barthess/volat3/soft/face/examples/test-drive-11.jpg

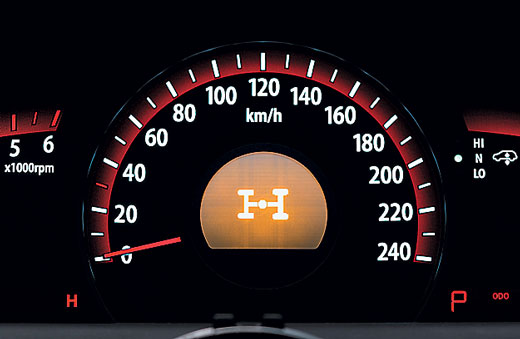
soft/face/examples/test-drive-11.jpg
