barthess/volat3/soft/face/examples/hyundai_grandeur_svision400.jpg

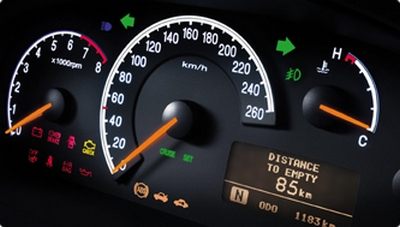
soft/face/examples/hyundai_grandeur_svision400.jpg
