barthess/volat3/doc/templates/passport/specs.tex

\section{Основные сведения об изделии и технические данные}
  \subsection{Основные сведения об изделии}
  
  %Предназначение
  \input{destination}
  
    \point {\nameDeviceAbbr} соответствует  группе  1.7  исполнения  О  по
      \gost{В 20.39.304-76} с уточнениями, приведенными 
      в~\ref{pt:impact_factors}.
    \point Наименование "--- \nameDevice.
    \point Обозначение "--- \ksauDevice.
    \point Изготовитель "--- \nameManufacturer.\par\bigskip
    \begin{tabular}{@{}ll}
      \multicolumn{2}{@{}l}{\addressManufacturer}\\
      тел./факс:  &(0-17) 200-57-98\\
      тел.:   &(0-17) 222-17-89\\
      e-mail :  &kamerton@kamerton.by\\
    \end{tabular}
    \par\bigskip
    \makebox[0.5\textwidth]{Заводской номер \hrulefill}\par 
    \makebox[0.5\textwidth]{Дата изготовления \hrulefill}

\newpage
  \subsection{Технические характеристики}
    \point Основные технические данные {\genitivecasename} приведены в 
    таблице~\ref{tab:replicator_specs}.

    \begin{table}[h]
      \caption{Основные технические характеристики {\genitivecasename}}
      \label{tab:replicator_specs}
      \input{./specs_table.tex}
    \end{table}

\newpage
    \point Значения внешних воздействующих факторов приведены 
      в таблице~\ref{tab:env_impact}.
      \label{pt:impact_factors}

    {
    \par
    \setcounter{tablerowcounter}{0} %сброс счетчика колонок (для самопального макроса \inTableEnum)
    \begin{table}[h!]
      \caption{Предельно допустимые значения внешних воздействующих факторов}
      \label{tab:env_impact}
      \input{\rootdir/documents/logbook/impact_table}
    \end{table}
    \par
    }

  \subsection{Показатель надёжности}
    Средняя наработка на отказ \genitivecasename "--- \MTBF~ч. 
    Критерий отказа "--- несоответствие значений параметров 
    техническим характеристикам, приведенным в 
    настоящем \MakeLowercase{\ESKDtheDocName}е.

  \subsection{Сведения о содержании драгоценных материалов и цветных
    металлов}
    \point В {\prepositionalcasename} содержатся следующие драгоценные 
      материалы\footnote{Сведения о содержании драгоценных материалов
      приведены комиссионно.}:

    \begin{itemize}
      \item \makebox[0.3\textwidth]{золото "--- \hfill г};
      \item \makebox[0.3\textwidth]{серебро "--- \hfill г}.
    \end{itemize}

    \point В {\prepositionalcasename} содержится алюминия и алюминиевых
      \mbox{сплавов "---\qquad\qquad кг}.
