barthess/volat3/doc/documents/component_parts/uvvu/ps/specs_data_additional.tex

% Tут собраны для основные технические спецификации
% устройства. 
% В отдельный файл они были вынесены исключительно
% для удобства включения в другие документы (например,
% руководство по эксплуатации)
 
\renewcommand{\nominalsupplypower}{20} % потребляемая мощность, ватты
