barthess/volat3/doc/documents/component_parts/uvvu/ps/specs_table.tex

% таблица просто форматирует включенные в нее данные

% данные для заполнения нижеследующей таблицы
\input{specs_data_additional.tex}

\begin{tabularx}{\textwidth}{|X|p{3.1cm}|p{3.1cm}|}
  \hline
  %--- шапка---------------------------------
  \multicolumn{1}{|c|}{Наименование параметра}&
  \multicolumn{1}{c|}{Значение}&
  \multicolumn{1}{c|}{Примечания}\\\hline 
  
  %-----содержимое---------------------------
  \setcounter{tablerowcounter}{0}
  \inTableEnum Допустимое напряжение бортовой сети, В   &от~{\minsupplyvoltage} до~\maxsupplyvoltage &\\\hline
  \inTableEnum Потребляемая мощность, Вт                &\nominalsupplypowerUVVU, \mbox{не более}  &\\\hline
  \inTableEnum Время непрерывной работы, часов          &\continuousworkingtime, \mbox{не менее} &\\\hline
  \inTableEnum Габаритные размеры, мм                   &\dimensionsUVVU, \mbox{не более}&\\\hline
  \inTableEnum Масса, кг, не более                      &\massUVVU & \\\hline

\end{tabularx}
