barthess/volat3/doc/tex/hyphenation.tex

\hyphenation{
БИУС
ГОСТ
ГЛОНАСС
АНРЕЛ
АВДАТ
РЕПЛИКАТОР
ис-пол-ни-тель-ных
При-ме-ча-ние
при-ме-ча-ние
Мне-мо-ни-чес-кое
}
