barthess/volat3/doc/templates/passport/packing_certificate.tex

\newpage

\section{Свидетельство об упаковывании}

\noindent
\nameksaunumber
\bigskip\noindent%
%
\blankfieldtxt[c]{\textwidth}
  {\centering\nameManufacturer}
  {наименование или код изготовителя}
  {упакован}
  {}
  \par
%
\bigskip\noindent согласно требованиям, предусмотренным в действующей технической документации.

\bigskip
\noindent%
  \blankfieldtxt{0.3\textwidth}{}{должность}{}{} \hfill
  \blankfieldtxt{0.3\textwidth}{}{личная подпись}{}{} \hfill
  \blankfieldtxt{0.3\textwidth}{}{расшифровка}{}{}

\bigskip
\noindent
  \blankfieldtxt{0.5\textwidth}{}{год, месяц, число}{}{}
