barthess/volat3/doc/templates/passport/utilization.tex

\newpage

\section{Сведения об утилизации}
	Утилизацию {\genitivecasename} проводит потребитель 
	по действующим у него нормативным документам 
	и положениям.

	Элементы, содержащие драгоценные материалы, 
	при демонтаже {\genitivecasename} подлежат учету, 
	хранению и сдаче в установленном порядке.
