barthess/volat3/doc/templates/passport/warranty.tex

\newpage

% при использовании 14 шрифта этот пункт совсем чуть-чуть
% не помещается на странице. Уменьшим межстрочный интервал
% для данной страницы с 1.25 до 1.20
{
\makeatletter
\ifthenelse{\equal{\ESKD@docfont}{14pt}} 
      {\renewcommand{\baselinestretch}{1.20}\selectfont}
      {} 
\makeatother

\section{Ресурсы, сроки службы и хранения, гарантии изготовителя
  (поставщика)}
  \subsection{Ресурсы, сроки службы и хранения}
    Ресурс  до первого капитального ремонта "--- пять 
    лет (при средней наработке на отказ \MTBF~ч) в
    течение среднего срока службы 20 лет, в том числе 
    срок хранения пять лет в упаковке изготовителя в 
    закрытых неотапливаемых помещениях.

    Средний срок сохраняемости в упаковке изготовителя "---
    10 лет с переконсервацией через пять лет.

    Указанные ресурсы, срок службы и срок хранения 
    действительны при соблюдении потребителем требований, 
    установленных эксплуатационной документацией.

  \subsection{Гарантии изготовителя (поставщика)}
    Изготовитель гарантирует соответствие качества {\genitivecasename}
    требованиям действующей технической документации при 
    соблюдении потребителем правил эксплуатации, хранения и 
    транспортирования, установленных эксплуатационной документацией.

    Гарантийный срок хранения совместно с гарантийным сроком эксплуатации 
    10 лет со дня ввода в эксплуатацию, но не более 11 лет со дня изготовления.

    Восстановление {\genitivecasename},
    \ifthenelse{\equal{\gender}{female}}
    {вышедшей}
    {вышедшего}
    из строя в течение 
    гарантийного срока, осуществляется за счет изготовителя. 
    При восстановлении (более суток) в гарантийный период, срок 
    гарантии на 
    \ifthenelse{\equal{\nameDevice}{\nameDeviceAbbr}}
    {\nameDeviceAbbr}
    {\MakeLowercase{\nameDevice}}
    продлевается на время восстановления.

    Потребитель утрачивает право на гарантийное обслуживание при:
    \begin{itemize}
      \item нарушении условий эксплуатации и хранения;
      \item утере {%
        \ifthenelse{\(\equal{\ESKDtheDocName}{Паспорт}\)\or\(\equal{\ESKDtheDocName}{Формуляр}\)}
        {\MakeLowercase{\ESKDtheDocName}а}
        {руководства по эксплуатации};}
      \item нарушении пломб;
      \item несанкционированных изменениях конструкции и схемы {\genitivecasename}.
    \end{itemize}
}
