barthess/volat3/soft/face/examples/1195866_1284969584.jpg

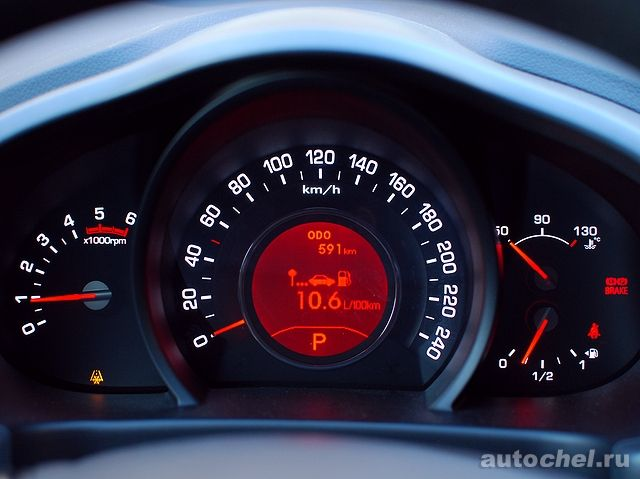
soft/face/examples/1195866_1284969584.jpg
