barthess/volat3/soft/face/examples/ceed4_554.jpg

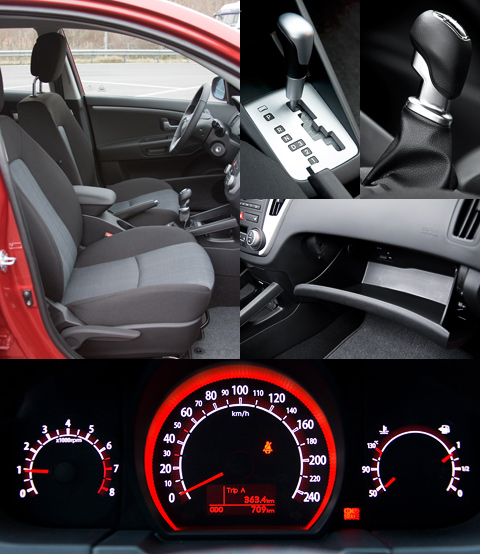
soft/face/examples/ceed4_554.jpg
