barthess/volat3/soft/face/examples/IMG_7119.jpg

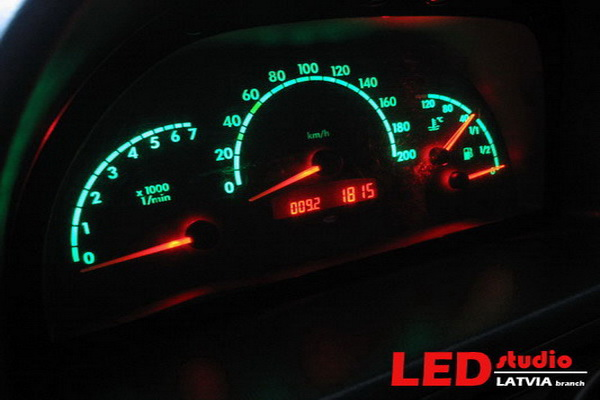
soft/face/examples/IMG_7119.jpg
