barthess/volat3/soft/face/examples/mzkt.png

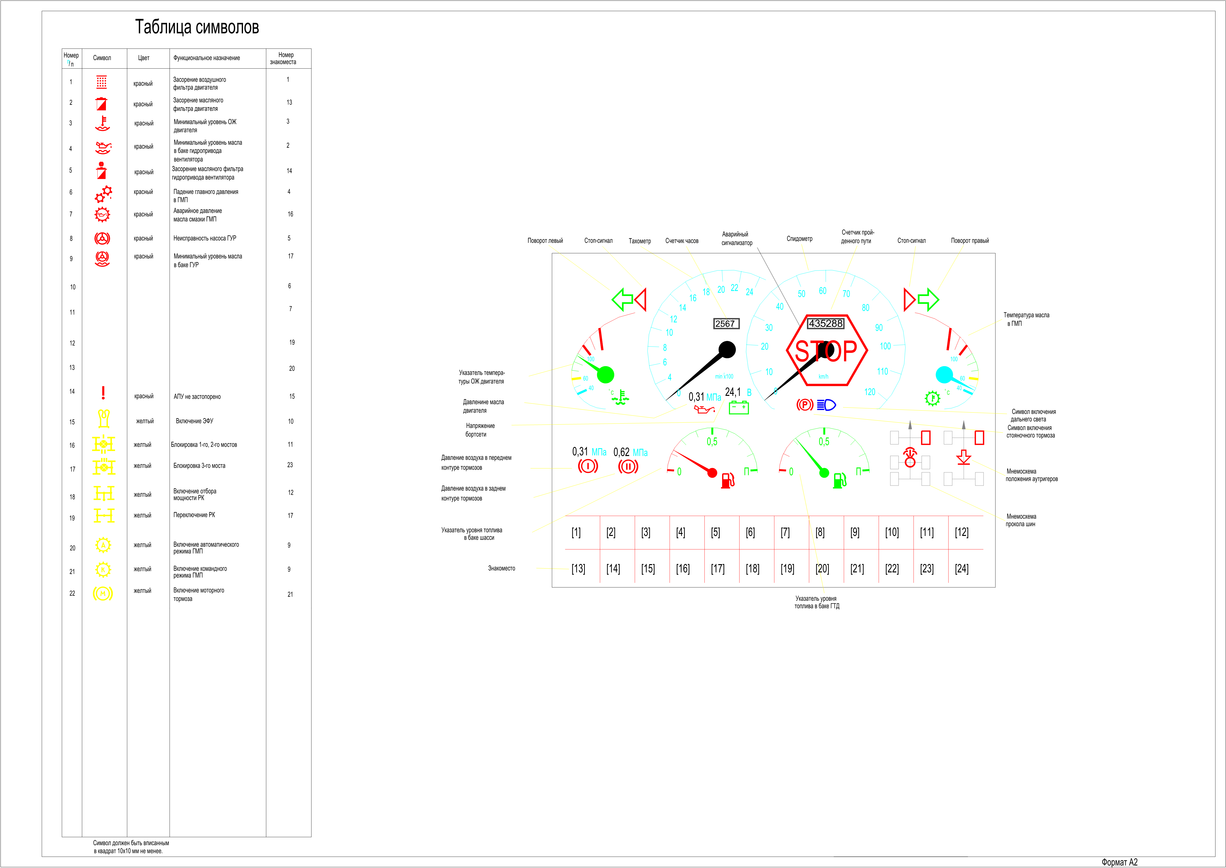
soft/face/examples/mzkt.png
