barthess/volat3/hard/mpiovd/bom/volat3-PARTSDB.tsv

Mfg Part Num | Mfg Name | VID | Vendor Part Num | Unit Price | Description (bom-ex) | Country of Origin | Customer Ref
STM32F103VDT6 | STMICROELECTRONICS | Farnell | 1624140 | $18,48 | MCU, 32BIT, CORTEXM3, 384KFLASH | France
LM2596S-5.0/NOPB | NATIONAL SEMICONDUCTOR | Farnell | 1469195 | $7,59 | IC, DC/DC CONVERTER, 3A | United States
IN74HC11AD | INTEGRAL | Integral |  |  | Triple 3AND
IN74HC123AD | INTEGRAL | Integral |  |  | Double monostable multivibrator
IN74HC165AD | INTEGRAL | Integral |  |  | 8-Bit Parallel-Input Serial-Output Shift Register
IN74HC595AD | INTEGRAL | Integral |  |  | 8-bit serial-in, parallel-out shift register
IN24AA32AD | INTEGRAL | Integral |  |  | EEPROM, I2C, 32K
SN65HVD232D | TEXAS INSTRUMENTS | Farnell | 1103107 | $5,17 | CAN TRANSCEIVER, SOIC8 | United States
USBUF01W6 | STMICROELECTRONICS | Mouser | 511-USBUF01W6 |  | ESD Suppressors EMI Filter/Line Term
IL5233G | INTEGRAL | Integral |  |  | POSITIVE VOLTAGE REGULATOR, 3V3, 800mA
ILX3232D | INTEGRAL | Integral |  |  | RS-232 transceiver, 3V3
SA555D | TEXAS INSTRUMENTS | Farnell | 9589945 | $0,88 | TIMER PRECISION, SMD, SOIC8, 555, -40°C to +85°C | Mexico
IL311AD | INTEGRAL | Integral |  |  | Voltage comparator
IL33091AD | INTEGRAL | Integral |  |  | MOSFET driver
LM2904M | NATIONAL SEMICONDUCTOR | Farnell | 9486860 | $0,72 | OP AMP, DUAL IND SPEC, 2904, SOIC8 | United Kingdom
IRFR430APBF | VISHAY FORMERLY I.R. | Farnell | 8658846 | $1,89 | MOSFET, N, 500V, 5A, D-PAK | Mexico
AUIPS7111S | INTERNATIONAL RECTIFIER | Farnell | 1925184 | $11,96 | IC, POWER LOAD SWITCH, 60 V, 5-TO-252 | Mexico
BC817 | NXP | Farnell | 1081223 | $0,07 | TRANSISTOR, NPN, SOT-23, 45V | Niger
VS-30BQ060TRPBF | VISHAY FORMERLY I.R. | Farnell | 8647887 | $1,94 | DIODE, SCHOTTKY, 3A, 60V, SMC | Taiwan
VS-10BQ060TRPBF | VISHAY FORMERLY I.R. | Farnell | 8647780 | $0,90 | DIODE, SCHOTTKY, 1A, 60V, SMB | Taiwan
IDD06SG60C | INFINEON | Farnell | 1844997 | $5,90 | DIODE, SCHOTTKY, 600V, 6A, DPACK | Malaysia
RS3M | MULTICOMP | Farnell | 1625195 | $0,57 | DIODE, FAST, 3A, 1000V, SMC | China
BAT54JFILM | STMICROELECTRONICS | Farnell | 9801502 | $0,15 | DIODE, SCHOTTKY, 40V, SOD-323 | France
1N4148WS-V-GS18 | VISHAY SEMICONDUCTOR | Farnell | 1612348 | $0,15 | DIODE, SMALL SIGNAL, 100V, SOD-323 | China
S1G-E3/61T | VISHAY GENERAL SEMICONDUCTOR | Farnell | 1837098 | $0,13 | STANDARD DIODE, 1A, 400V, SMA | China
BZV55-C3V3 | NXP | Farnell | 1097197 | $0,26 | DIODE,ZENER,3.3V,0.5W,SOD80C | Niger
KPHCM-2012EC-T | KINGBRIGHT | Farnell | 1686066 | $0,20 | LED, SMD, 0805, 20mA, RED | China
KPHCM-2012SGC-T | KINGBRIGHT | Farnell | 1686074 | $0,20 | LED, SMD, 0805, 20mA, GREEN | China
DR125-470-R | COILTRONICS | Farnell | 1612097 | $2,60 | INDUCTOR, 47UH, 20%, ~3A | China
DR127-470-R | COILTRONICS | Farnell | 1463529 | $3,70 | INDUCTOR, 47UH, 20%, ~3A | China
DR73-101-R | COILTRONICS | Farnell | 1463473 | $3,20 | INDUCTOR, 100UH, 20%, ~1A | China
RC0603FR-13100KL | YAGEO | Farnell | 1799369 | $0,01 | RESISTOR, 0603, 100k, 1%, 0.100W | Taiwan
RC0603FR-1010KL | YAGEO | Farnell | 1799358 | $0,01 | RESISTOR, 0603, 10k, 1%, 0.100W | Taiwan
RC0603JR-071K2L | YAGEO | Farnell | 9233393 | $0,08 | RESISTOR, 0603, 1K2, 5% | Taiwan
RC0603JR-072K2L | YAGEO | Farnell | 9233423 | $0,12 | RESISTOR, 0603, 2K2, 5% | Taiwan
RC0603JR-0722KL | YAGEO | Farnell | 9233547 | $0,12 | RESISTOR, 0603, 22K, 5% | Taiwan
RC0603JR-0751KL | YAGEO | Farnell | 1799438 | $0,01 | RESISTOR, 0603, 51K, 5% | Taiwan
RC0603FR-075K1L | YAGEO | Farnell | 1799348 | $0,00 | RESISTOR, 0603, 5.1KOHM, 100mW, 1% | Taiwan
ERJ3GEYJ391V | PANASONIC | Farnell | 2059590 | $0,01 | RESISTOR, 0603, 390R 5%, 0.1W | Japan
ERJ3GEYJ101V | PANASONIC | Farnell | 2059574 | $0,01 | RESISTOR, 0603, 100R 5%, 0.1W | Japan
ERJ6GEYJ102V | PANASONIC | Farnell | 2057701 | $0,03 | RESISTOR, 0805, 1K 5%, 0.125W | Japan
ERJ3GEYJ331V | PANASONIC | Farnell | 2059588 | $0,01 | RESISTOR, 0603, 330R 5%, 0.1W | Japan
ERJ3GEYJ473V | PANASONIC | Farnell | 2059646 | $0,01 | RESISTOR, 0603, 47K 5%, 0.1W | Japan
ERJ3GEYJ363V | PANASONIC | Farnell | 2059643 | $0,01 | RESISTOR, 0603, 36K 5%, 0.1W | Japan
ERJ6GEYJ153V | PANASONIC | Farnell | 2057721 | $0,03 | RESISTOR, 0805, 15K 5%, 0.125W | Japan
ERJ6GEY0R00V | PANASONIC | Farnell | 2057661 | $0,03 | RESISTOR, 0805, 0R 5%, 0.125W | Japan
ERJ6GEYJ474V | PANASONIC | Farnell | 2057737 | $0,03 | RESISTOR, 0805, 470K 5%, 0.125W | Japan
RC0805JR-0782KL | YAGEO | Farnell | 9234241 | $0,08 | RESISTOR, 0805, 82K, 5% | Taiwan
RC1206JR-074K7L | YAGEO | Farnell | 9240608 | $0,14 | RESISTOR, 1206, 4K7, 5% | Taiwan
RC1206JR-07120RL | YAGEO | Farnell | 9240411 | $0,09 | RESISTOR, 1206, 120R, 5% | Taiwan
RC2512FK-071KL | YAGEO | Farnell | 1283116 | $0,44 | RESISTOR, 2512, 1%, 1K, 1W | Taiwan
RC2512JK-071KL | YAGEO | Farnell | 9235957 | $0,38 | RESISTOR, 2512, 5%, 1K, 1W | Taiwan
35203K3JT | TE CONNECTIVITY / CGS | Farnell | 1265202 | $0,23 | RESISTOR, 2512, 5%, 3K3, 1W | Thailand
TSM4YJ102KR05 | VISHAY SFERNICE | Farnell | 1141345 | $3,81 | TRIMMER, SMD, 13 TURN, 1K0, 0.25W | France
C0603C105K4PACTU | KEMET | Farnell | 1288256 | $0,24 | CAPACITOR, 0603, 1UF, 16V, X5R | Mexico
C0603C104K5RACTU | KEMET | Farnell | 1288255 | $0,05 | CAPACITOR, 100NF, 50V, X7R,0603 | Mexico
C0603C103K5RACTU | KEMET | Farnell | 1414609 | $0,06 | CAPACITOR, 0603, 10NF, 50V, X7R | Mexico
C0603C220J5GACTU | KEMET | Farnell | 1414622 | $0,06 | CAPACITOR, 0603, 22PF, 50V, NP0 | Mexico
C0603C102K5RACTU | KEMET | Farnell | 1414608 | $0,04 | CAPACITOR, 0603, 1000pF, 50V, X7R | Mexico
C0603C562K5RACTU | KEMET | Farnell | 1865532 | $0,02 | CAPACITOR, 0603, X7R, 50V, 5600pF | Mexico
22205C106KAT2A | AVX | Farnell | 1657949 | $2,00 | CAPACITOR, 10 UF, 50V, 2220, X7R | Czech Republic
516D108M050QS6AE3 | VISHAY SPRAGUE | Farnell | 1351554 | $4,40 | CAPACITOR ALUM ELEC 1000UF, 50V, AXIAL | Japan
T491D227K010AT | KEMET | Farnell | 1457505 | $2,22 | CAPACITOR TANTALUM, CASE D, 220UF, 10V | Mexico
T491A106K010AT | KEMET | Farnell | 1457413 | $0,28 | CAPACITOR, CASE A, 10UF, 10V | Mexico
F931A336MBA | NICHICON | Farnell | 1818578 | $0,52 | CAPACITOR TANT, 33UF 10V, 1.4OHM, 3528-21 | Japan
SMBJ30CA | FAIRCHILD SEMICONDUCTOR | Farnell | 1017838 | $1,02 | DIODE, TVS, 30V, 600W, SMB, bidirectional | United States
SMBJ24CA | FAIRCHILD SEMICONDUCTOR | Farnell | 1017837 | $0,86 | DIODE, TVS, 24V, 600W, SMB, bidirectional | United States
SM6T220A | STMICROELECTRONICS | Farnell | 9885935 | $0,42 | DIODE, TVS, 220V, 600W, SMB, unidirectional | Italy
SM6T200A | STMICROELECTRONICS | Farnell | 9885919 | $0,46 | DIODE, TVS, 200V, 600W, SMB, unidirectional | Italy
SM6T6V8A | STMICROELECTRONICS | Farnell | 9802720 | $0,44 | DIODE, TVS, 6.8V, 600W, SMB, unidirectional | France
TCMT4100 | VISHAY | Farnell | 1779650 | $2,12 | OPTOCOUPLER. SMD 16PIN 4CH | China
CA-4.000-18-3050-X | AKER | Farnell | 1538733 | $2,85 | CRYSTAL, HC49/US, THT, 4.000MHZ | Hong Kong
1812L200DR | LITTELFUSE | Farnell | 1597009 | $0,90 | RESETTABLE FUSE, SMD 1812, 8V, 2A | Taiwan
1210L050YR | LITTELFUSE | Farnell | 1822208 | $0,88 | RESETTABLE FUSE, SMD 1210, 13.2V, 0.5A | Taiwan
4701-001LF | TUSONIX | Farnell | 1186432 | $5,71 | FILTER, PI, SMD | United States
NFE31PT152Z1E9 | MURATA | Farnell | 9528156 | $3,00 | FILTER, 1.5NF, 3 TERMINAL | Japan
EXC3BP121H | PANASONIC | Farnell | 1292698 | $0,19 | CHIP BEAD, 0603, 120OHM, 100MHZ | Japan
4-1437565-2 | TE CONNECTIVITY / ALCOSWITCH | Farnell | 2060823 | $0,40 | SWITCH, PUSHBUTTON, SMD | United Kingdom
90130-1216 | MOLEX | Mouser | 538-90130-1216 |  | HEADER, VERTICAL, 2ROW, 2.54mm, 16WAY
90130-1208 | MOLEX | Mouser | 538-90130-1208 |  | HEADER, VERTICAL, 2ROW, 2.54mm, 8WAY
90130-1234 | MOLEX | Mouser | 538-90130-1234 |  | HEADER, VERTICAL, 2ROW, 2.54mm, 34WAY
90119-2110 | MOLEX | Farnell | 9733272 | $0,26 | CRIMP SOCKET, 0.2mm^2..04,mm^2 | Ireland
90142-0034 | MOLEX | Mouser | 538-90142-0034 |  | RECEPTACLE, VERTICAL, 2ROW, 2.54mm, 34WAY
90142-0016 | MOLEX | Mouser | 538-90142-0016 |  | RECEPTACLE, VERTICAL, 2ROW, 2.54mm, 16WAY
90142-0008 | MOLEX | Mouser | 538-90142-0008 |  | RECEPTACLE, VERTICAL, 2ROW, 2.54mm, 8WAY
MC9A12-2034 | MULTICOMP | Farnell | 1099258 | $1,10 | HEADER, STRAIGHT, 20WAY, 2.54MM | China
825433-3 | TE CONNECTIVITY / AMP | Farnell | 3417657 | $0,57 | HEADER, 1ROW, 3WAY (PLS-3) | Hungary
825433-2 | TE CONNECTIVITY / AMP | Farnell | 3417645 | $1,10 | HEADER, 1ROW, 2WAY (PLS-2) | Hungary
MUBS1-05SN2 |  | BrownBear | USB/M-1J |  | MINI USB B, RECEPTACLE, R/A, SMT
