barthess/volat3/doc/documents/component_parts/uvvu/dev_pe4/KCAY.467239.018pe4.tex

\newcommand{\rootdir}{../../../..} % корень всех документов
\newcommand{\localtex}{\rootdir/tex} % локальные макросы
\newcommand{\templatedir}{\rootdir/templates} % шаблоны разных документов

\documentclass[russian,
  utf8,
  columnsxxiv,    % первичное применение
  % nocolumnxxxi,   % выкл. доп. поле <<копировал>>
  % nocolumnxxxii,  % выкл. доп. поле <<формат>>
  columnsxxvii,
  emptylinetop,
  emptylinebottom,
  footwhitespace=1]{eskdtab}
\usepackage{cmap}
\usepackage{eskdcmplist}
% \usepackage{eskdchngsheet}
\usepackage[T2A]{fontenc}
\usepackage{textcomp}
\renewcommand{\ESKDfontShape}{\upshape}

\usepackage{\localtex/commondata}
\newboolean{reading} % stub for table documents, remove it

\ESKDtitle{\large\nameUVVU}
\ESKDdocName{\vspace*{4mm}\normalsize{Перечень элементов}}
\ESKDsignature{\ksauUVVU[ПЭ4]}
\ESKDauthor{Пылинский}
\ESKDchecker{Малышко}
\ESKDapprovedBy{Михайлов}
\ESKDnormContr{Бурш}
\ESKDdate{2012/11/11}
\ESKDcolumnXXV{\ksauUVVU} % первичное применение

% ксау на разъемы типа 2РМ
\newcommand{\ksauRMDT}{\mbox{ГЕ0.364.126 ТУ}}
\newcommand{\molexdes}{<<Molex>> (контакты под обжим \mbox{90119-2110})}

\begin{document}

\begin{ESKDcomponentList}
  A1&\nameUVVUpcb{} \ksauUVVUpcb&1&\tabularnewline*
  &&&\tabularnewline

  X1&Колонка T51 <<Deltron>>&1&\tabularnewline*
  &&&\tabularnewline*
  &&&\tabularnewline

  &\centering Вилки &&\tabularnewline*
  &&&\tabularnewline*
  XP1       &2РМДТ33Б32Ш5В1В \ksauRMDT  &1&\tabularnewline*
  XP2       &2РМТ22Б10Ш1В1В \ksauRMDT   &1&\tabularnewline
  XP3       &2РМДТ27Б19Ш5В1В \ksauRMDT  &1&\tabularnewline
  XP4       &2РМДТ18Б4Ш5В1В \ksauRMDT   &1&\tabularnewline
  &&&\tabularnewline
  &&&\tabularnewline

  &\centering Розетки&&\tabularnewline*
  &&&\tabularnewline*
  XS1       &2РМДТ33Б32Г5В1В \ksauRMDT  &1&\tabularnewline*
  XS2...XS5 &90142-0016 \molexdes       &4&\tabularnewline
  XS6       &90142-0008 \molexdes       &1&\tabularnewline
  XS7       &90142-0016 \molexdes       &1&\tabularnewline
  XS8       &90142-0034 \molexdes       &1&\tabularnewline
  XS9, XS10 &90142-0008 \molexdes       &2&\tabularnewline
  XS11      &2РМДТ27Б19Г5В1В \ksauRMDT  &1&\tabularnewline
  XS12      &2РМТ22Б10Г1В1В \ksauRMDT   &1&\tabularnewline

\end{ESKDcomponentList}
\end{document}
