barthess/volat3/doc/documents/component_parts/uvvu/pcb_pe3/KCAY.469555.025pe3.tex

\newcommand{\rootdir}{../../../..} % корень всех документов
\newcommand{\localtex}{\rootdir/tex} % локальные макросы
\newcommand{\templatedir}{\rootdir/templates} % шаблоны разных документов

\documentclass[russian,
  utf8,
  columnsxxiv,    % первичное применение
  % nocolumnxxxi,   % выкл. доп. поле <<копировал>>
  % nocolumnxxxii,  % выкл. доп. поле <<формат>>
  columnsxxvii,
  emptylinetop,
  emptylinebottom,
  footwhitespace=1]{eskdtab}
\input{\localtex/common_packages.tex}
\usepackage{eskdcmplist}
\usepackage{eskdchngsheet}
\usepackage[T2A]{fontenc}
\usepackage{textcomp}
\renewcommand{\ESKDfontShape}{\upshape}

\usepackage{\localtex/commondata}
\newboolean{reading} % stub for table documents, remove it

\ESKDtitle{\nameUVVUpcb}
\ESKDdocName{\vspace*{4mm}\large{Перечень элементов}}
\ESKDsignature{\ksauUVVUpcb[ПЭ3]}
\ESKDauthor{Пылинский}
\ESKDchecker{Малышко}
\ESKDapprovedBy{Михайлов}
\ESKDnormContr{Бурш}
\ESKDdate{2012/11/11}
\ESKDcolumnXXV{\ksauUVVUpcb} % первичное применение

\begin{document}
\begin{ESKDcomponentList}
  \input{pe3_table.tex}
\end{ESKDcomponentList}
\begin{ESKDchangeSheet}
  \ESKDchangeSheetFill
\end{ESKDchangeSheet}
\end{document}
