barthess/volat3/doc/documents/component_parts/uvvu/pcb_e3/KCAY.469555.025e3.tex

\newcommand{\rootdir}{../../../..} % корень всех документов
\newcommand{\localtex}{\rootdir/tex} % локальные макросы
\newcommand{\templatedir}{\rootdir/templates} % шаблоны разных документов

\documentclass[
  russian,
  utf8,
  columnsxxiv,    % первичное применение
  % nocolumnxxxi,   % выкл. доп. поле <<копировал>>
  % nocolumnxxxii,  % выкл. доп. поле <<формат>>
  columnsxxvii,
  a1paper,
  % portrait,
  ignorestamp]{eskdgraph}

\usepackage[T2A]{fontenc}
\renewcommand{\ESKDfontShape}{\upshape}
\usepackage{\localtex/commondata}
\usepackage{eskdfreesize}
\newboolean{reading} % stub for table documents, remove it

\ESKDtitle{\nameUVVUpcb}
\ESKDdocName{\vspace*{4mm}\large{Схема электрическая принципиальная}}
\ESKDsignature{\ksauUVVUpcb[Э3]}
\ESKDauthor{Пылинский}
\ESKDchecker{Малышко}
\ESKDapprovedBy{Михайлов}
\ESKDnormContr{Бурш}
\ESKDdate{2012/11/11}
\ESKDcolumnXXV{\ksauUVVUpcb} % первичное применение

\unitlength=1mm
\begin{document}

\begin{picture}(0,0)
  \put(-30,-575){} % 575 = (594-19)
\end{picture}

\ESKDlandscapeAII{
\begin{picture}(0,0)
  \put(-30,-401){} %(420 - 19)
\end{picture}
}

\ESKDlandscapeAI{
\begin{picture}(0,0)
  \put(-30,-575){} %(420 - 19)
\end{picture}
}

\ESKDportraitAIII{
\begin{picture}(0,0)
  \put(-30,-401){}
\end{picture}
}

\ESKDportraitAI{
\begin{picture}(0,0)
  \put(-30,-822){}
\end{picture}
\clearpage
\begin{picture}(0,0)
  \put(-30,-822){}
\end{picture}
\clearpage
\begin{picture}(0,0)
  \put(-30,-822){}
\end{picture}
\clearpage
\begin{picture}(0,0)
  \put(-30,-822){}
\end{picture}
}

\ESKDlandscapeAII{
\begin{picture}(0,0)
  \put(-30,-401){}
\end{picture}
}

\ESKDlandscapeAIII{
\begin{picture}(0,0)
  \put(-30,-278){}
\end{picture}
}

\end{document}
% vim:tw=70
