barthess/volat3/doc/documents/component_parts/uvvu/ps/completeness_content.tex

\nameDevice\newline \ksauDevice&1&&\\\hline
\ESKDtheDocName\newline \ksauDevice[\ESKDtheDocNameAbbr]&1 &&\\\hline
Упаковка& 1 & & Подборная \newline упаковка\newline изготовителя\\\hline
