barthess/volat3/doc/documents/component_parts/uvvu/ps/destination.tex

%подключается в файле /templates/passport/specs

\point {\nameDevice} ({\nameDeviceAbbr}) предназначен:
  \begin{itemize}
    \item для сбора информации с дискретных, аналоговых и частотных
      датчиков шасси, ее предварительной обработки и передачи в 
      вычислитель бортовой ВБ;
    \item для управления исполнительными механизмами шасси.
  \end{itemize}
