barthess/volat3/doc/documents/component_parts/uvvu/dev_pe4/KCAY.469555.025pe3.tex

\newcommand{\rootdir}{../../../..} % корень всех документов
\newcommand{\localtex}{\rootdir/tex} % локальные макросы
\newcommand{\templatedir}{\rootdir/templates} % шаблоны разных документов

\documentclass[russian,
  utf8,
  columnsxxiv,    % первичное применение
  nocolumnxxxi,   % выкл. доп. поле <<копировал>>
  nocolumnxxxii,  % выкл. доп. поле <<формат>>
  columnsxxvii,
  emptylinetop,
  emptylinebottom,
  footwhitespace=1]{eskdtab}
\usepackage{eskdcmplist}
\usepackage{eskdchngsheet}
\usepackage[T2A]{fontenc}
\usepackage{textcomp}
\renewcommand{\ESKDfontShape}{\upshape}

\usepackage{\localtex/commondata}
\newboolean{reading} % stub for table documents, remove it

\ESKDtitle{\nameUVVU}
\ESKDdocName{\vspace*{4mm}\large{Перечень элементов}}
\ESKDsignature{\ksauUVVU[ПЭ4]}
\ESKDauthor{Пылинский}
\ESKDchecker{Мылышко}
\ESKDapprovedBy{Михайлов}
\ESKDnormContr{Бурш}
\ESKDdate{2012/11/11}
\ESKDcolumnXXV{\ksauMain} % первичное применение

% ксау на разъемы типа 2РМ
\newcommand{\ksauRMDT}{\mbox{ГЕО.364126 ТУ}}

\begin{document}

\begin{ESKDcomponentList}
  A1&\nameUVVUpcb{} \ksauUVVUpcb&1&\tabularnewline*
  &&&\tabularnewline

  X1&Колонка T51 (<<Deltron>>)&1&\tabularnewline*
  &&&\tabularnewline*
  &&&\tabularnewline

  1&\centering\underline{Жгут М1 КСАУ.123456.789}&1&\tabularnewline*
  &&&\tabularnewline*
  XP1&Вилка 2РМДТ33Б32Ш5В1В \ksauRMDT&1&\tabularnewline*
  XS2,XS3&Розетка 90142-0016 (<<Molex>>)&2&\tabularnewline*
  &&&\tabularnewline
  &&&\tabularnewline

  2&\centering\underline{Жгут М2 КСАУ.123456.789}&1&\tabularnewline*
  &&&\tabularnewline*
  XS1&Розетка 2РМДТ33Б32Г5В1В \ksauRMDT&1&\tabularnewline*
  XS4,XS5&Розетка 90142-0016 (<<Molex>>)&2&\tabularnewline*
  &&&\tabularnewline
  &&&\tabularnewline

  3&\centering\underline{Жгут М3 КСАУ.123456.789}&1&\tabularnewline*
  &&&\tabularnewline*
  XP2&Вилка 2РМТ22Б10Ш1В1В \ksauRMDT&1&\tabularnewline*
  XS6&Розетка 90142-0008 (<<Molex>>)&1&\tabularnewline*
  &&&\tabularnewline
  &&&\tabularnewline

  4&\centering\underline{Жгут М4 КСАУ.123456.789}&1&\tabularnewline*
  &&&\tabularnewline*
  XS11&Розетка 2РМДТ27Б19Г5В1В \ksauRMDT&1&\tabularnewline*
  XS7&Розетка 90142-0016 (<<Molex>>)&1&\tabularnewline*
  &&&\tabularnewline
  &&&\tabularnewline

  5&\centering\underline{Жгут М5 КСАУ.123456.789}&1&\tabularnewline*
  &&&\tabularnewline*
  XP3&Вилка 2РМДТ27Б19Ш5В1В \ksauRMDT&1&\tabularnewline*
  XS8&Розетка 90142-0034 (<<Molex>>)&1&\tabularnewline*
  &&&\tabularnewline
  &&&\tabularnewline

  6&\centering\underline{Жгут М6 КСАУ.123456.789}&1&\tabularnewline*
  &&&\tabularnewline*
  XP4&Вилка 2РМДТ18Б4Ш5В1В \ksauRMDT&1&\tabularnewline*
  XS9&Розетка 90142-0008 (<<Molex>>)&1&\tabularnewline*
  &&&\tabularnewline
  &&&\tabularnewline

  7&\centering\underline{Жгут М6 КСАУ.123456.789}&1&\tabularnewline*
  &&&\tabularnewline*
  XS12&Розетка 2РМТ22Б10Г1В1В \ksauRMDT&1&\tabularnewline*
  XS10&Розетка 90142-0008 (<<Molex>>)&1&\tabularnewline*
  &&&\tabularnewline
  &&&\tabularnewline

\end{ESKDcomponentList}

\begin{ESKDchangeSheet}
  \ESKDchangeSheetFill
\end{ESKDchangeSheet}
\end{document}
