barthess/volat3/doc/templates/passport/usage_storage.tex

\newpage

\section{Заметки по эксплуатации и хранению}

	\subsection{Эксплуатация}
		\point Эксплуатация {\genitivecasename} производится в соответствии 
			с требованиями документа <<\nameMain. Руководство по эксплуатации
			\ksauMain[РЭ]>>.

	\subsection{Хранение}
		\point {\nameDevice} в упаковке изготовителя должен 
			храниться в закрытом неотапливаемом помещении 
			с естественной вентиляцией воздуха при температуре 
			от~{\temperaturestoragemin} 
			до~\temperaturestoragemax~\textcelsius\ и относительной 
			влажности воздуха не более 98\% при 
			температуре~\airhumiditywithtemp~\textcelsius\ без конденсации влаги.
