barthess/volat3/doc/templates/passport/test_certificate.tex

\newpage

\section{Свидетельство о приемке}

\noindent%
\nameksaunumber
\bigskip
  \noindent изготовлен и принят в соответствии с обязательными требованиями 
  государственных (национальных) стандартов, действующей технической 
  документацией и признан годным для эксплуатации.\par
\bigskip

\begin{centering} 
  \ \par Начальник ОТК \par
\end{centering}
\bigskip
\MPscript
\vfill
%\vspace{5cm}
\noindent \parbox{0.3\textwidth}{Руководитель\\ предприятия}
\hfill \blankfieldtxt[t]{0.5\textwidth}{\centering\ksauMain[ТУ]}{
  обозначение документа,\par по которому производится поставка}{}{}

\bigskip
\MPscript
