barthess/volat3/doc/templates/passport/repair.tex

\newpage

\section{Ремонт}

\subsection{Краткие записи о произведенном ремонте}

\noindent
\nameksaunumber
\bigskip
\noindent
\blankfieldtxt{0.7\textwidth}{}{предприятие; дата}{}{}

\bigskip
\noindent
Наработка с начала\\
\blankfieldtxt[c]{\textwidth}{}
  {параметр, характеризующий ресурс или срок службы}{эксплуатации}{}

\bigskip
\noindent
Наработка после последнего\\ 
\blankfieldtxt[c]{\textwidth}{}
  {параметр, характеризующий ресурс или срок службы}{ремонта}{}

% \vspace{5ex}
\noindent
\blankfieldtxt[c]{\textwidth}{}
  {}{Причина поступления в ремонт}{}

\noindent
\blankfieldtxt[c]{\textwidth}{}
  {}{}{}

% \vspace{5ex}%
\noindent%
\blankfieldtxt[c]{\textwidth}{}
  {вид ремонта и краткие}{Сведения о произведенном ремонте}{}
\noindent
\blankfieldtxt[c]{\textwidth}{}
  {сведения о ремонте}{}{}

\noindent\blankfieldtxt[c]{\textwidth}{}
  {}{}{}

\newpage

\subsection{Свидетельство о приемке и гарантии}
\noindent
\nameksaunumber

\noindent
\blankfieldtxt[c]{0.3\textwidth}{}
  {вид ремонта}{}{}\hfill 
\blankfieldtxt[c]{0.3\textwidth}{}
  {наименование предприятия, \\ условное обозначение}{}{}\hfill
\blankfieldtxt[c]{0.35\textwidth}{}
  {вид документа}{согласно}{}

\bigskip
\noindent Принят в соответствии с обязательными требованиями 
государственных (национальных) стандартов и действующей технической 
документацией и признан годным для эксплуатации.

\noindent
\blankfieldtxt[с]{\textwidth}{}
  {параметр, определяющий}{Ресурс до очередного ремонта}{}

\noindent
\blankfieldtxt[с]{0.85\textwidth}{}
  {ресурс}
  {}
  {в течение срока службы}
\hfill
\blankfieldtxt[с]{0.15\textwidth}{}
{}{}{лет}

\noindent
\blankfieldtxt[с]{\textwidth}{}
  {условия хранения лет (года)}
  {(года), в том числе срок хранения}
  {}

\bigskip{}\bigskip
Исполнитель ремонта гарантирует соответствие 
изделия требованиям действующей технической 
документации при соблюдении потребителем требований 
действующей эксплуатационной документации.

\begin{centering} 
  \ \par\bigskip Начальник ОТК \par
\end{centering}
\bigskip
\MPscript
