barthess/volat3/hard/mpiovd/mpiovd.brd

## EAGLE design hard/mpiovd/mpiovd.brd (2012-06-20)

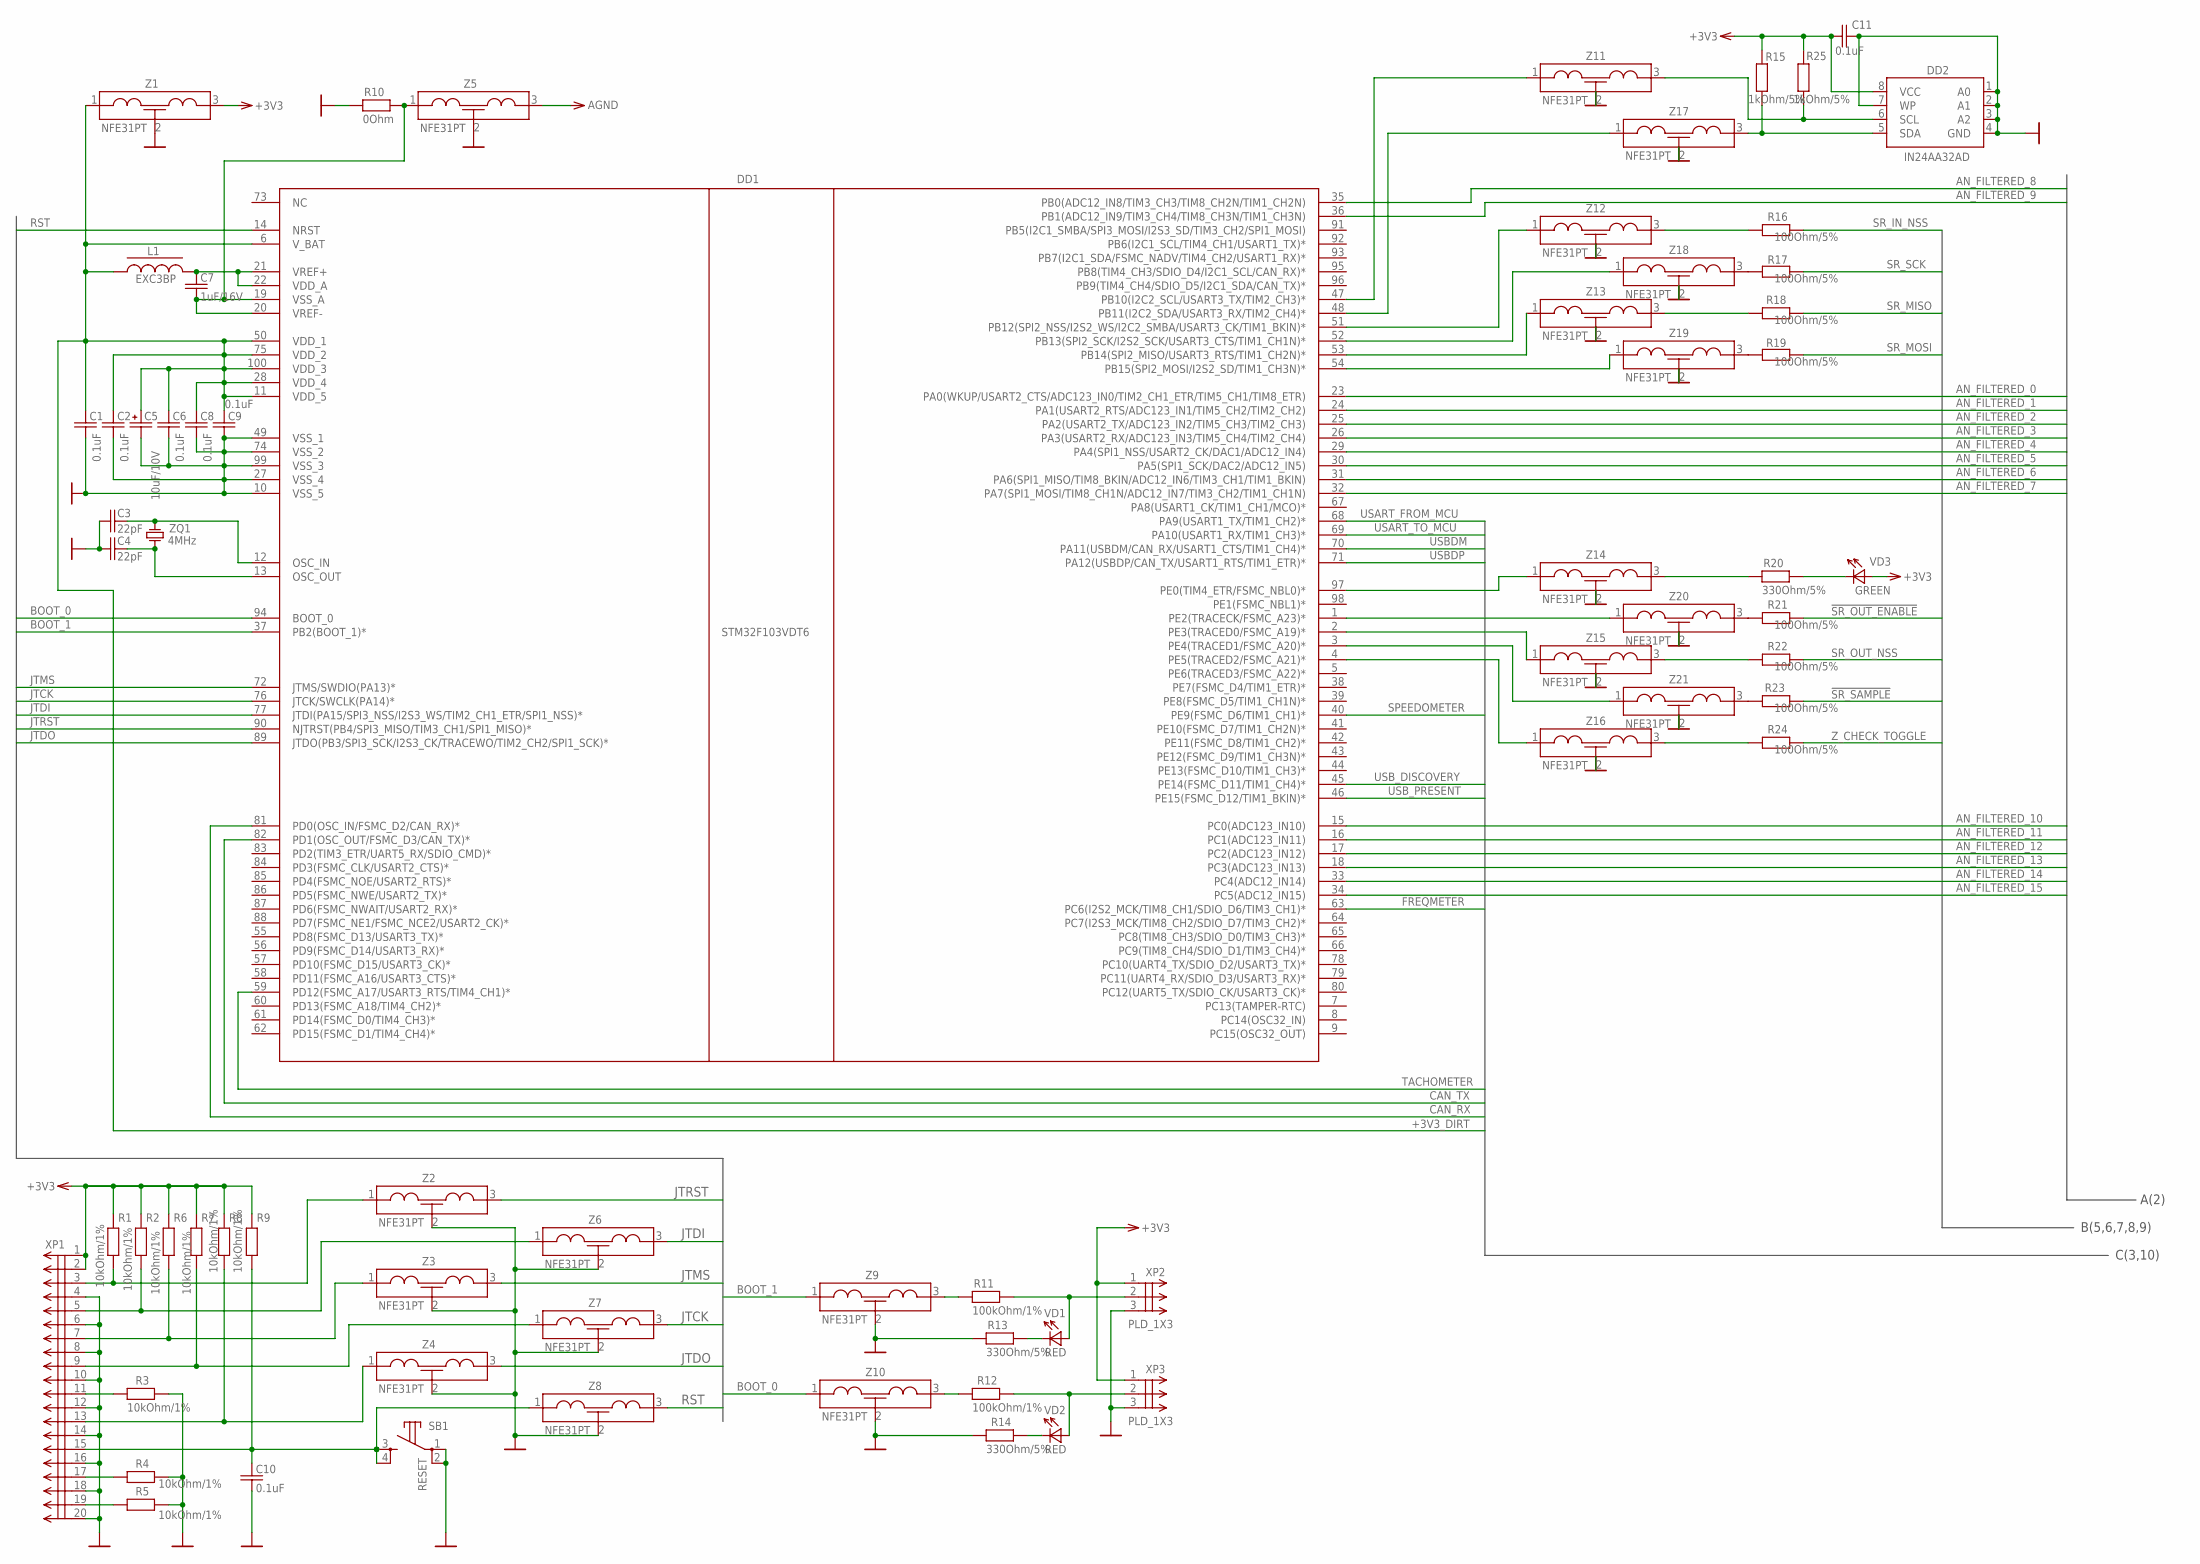
[picture p7: schematic mpiovd.sch, sheet 1, mcu]

Parts:
C1, C2, C6, C8, C9, C10, C11: 0.1uF; C0603; PARTNO C0603C104K5RACTU
C3, C4: 22pF; C0603; PARTNO C0603C220J5GACTU
C5: 10uF/10V; A/3216-18W; PARTNO T491A106K010AT
C7: 1uF/16V; C0603; PARTNO C0603C105K4PACTU
DD1: STM32F103VDT6; TQFP100; PARTNO STM32F103VDT6
DD2: IN24AA32AD; SO08; PARTNO IN24AA32AD
L1: EXC3BP; L0603; PARTNO EXC3BP121H
R1, R2, R3, R4, R5, R6, R7, R8, R9: 10kOhm/1%; R0603; PARTNO RC0603FR-1010KL
R10: 0Ohm; R0805; PARTNO ERJ6GEY0R00V
R11, R12: 100kOhm/1%; R0603; PARTNO RC0603FR-13100KL
R13, R14, R20: 330Ohm/5%; R0603; PARTNO ERJ3GEYJ331V
R15, R25: 1kOhm/5%; R0805; PARTNO ERJ6GEYJ102V
R16, R17, R18, R19, R21, R22, R23, R24: 100Ohm/5%; R0603; PARTNO ERJ3GEYJ101V
SB1: RESET; B3S-10XX; PARTNO 4-1437565-2
VD1, VD2: RED; LED-0805; PARTNO KPHCM-2012EC-T
VD3: GREEN; LED-0805; PARTNO KPHCM-2012SGC-T
XP1: PLD_2X10-SHROUDED; PLD_2X10_SHROUDED; PARTNO MC9A12-2034
XP2, XP3: PLD_1X3; PLD_1X03; PARTNO 825433-3
Z1, Z2, Z3, Z4, Z5, Z6, Z7, Z8, Z9, Z10, Z11, Z12, Z13, Z14, Z15, Z16, Z17, Z18, Z19, Z20, Z21: NFE31PT; NFE31; PARTNO NFE31PT152Z1E9
ZQ1: 4MHz; HC49U-V; PARTNO CA-4.000-18-3050-X

Connections:
!SR_OUT_ENABLE: R21.1; also elsewhere on the board
!SR_SAMPLE: R23.1; also elsewhere on the board
+3V3: C11.2, DD2.8 (VCC), R1.2, R2.2, R6.2, R7.2, R8.2, R9.2, R15.1, R25.1, VD3.A, XP1.1, XP1.2, XP2.1, XP3.1, Z1.3; also elsewhere on the board
+3V3_DIRT: C1.1, C2.1, C5.+, C6.1, C8.1, C9.1, DD1.6 (V_BAT), DD1.11 (VDD_5), DD1.28 (VDD_4), DD1.50 (VDD_1), DD1.75 (VDD_2), DD1.100 (VDD_3), L1.1, Z1.1; also elsewhere on the board
AGND: Z5.3; also elsewhere on the board
AN_FILTERED_0: DD1.23 (PA0(WKUP/USART2_CTS/ADC123_IN0/TIM2_CH1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); also elsewhere on the board
AN_FILTERED_1: DD1.24 (PA1(USART2_RTS/ADC123_IN1/TIM5_CH2/TIM2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); also elsewhere on the board
AN_FILTERED_2: DD1.25 (PA2(USART2_TX/ADC123_IN2/TIM5_CH3/TIM2_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); also elsewhere on the board
AN_FILTERED_3: DD1.26 (PA3(USART2_RX/ADC123_IN3/TIM5_CH4/TIM2_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); also elsewhere on the board
AN_FILTERED_4: DD1.29 (PA4(SPI1_NSS/USART2_CK/DAC1/ADC12_IN4)); also elsewhere on the board
AN_FILTERED_5: DD1.30 (PA5(SPI1_SCK/DAC2/ADC12_IN5)); also elsewhere on the board
AN_FILTERED_6: DD1.31 (PA6(SPI1_MISO/TIM8_BKIN/ADC12_IN6/TIM3_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); also elsewhere on the board
AN_FILTERED_7: DD1.32 (PA7(SPI1_MOSI/TIM8_CH1N/ADC12_IN7/TIM3_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); also elsewhere on the board
AN_FILTERED_8: DD1.35 (PB0(ADC12_IN8/TIM3_CH3/TIM8_CH2N/TIM1_C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); also elsewhere on the board
AN_FILTERED_9: DD1.36 (PB1(ADC12_IN9/TIM3_CH4/TIM8_CH3N/TIM1_C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); also elsewhere on the board
AN_FILTERED_10: DD1.15 (PC0(ADC123_IN10)); also elsewhere on the board
AN_FILTERED_11: DD1.16 (PC1(ADC123_IN11)); also elsewhere on the board
AN_FILTERED_12: DD1.17 (PC2(ADC123_IN12)); also elsewhere on the board
AN_FILTERED_13: DD1.18 (PC3(ADC123_IN13)); also elsewhere on the board
AN_FILTERED_14: DD1.33 (PC4(ADC12_IN14)); also elsewhere on the board
AN_FILTERED_15: DD1.34 (PC5(ADC12_IN15)); also elsewhere on the board
BOOT_0: DD1.94 (BOOT_0), Z10.1
BOOT_1: DD1.37 (PB2(BOOT_1)*), Z9.1
CAN_RX: DD1.81 (PD0(OSC_IN/FSMC_D2/CAN_RX)*); also elsewhere on the board
CAN_TX: DD1.82 (PD1(OSC_OUT/FSMC_D3/CAN_TX)*); also elsewhere on the board
FREQMETER: DD1.63 (PC6(I2S2_MCK/TIM8_CH1/SDIO_D6/TIM3_CH1)*); also elsewhere on the board
GND: C1.2, C2.2, C3.2, C4.2, C5.-, C6.2, C8.2, C9.2, C10.2, C11.1, DD1.10 (VSS_5), DD1.27 (VSS_4), DD1.49 (VSS_1), DD1.74 (VSS_2), DD1.99 (VSS_3), DD2.1 (A0), DD2.2 (A1), DD2.3 (A2), DD2.4 (GND), DD2.7 (WP), R3.2, R4.2, R5.2, R10.1, R13.1, R14.1, SB1.1, SB1.2, XP1.4, XP1.6, XP1.8, XP1.10, XP1.12, XP1.14, XP1.16, XP1.18, XP1.20, XP2.3, XP3.3, Z1.2, Z2.2, Z3.2, Z4.2, Z5.2, Z6.2, Z7.2, Z8.2, Z9.2, Z10.2, Z11.2, Z12.2, Z13.2, Z14.2, Z15.2, Z16.2, Z17.2, Z18.2, Z19.2, Z20.2, Z21.2; also elsewhere on the board
I2C_SCL: DD1.47 (PB10(I2C2_SCL/USART3_TX/TIM2_CH3)*), Z11.1
I2C_SDA: DD2.5 (SDA), R15.2, Z17.3
JTCK: DD1.76 (JTCK/SWCLK(PA14)*), Z7.3
JTDI: DD1.77 (JTDI(PA15/SPI3_NSS/I2S3_WS/TIM2_CH1_ETR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), Z6.3
JTDO: DD1.89 (JTDO(PB3/SPI3_SCK/I2S3_CK/TRACEWO/TIM2_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), Z4.3
JTMS: DD1.72 (JTMS/SWDIO(PA13)*), Z3.3
JTRST: DD1.90 (NJTRST(PB4/SPI3_MISO/TIM3_CH1/SPI1_MISO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), Z2.3
unnamed: R5.1, XP1.19
unnamed: R4.1, XP1.17
unnamed: C4.1, DD1.13 (OSC_OUT), ZQ1.1
unnamed: C3.1, DD1.12 (OSC_IN), ZQ1.2
unnamed: DD1.51 (PB12(SPI2_NSS/I2S2_WS/I2C2_SMBA/USART3_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), Z12.1
unnamed: R3.1, XP1.11
unnamed: R12.2, VD2.A, XP3.2
unnamed: R11.2, VD1.A, XP2.2
unnamed: R13.2, VD1.C
unnamed: DD1.52 (PB13(SPI2_SCK/I2S2_SCK/USART3_CTS/TIM1_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), Z18.1
unnamed: DD1.53 (PB14(SPI2_MISO/USART3_RTS/TIM1_CH2N)*), Z13.1
unnamed: DD1.54 (PB15(SPI2_MOSI/I2S2_SD/TIM1_CH3N)*), Z19.1
unnamed: DD1.1 (PE2(TRACECK/FSMC_A23)*), Z20.1
unnamed: C7.1, DD1.21 (VREF+), DD1.22 (VDD_A), L1.2
unnamed: R14.2, VD2.C
unnamed: R20.2, VD3.C
unnamed: R20.1, Z14.3
unnamed: DD1.2 (PE3(TRACED0/FSMC_A19)*), Z15.1
unnamed: DD1.3 (PE4(TRACED1/FSMC_A20)*), Z21.1
unnamed: DD1.4 (PE5(TRACED2/FSMC_A21)*), Z16.1
unnamed: C7.2, DD1.19 (VSS_A), DD1.20 (VREF-), R10.2, Z5.1
unnamed: R12.1, Z10.3
unnamed: R11.1, Z9.3
unnamed: R1.1, XP1.3, Z2.1
unnamed: R2.1, XP1.5, Z6.1
unnamed: R6.1, XP1.7, Z3.1
unnamed: C10.1, R9.1, SB1.3, SB1.4, XP1.15, Z8.1
unnamed: R7.1, XP1.9, Z7.1
unnamed: R8.1, XP1.13, Z4.1
unnamed: DD1.48 (PB11(I2C2_SDA/USART3_RX/TIM2_CH4)*), Z17.1
unnamed: DD2.6 (SCL), R25.2, Z11.3
unnamed: DD1.97 (PE0(TIM4_ETR/FSMC_NBL0)*), Z14.1
unnamed: R21.2, Z20.3
unnamed: R22.2, Z15.3
unnamed: R23.2, Z21.3
unnamed: R24.2, Z16.3
unnamed: R16.2, Z12.3
unnamed: R18.2, Z13.3
unnamed: R17.2, Z18.3
unnamed: R19.2, Z19.3
RST: DD1.14 (NRST), Z8.3
SPEEDOMETER: DD1.40 (PE9(FSMC_D6/TIM1_CH1)*); also elsewhere on the board
SR_IN_NSS: R16.1; also elsewhere on the board
SR_MISO: R18.1; also elsewhere on the board
SR_MOSI: R19.1; also elsewhere on the board
SR_OUT_NSS: R22.1; also elsewhere on the board
SR_SCK: R17.1; also elsewhere on the board
TACHOMETER: DD1.59 (PD12(FSMC_A17/USART3_RTS/TIM4_CH1)*); also elsewhere on the board
USART_FROM_MCU: DD1.68 (PA9(USART1_TX/TIM1_CH2)*); also elsewhere on the board
USART_TO_MCU: DD1.69 (PA10(USART1_RX/TIM1_CH3)*); also elsewhere on the board
USBDM: DD1.70 (PA11(USBDM/CAN_RX/USART1_CTS/TIM1_CH4)*); also elsewhere on the board
USBDP: DD1.71 (PA12(USBDP/CAN_TX/USART1_RTS/TIM1_ETR)*); also elsewhere on the board
USB_DISCOVERY: DD1.45 (PE14(FSMC_D11/TIM1_CH4)*); also elsewhere on the board
USB_PRESENT: DD1.46 (PE15(FSMC_D12/TIM1_BKIN)*); also elsewhere on the board
Z_CHECK_TOGGLE: R24.1; also elsewhere on the board

Notes on the sheet:
A(2)
C(3,10)
B(5,6,7,8,9)

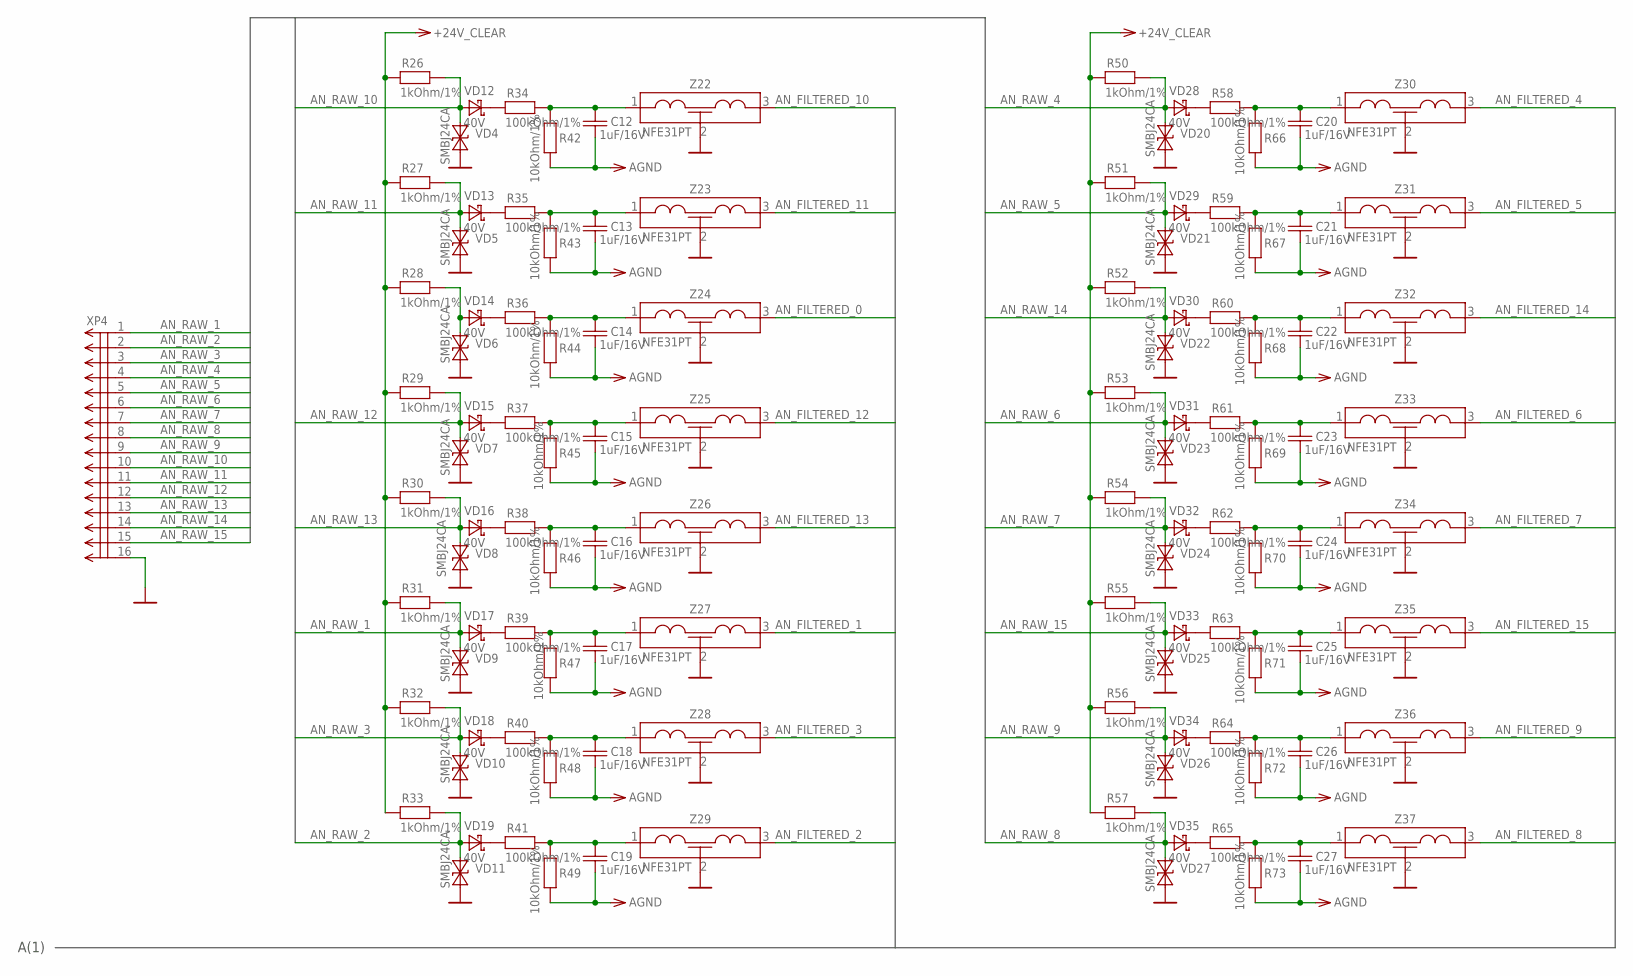
[picture p8: schematic mpiovd.sch, sheet 2, analog]

Parts:
C12, C13, C14, C15, C16, C17, C18, C19, C20, C21, C22, C23, C24, C25, C26, C27: 1uF/16V; C0603; PARTNO C0603C105K4PACTU
R26, R27, R28, R29, R30, R31, R32, R33, R50, R51, R52, R53, R54, R55, R56, R57: 1kOhm/1%; R2512; PARTNO RC2512FK-071KL
R34, R35, R36, R37, R38, R39, R40, R41, R58, R59, R60, R61, R62, R63, R64, R65: 100kOhm/1%; R0603; PARTNO RC0603FR-13100KL
R42, R43, R44, R45, R46, R47, R48, R49, R66, R67, R68, R69, R70, R71, R72, R73: 10kOhm/1%; R0603; PARTNO RC0603FR-1010KL
VD4, VD5, VD6, VD7, VD8, VD9, VD10, VD11, VD20, VD21, VD22, VD23, VD24, VD25, VD26, VD27: SMBJ24CA; SMB-BIDIR; PARTNO SMBJ24CA
VD12, VD13, VD14, VD15, VD16, VD17, VD18, VD19, VD28, VD29, VD30, VD31, VD32, VD33, VD34, VD35: 40V; SOD323; PARTNO BAT54JFILM
XP4: MOLEX-90130-16; PARTNO 90130-1216
Z22, Z23, Z24, Z25, Z26, Z27, Z28, Z29, Z30, Z31, Z32, Z33, Z34, Z35, Z36, Z37: NFE31PT; NFE31; PARTNO NFE31PT152Z1E9

Connections:
+24V_CLEAR: R26.1, R27.1, R28.1, R29.1, R30.1, R31.1, R32.1, R33.1, R50.1, R51.1, R52.1, R53.1, R54.1, R55.1, R56.1, R57.1; also elsewhere on the board
AGND: C12.2, C13.2, C14.2, C15.2, C16.2, C17.2, C18.2, C19.2, C20.2, C21.2, C22.2, C23.2, C24.2, C25.2, C26.2, C27.2, R42.1, R43.1, R44.1, R45.1, R46.1, R47.1, R48.1, R49.1, R66.1, R67.1, R68.1, R69.1, R70.1, R71.1, R72.1, R73.1; also elsewhere on the board
AN_FILTERED_0: Z24.3; also elsewhere on the board
AN_FILTERED_1: Z27.3; also elsewhere on the board
AN_FILTERED_2: Z29.3; also elsewhere on the board
AN_FILTERED_3: Z28.3; also elsewhere on the board
AN_FILTERED_4: Z30.3; also elsewhere on the board
AN_FILTERED_5: Z31.3; also elsewhere on the board
AN_FILTERED_6: Z33.3; also elsewhere on the board
AN_FILTERED_7: Z34.3; also elsewhere on the board
AN_FILTERED_8: Z37.3; also elsewhere on the board
AN_FILTERED_9: Z36.3; also elsewhere on the board
AN_FILTERED_10: Z22.3; also elsewhere on the board
AN_FILTERED_11: Z23.3; also elsewhere on the board
AN_FILTERED_12: Z25.3; also elsewhere on the board
AN_FILTERED_13: Z26.3; also elsewhere on the board
AN_FILTERED_14: Z32.3; also elsewhere on the board
AN_FILTERED_15: Z35.3; also elsewhere on the board
AN_RAW_1: R31.2, VD9.A1, VD17.A, XP4.1
AN_RAW_2: R33.2, VD11.A1, VD19.A, XP4.2
AN_RAW_2_SUPPLY: R28.2, VD6.A1, VD14.A
AN_RAW_3: R32.2, VD10.A1, VD18.A, XP4.3
AN_RAW_4: R50.2, VD20.A1, VD28.A, XP4.4
AN_RAW_5: R51.2, VD21.A1, VD29.A, XP4.5
AN_RAW_6: R53.2, VD23.A1, VD31.A, XP4.6
AN_RAW_7: R54.2, VD24.A1, VD32.A, XP4.7
AN_RAW_8: R57.2, VD27.A1, VD35.A, XP4.8
AN_RAW_9: R56.2, VD26.A1, VD34.A, XP4.9
AN_RAW_10: R26.2, VD4.A1, VD12.A, XP4.10
AN_RAW_11: R27.2, VD5.A1, VD13.A, XP4.11
AN_RAW_12: R29.2, VD7.A1, VD15.A, XP4.12
AN_RAW_13: R30.2, VD8.A1, VD16.A, XP4.13
AN_RAW_14: R52.2, VD22.A1, VD30.A, XP4.14
AN_RAW_15: R55.2, VD25.A1, VD33.A, XP4.15
GND: VD4.A2, VD5.A2, VD6.A2, VD7.A2, VD8.A2, VD9.A2, VD10.A2, VD11.A2, VD20.A2, VD21.A2, VD22.A2, VD23.A2, VD24.A2, VD25.A2, VD26.A2, VD27.A2, XP4.16, Z22.2, Z23.2, Z24.2, Z25.2, Z26.2, Z27.2, Z28.2, Z29.2, Z30.2, Z31.2, Z32.2, Z33.2, Z34.2, Z35.2, Z36.2, Z37.2; also elsewhere on the board
unnamed: R34.1, VD12.C
unnamed: R35.1, VD13.C
unnamed: R41.1, VD19.C
unnamed: R40.1, VD18.C
unnamed: R39.1, VD17.C
unnamed: R38.1, VD16.C
unnamed: R37.1, VD15.C
unnamed: R36.1, VD14.C
unnamed: R58.1, VD28.C
unnamed: R60.1, VD30.C
unnamed: R59.1, VD29.C
unnamed: R61.1, VD31.C
unnamed: R62.1, VD32.C
unnamed: R64.1, VD34.C
unnamed: R63.1, VD33.C
unnamed: R65.1, VD35.C
unnamed: C12.1, R34.2, R42.2, Z22.1
unnamed: C13.1, R35.2, R43.2, Z23.1
unnamed: C14.1, R36.2, R44.2, Z24.1
unnamed: C15.1, R37.2, R45.2, Z25.1
unnamed: C16.1, R38.2, R46.2, Z26.1
unnamed: C17.1, R39.2, R47.2, Z27.1
unnamed: C18.1, R40.2, R48.2, Z28.1
unnamed: C19.1, R41.2, R49.2, Z29.1
unnamed: C20.1, R58.2, R66.2, Z30.1
unnamed: C21.1, R59.2, R67.2, Z31.1
unnamed: C22.1, R60.2, R68.2, Z32.1
unnamed: C23.1, R61.2, R69.2, Z33.1
unnamed: C24.1, R62.2, R70.2, Z34.1
unnamed: C25.1, R63.2, R71.2, Z35.1
unnamed: C26.1, R64.2, R72.2, Z36.1
unnamed: C27.1, R65.2, R73.2, Z37.1

Notes on the sheet:
A(1)

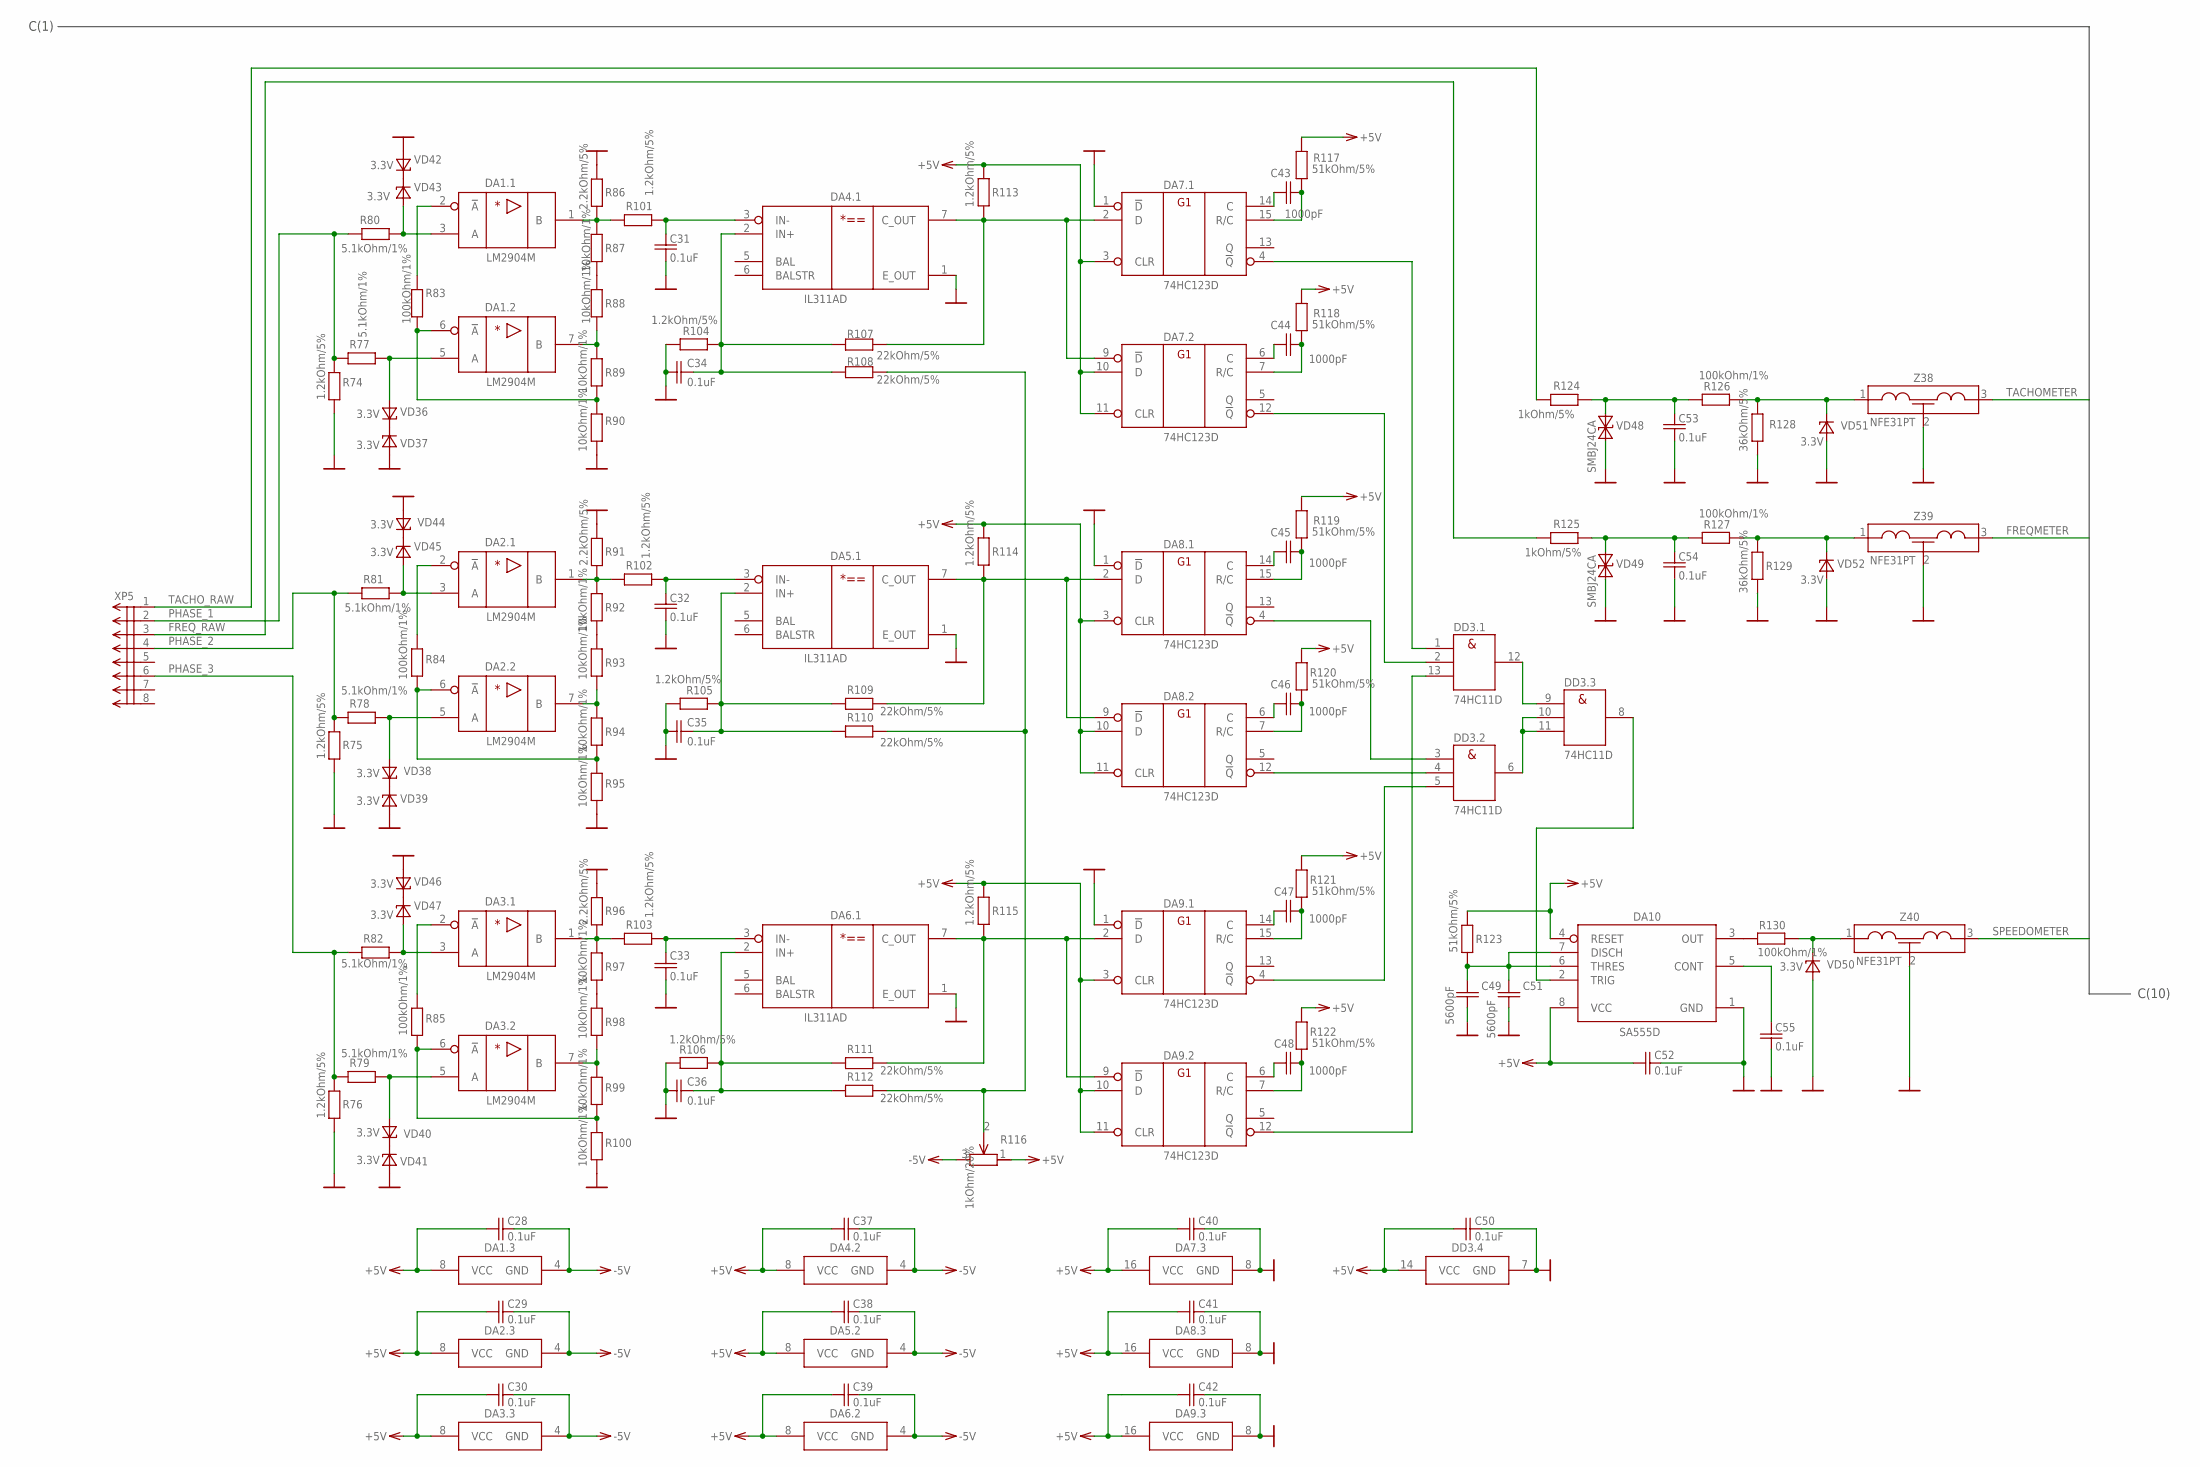
[picture p9: schematic mpiovd.sch, sheet 3, Freq]

Parts:
C28, C29, C30, C31, C32, C33, C34, C35, C36, C37, C38, C39, C40, C41, C42, C50, C52, C53, C54, C55: 0.1uF; C0603; PARTNO C0603C104K5RACTU
C43, C44, C45, C46, C47, C48: 1000pF; C0603; PARTNO C0603C102K5RACTU
C49, C51: 5600pF; C0603; PARTNO C0603C562K5RACTU
DA1, DA2, DA3: LM2904M; SO08; PARTNO LM2904M
DA4, DA5, DA6: IL311AD; SO08; PARTNO IL311AD
DA7, DA8, DA9: 74HC123D; SO16; PARTNO IN74HC123AD
DA10: SA555D; SO08; PARTNO SA555D
DD3: 74HC11D; SO14; PARTNO IN74HC11AD
R74, R75, R76, R101, R102, R103, R104, R105, R106, R113, R114, R115: 1.2kOhm/5%; R0603; PARTNO RC0603JR-071K2L
R77, R78, R79, R80, R81, R82: 5.1kOhm/1%; R0603; PARTNO RC0603FR-075K1L
R83, R84, R85, R126, R127, R130: 100kOhm/1%; R0603; PARTNO RC0603FR-13100KL
R86, R91, R96: 2.2kOhm/5%; R0603; PARTNO RC0603JR-072K2L
R87, R88, R89, R90, R92, R93, R94, R95, R97, R98, R99, R100: 10kOhm/1%; R0603; PARTNO RC0603FR-1010KL
R107, R108, R109, R110, R111, R112: 22kOhm/5%; R0603; PARTNO RC0603JR-0722KL
R116: 1kOhm/20%; RTRIMTSM53YJ; PARTNO TSM4YJ102KR05
R117, R118, R119, R120, R121, R122, R123: 51kOhm/5%; R0603; PARTNO RC0603JR-0751KL
R124, R125: 1kOhm/5%; R2512; PARTNO RC2512JK-071KL
R128, R129: 36kOhm/5%; R0603; PARTNO ERJ3GEYJ363V
VD36, VD37, VD38, VD39, VD40, VD41, VD42, VD43, VD44, VD45, VD46, VD47, VD50, VD51, VD52: 3.3V; SOD80; PARTNO BZV55-C3V3
VD48, VD49: SMBJ24CA; SMB-BIDIR; PARTNO SMBJ24CA
XP5: MOLEX-90130-08; PARTNO 90130-1208
Z38, Z39, Z40: NFE31PT; NFE31; PARTNO NFE31PT152Z1E9

Connections:
+5V: C28.1, C29.1, C30.1, C37.1, C38.1, C39.1, C40.1, C41.1, C42.1, C50.1, C52.1, DA1.8 (VCC), DA2.8 (VCC), DA3.8 (VCC), DA4.8 (VCC), DA5.8 (VCC), DA6.8 (VCC), DA7.3 (CLR), DA7.10 (D), DA7.11 (CLR), DA7.16 (VCC), DA8.3 (CLR), DA8.10 (D), DA8.11 (CLR), DA8.16 (VCC), DA9.3 (CLR), DA9.10 (D), DA9.11 (CLR), DA9.16 (VCC), DA10.4 (RESET), DA10.8 (VCC), DD3.14 (VCC), R113.1, R114.1, R115.1, R116.1 (A), R117.2, R118.2, R119.2, R120.2, R121.2, R122.2, R123.2; also elsewhere on the board
-5V: C28.2, C29.2, C30.2, C37.2, C38.2, C39.2, DA1.4 (GND), DA2.4 (GND), DA3.4 (GND), DA4.4 (GND), DA5.4 (GND), DA6.4 (GND), R116.3 (E); also elsewhere on the board
FREQMETER: Z39.3; also elsewhere on the board
FREQ_RAW: R125.2, XP5.3
GND: C31.1, C32.1, C33.1, C34.2, C35.2, C36.2, C40.2, C41.2, C42.2, C49.2, C50.2, C51.2, C52.2, C53.1, C54.1, C55.2, DA4.1 (E_OUT), DA5.1 (E_OUT), DA6.1 (E_OUT), DA7.1 (!D), DA7.8 (GND), DA8.1 (!D), DA8.8 (GND), DA9.1 (!D), DA9.8 (GND), DA10.1 (GND), DD3.7 (GND), R74.1, R75.1, R76.1, R86.2, R90.1, R91.2, R95.1, R96.2, R100.1, R104.2, R105.2, R106.2, R128.1, R129.1, VD37.A, VD39.A, VD41.A, VD42.A, VD44.A, VD46.A, VD48.A2, VD49.A2, VD50.A, VD51.A, VD52.A, Z38.2, Z39.2, Z40.2; also elsewhere on the board
unnamed: VD44.C, VD45.C
unnamed: C53.2, R124.1, R126.1, VD48.A1
unnamed: DD3.6 (Y), DD3.10 (B), DD3.11 (C)
unnamed: DD3.9 (A), DD3.12 (Y)
unnamed: DA10.2 (TRIG), DD3.8 (Y)
unnamed: DA10.3 (OUT), R130.1
unnamed: C34.1, DA4.2 (IN+), R104.1, R107.1, R108.1
unnamed: DA4.7 (C_OUT), DA7.2 (D), DA7.9 (!D), R107.2, R113.2
unnamed: VD42.C, VD43.C
unnamed: DA1.3 (A), R80.2, VD43.A
unnamed: C43.2, DA7.15 (R/C), R117.1
unnamed: DA2.3 (A), R81.2, VD45.A
unnamed: VD36.C, VD37.C
unnamed: DA1.5 (A), R77.2, VD36.A
unnamed: C43.1, DA7.14 (C)
unnamed: C44.1, DA7.6 (C)
unnamed: C31.2, DA4.3 (IN-), R101.2
unnamed: C44.2, DA7.7 (R/C), R118.1
unnamed: C49.1, C51.1, DA10.6 (THRES), DA10.7 (DISCH), R123.1
unnamed: DA1.2 (!A), R83.2
unnamed: DA7.4 (!Q), DD3.1 (A)
unnamed: DA7.12 (!Q), DD3.2 (B)
unnamed: C55.1, DA10.5 (CONT)
unnamed: DA1.7 (B), R88.1, R89.2
unnamed: DA1.6 (!A), R83.1, R89.1, R90.2
unnamed: R87.1, R88.2
unnamed: DA1.1 (B), R86.1, R87.2, R101.1
unnamed: VD38.C, VD39.C
unnamed: DA2.5 (A), R78.2, VD38.A
unnamed: DA2.2 (!A), R84.2
unnamed: DA2.7 (B), R93.1, R94.2
unnamed: DA2.6 (!A), R84.1, R94.1, R95.2
unnamed: R92.1, R93.2
unnamed: DA2.1 (B), R91.1, R92.2, R102.1
unnamed: C32.2, DA5.3 (IN-), R102.2
unnamed: C35.1, DA5.2 (IN+), R105.1, R109.1, R110.1
unnamed: DA5.7 (C_OUT), DA8.2 (D), DA8.9 (!D), R109.2, R114.2
unnamed: C45.2, DA8.15 (R/C), R119.1
unnamed: C45.1, DA8.14 (C)
unnamed: C46.2, DA8.7 (R/C), R120.1
unnamed: DA8.4 (!Q), DD3.3 (A)
unnamed: DA8.12 (!Q), DD3.4 (B)
unnamed: C46.1, DA8.6 (C)
unnamed: VD46.C, VD47.C
unnamed: DA3.3 (A), R82.2, VD47.A
unnamed: VD40.C, VD41.C
unnamed: DA3.5 (A), R79.2, VD40.A
unnamed: DA3.2 (!A), R85.2
unnamed: DA3.7 (B), R98.1, R99.2
unnamed: DA3.6 (!A), R85.1, R99.1, R100.2
unnamed: R97.1, R98.2
unnamed: DA3.1 (B), R96.1, R97.2, R103.1
unnamed: C33.2, DA6.3 (IN-), R103.2
unnamed: C36.1, DA6.2 (IN+), R106.1, R111.1, R112.1
unnamed: DA6.7 (C_OUT), DA9.2 (D), DA9.9 (!D), R111.2, R115.2
unnamed: C47.2, DA9.15 (R/C), R121.1
unnamed: C47.1, DA9.14 (C)
unnamed: C48.2, DA9.7 (R/C), R122.1
unnamed: DA9.4 (!Q), DD3.5 (C)
unnamed: DA9.12 (!Q), DD3.13 (C)
unnamed: C48.1, DA9.6 (C)
unnamed: R108.2, R110.2, R112.2, R116.2 (S)
unnamed: C54.2, R125.1, R127.1, VD49.A1
unnamed: R126.2, R128.2, VD51.C, Z38.1
unnamed: R127.2, R129.2, VD52.C, Z39.1
unnamed: R130.2, VD50.C, Z40.1
PHASE_1: R74.2, R77.1, R80.1, XP5.2
PHASE_2: R75.2, R78.1, R81.1, XP5.4
PHASE_3: R76.2, R79.1, R82.1, XP5.6
SPEEDOMETER: Z40.3; also elsewhere on the board
TACHOMETER: Z38.3; also elsewhere on the board
TACHO_RAW: R124.2, XP5.1

Notes on the sheet:
C(1)
C(10)

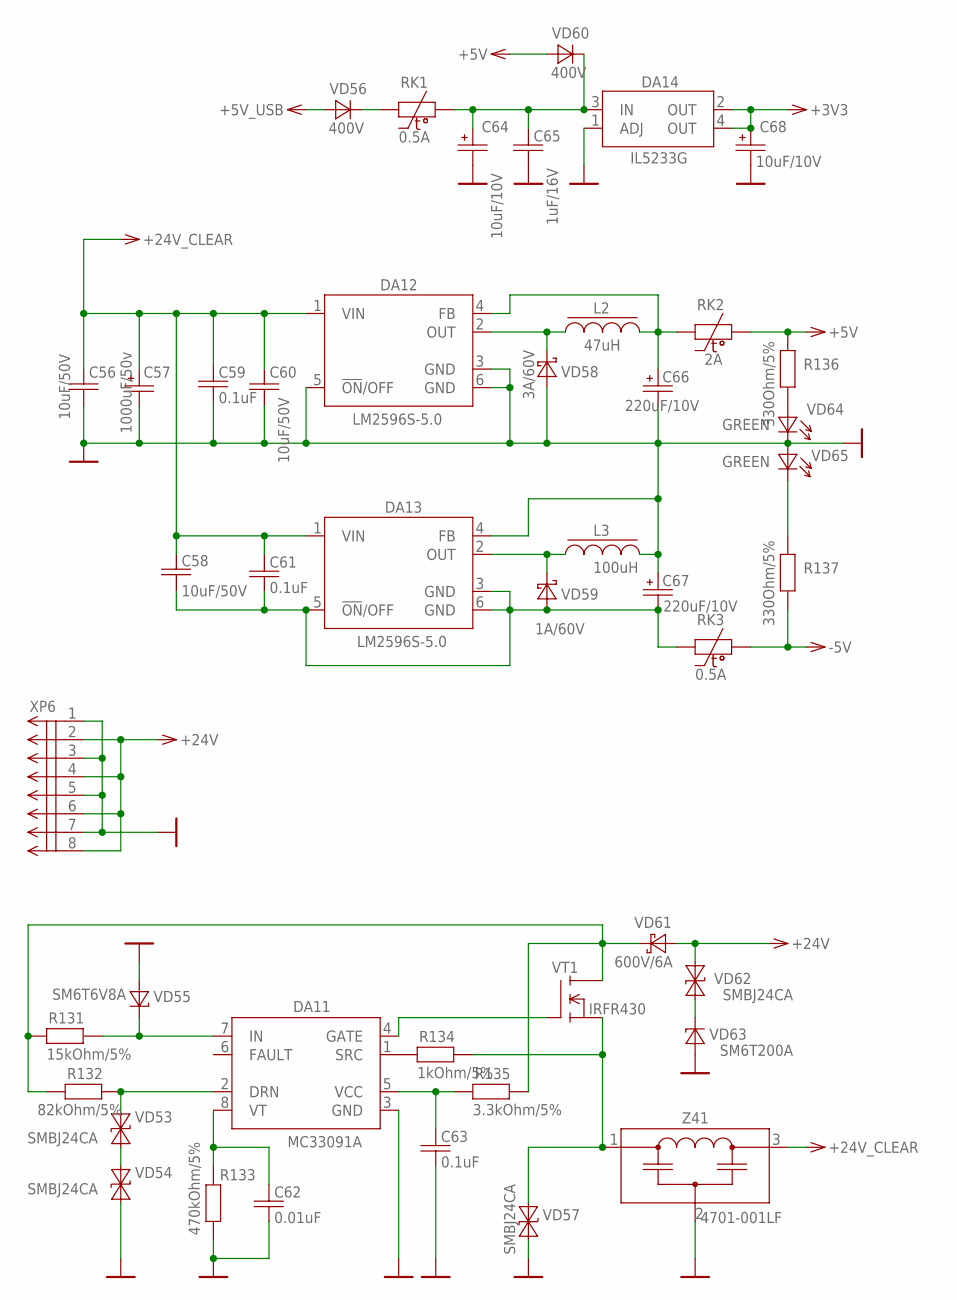
[picture p10: schematic mpiovd.sch, sheet 4, power]

Parts:
C56, C58, C60: 10uF/50V; C2220K; PARTNO 22205C106KAT2A
C57: 1000uF/50v; E35-16-STRAPPED; PARTNO 516D108M050QS6AE3
C59, C61, C63: 0.1uF; C0603; PARTNO C0603C104K5RACTU
C62: 0.01uF; C0603; PARTNO C0603C103K5RACTU
C64, C68: 10uF/10V; A/3216-18W; PARTNO T491A106K010AT
C65: 1uF/16V; C0603; PARTNO C0603C105K4PACTU
C66, C67: 220uF/10V; TE-D-7343; PARTNO T491D227K010AT
DA11: MC33091A; SO08; PARTNO IL33091AD
DA12, DA13: LM2596S-5.0; TO263-5; PARTNO LM2596S-5.0/NOPB
DA14: IL5233G; SOT223; PARTNO IL5233G
L2: 47uH; DRA127; PARTNO DR127-470-R
L3: 100uH; DRA73; PARTNO DR73-101-R
R131: 15kOhm/5%; R0805; PARTNO ERJ6GEYJ153V
R132: 82kOhm/5%; R0805; PARTNO RC0805JR-0782KL
R133: 470kOhm/5%; R0805; PARTNO ERJ6GEYJ474V
R134: 1kOhm/5%; R0805; PARTNO ERJ6GEYJ102V
R135: 3.3kOhm/5%; R2512; PARTNO 35203K3JT
R136, R137: 330Ohm/5%; R0603; PARTNO ERJ3GEYJ331V
RK1, RK3: 0.5A; RK1210; PARTNO 1210L050YR
RK2: 2A; RK1812; PARTNO 1812L200DR
VD53, VD54, VD57, VD62: SMBJ24CA; SMB-BIDIR; PARTNO SMBJ24CA
VD55: SM6T6V8A; SMB; PARTNO SM6T6V8A
VD56, VD60: 400V; SMA; PARTNO S1G-E3/61T
VD58: 3A/60V; SMC; PARTNO VS-30BQ060TRPBF
VD59: 1A/60V; SMB; PARTNO VS-10BQ060TRPBF
VD61: 600V/6A; DPAK; PARTNO IDD06SG60C
VD63: SM6T200A; SMB; PARTNO SM6T200A
VD64, VD65: GREEN; LED-0805; PARTNO KPHCM-2012SGC-T
VT1: IRFR430; DPAK; PARTNO IRFR430APBF
XP6: MOLEX-90130-08; PARTNO 90130-1208
Z41: 4701-001LF; TUSONIX-4701; PARTNO 4701-001LF

Connections:
+3V3: C68.+, DA14.2 (OUT), DA14.4 (OUT); also elsewhere on the board
+5V: R136.1, RK2.2, VD60.A; also elsewhere on the board
+5V_USB: VD56.A; also elsewhere on the board
+24V: VD61.3 (A), VD62.A1, XP6.2, XP6.4, XP6.6, XP6.8
+24V_CLEAR: C56.2, C57.+, C58.2, C59.1, C60.2, C61.1, DA12.1 (VIN), DA13.1 (VIN), Z41.3; also elsewhere on the board
-5V: R137.2, RK3.2; also elsewhere on the board
GND: C56.1, C57.-, C59.2, C60.1, C62.2, C63.2, C64.-, C65.2, C66.-, C67.+, C68.-, DA11.3 (GND), DA12.3 (GND), DA12.5 (!ON!/OFF), DA12.6 (GND), DA13.4 (FB), DA14.1 (ADJ), L3.2, R133.1, VD54.A1, VD55.A, VD57.A2, VD58.A, VD63.A, VD64.C, VD65.A, XP6.1, XP6.3, XP6.5, XP6.7, Z41.2; also elsewhere on the board
unnamed: DA12.2 (OUT), L2.1, VD58.C
unnamed: DA13.2 (OUT), L3.1, VD59.C
unnamed: C63.1, DA11.5 (VCC), R135.1
unnamed: VD62.A2, VD63.C
unnamed: VD53.A1, VD54.A2
unnamed: DA11.2 (DRN), R132.2, VD53.A2
unnamed: DA11.7 (IN), R131.2, VD55.C
unnamed: R131.1, R132.1, R135.2, VD61.2 (C), VT1.2 (D)
unnamed: DA11.1 (SRC), R134.1
unnamed: C62.1, DA11.8 (VT), R133.2
unnamed: DA11.4 (GATE), VT1.1 (G)
unnamed: C66.+, DA12.4 (FB), L2.2, RK2.1
unnamed: C58.1, C61.2, C67.-, DA13.3 (GND), DA13.5 (!ON!/OFF), DA13.6 (GND), RK3.1, VD59.A
unnamed: RK1.1, VD56.C
unnamed: C64.+, C65.1, DA14.3 (IN), RK1.2, VD60.C
unnamed: R134.2, VD57.A1, VT1.3 (S), Z41.1
unnamed: R136.2, VD64.A
unnamed: R137.1, VD65.C
