barthess/volat3/hard/mpiovd/mpiovd.brd

## EAGLE design hard/mpiovd/mpiovd.brd (continued)

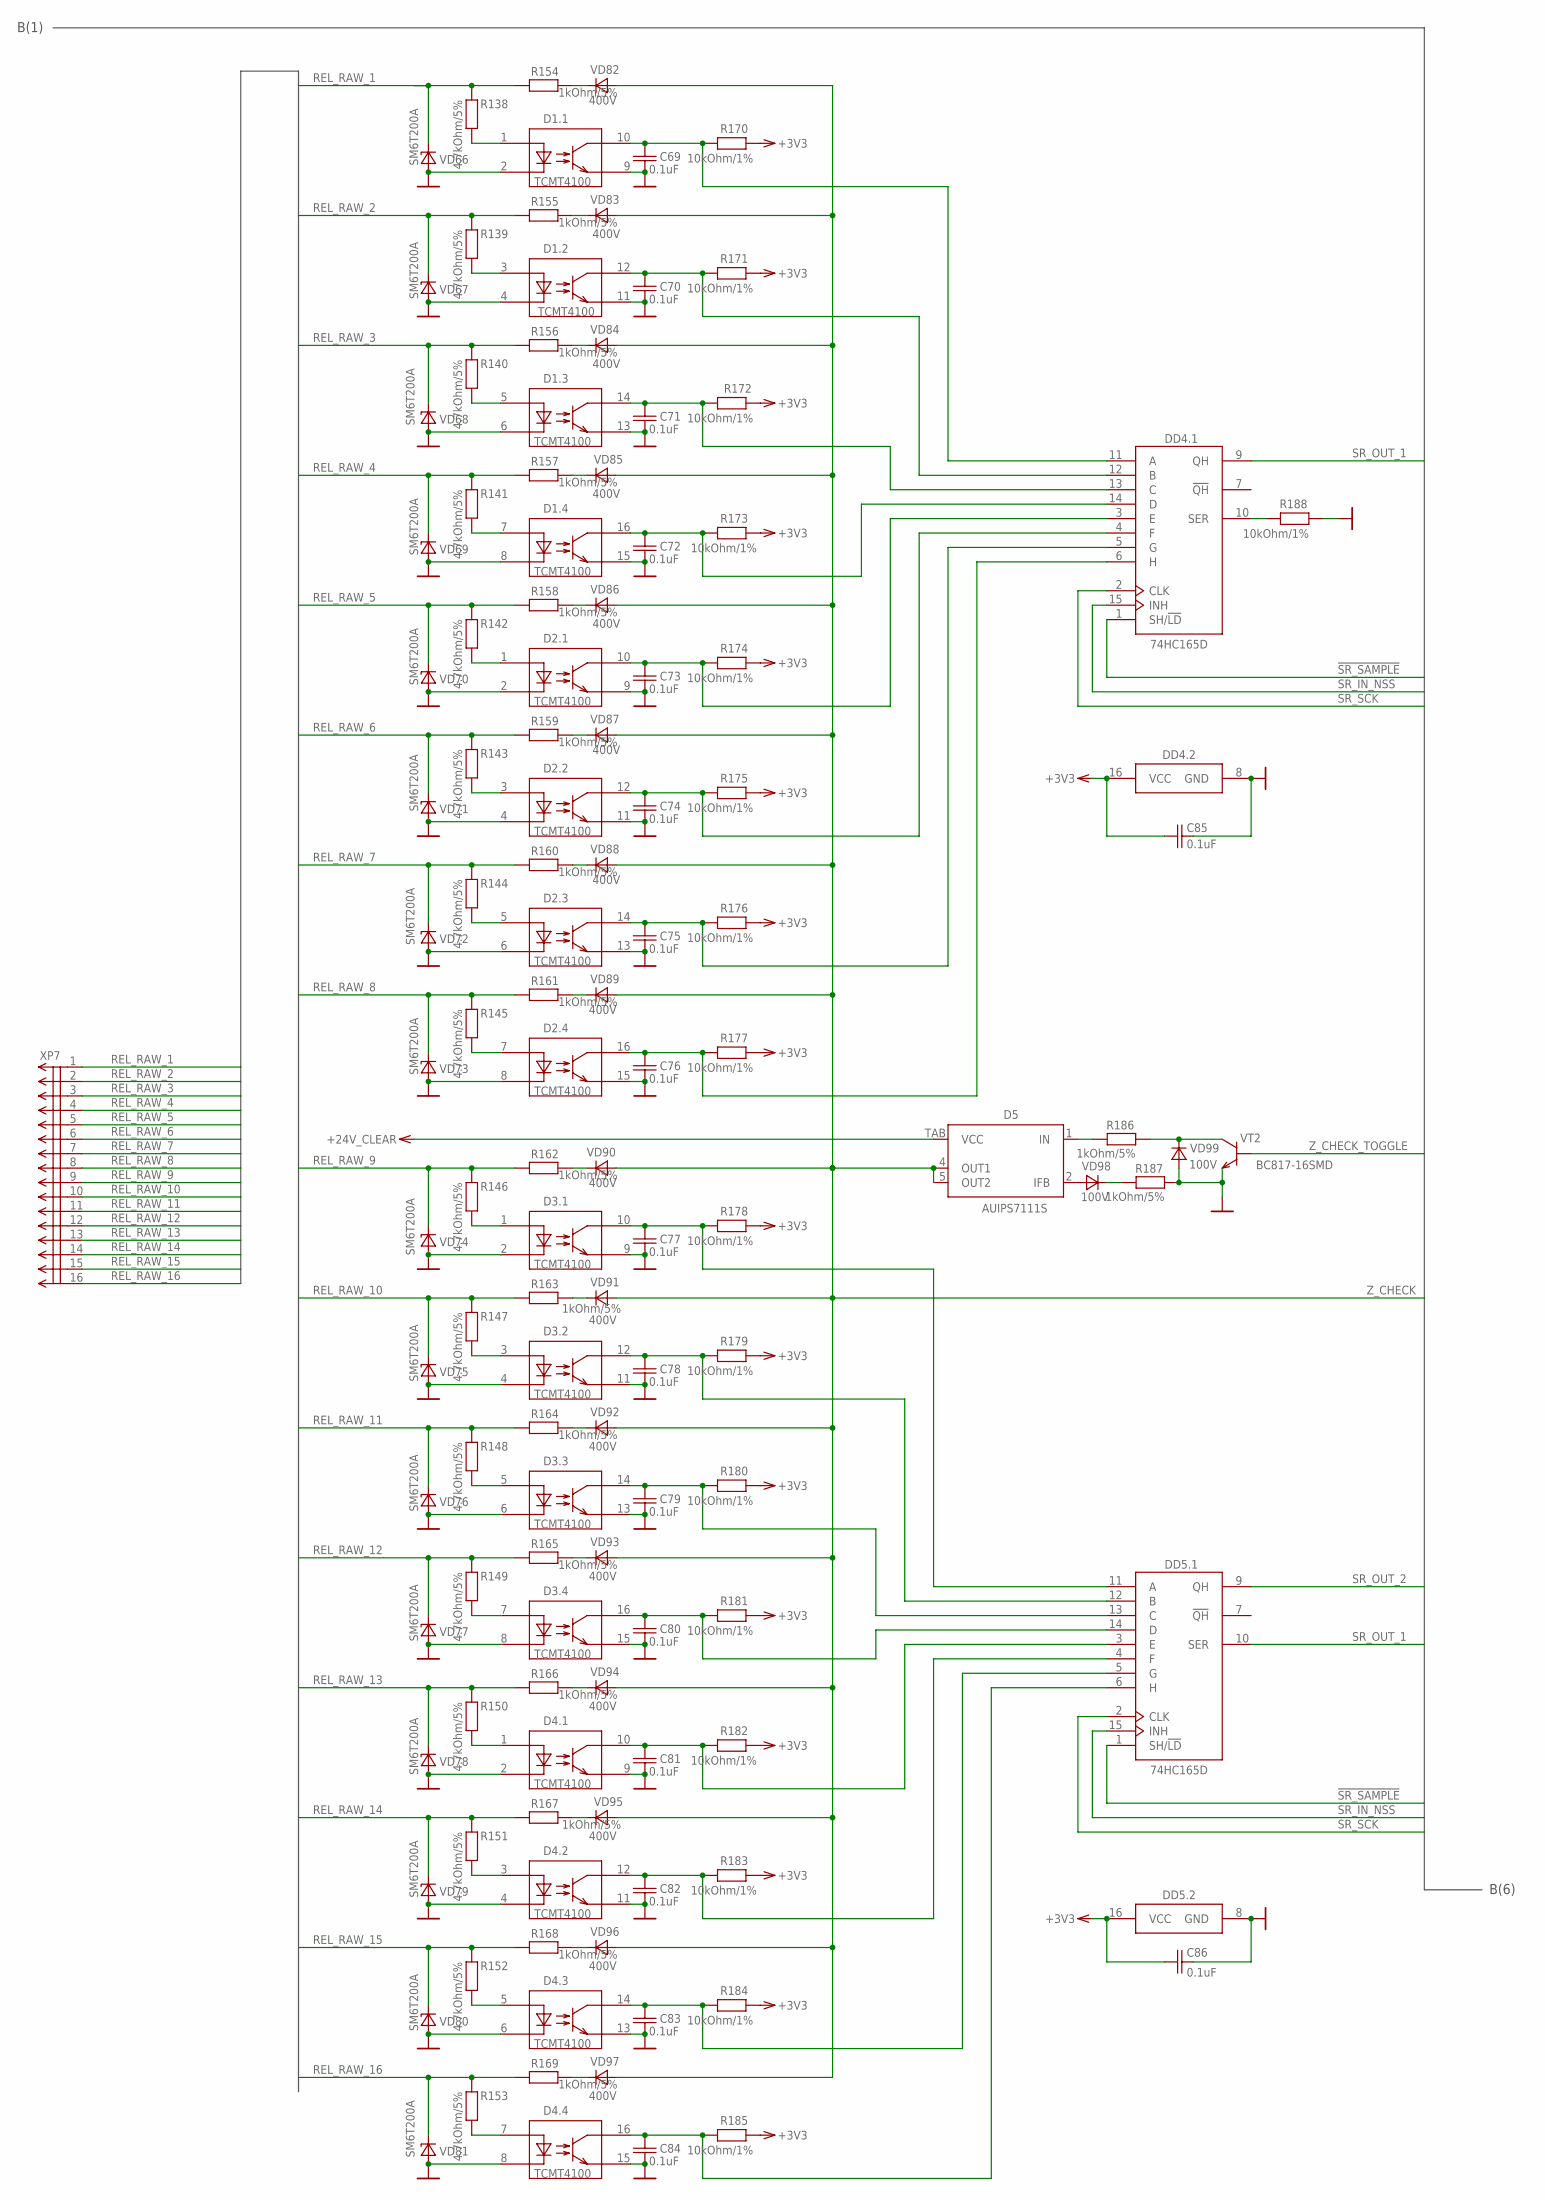
[picture p11: schematic mpiovd.sch, sheet 5, rel1]

Parts:
C69, C70, C71, C72, C73, C74, C75, C76, C77, C78, C79, C80, C81, C82, C83, C84, C85, C86: 0.1uF; C0603; PARTNO C0603C104K5RACTU
D1, D2, D3, D4: TCMT4100; SO16; PARTNO TCMT4100
D5: AUIPS7111S; TO252-5-11; PARTNO AUIPS7111S
DD4, DD5: 74HC165D; SO16; PARTNO IN74HC165AD
R138, R139, R140, R141, R142, R143, R144, R145, R146, R147, R148, R149, R150, R151, R152, R153: 4.7kOhm/5%; R1206; PARTNO RC1206JR-074K7L
R154, R155, R156, R157, R158, R159, R160, R161, R162, R163, R164, R165, R166, R167, R168, R169: 1kOhm/5%; R2512; PARTNO RC2512JK-071KL
R170, R171, R172, R173, R174, R175, R176, R177, R178, R179, R180, R181, R182, R183, R184, R185, R188: 10kOhm/1%; R0603; PARTNO RC0603FR-1010KL
R186, R187: 1kOhm/5%; R0805; PARTNO ERJ6GEYJ102V
VD66, VD67, VD68, VD69, VD70, VD71, VD72, VD73, VD74, VD75, VD76, VD77, VD78, VD79, VD80, VD81: SM6T200A; SMB; PARTNO SM6T200A
VD82, VD83, VD84, VD85, VD86, VD87, VD88, VD89, VD90, VD91, VD92, VD93, VD94, VD95, VD96, VD97: 400V; SMA; PARTNO S1G-E3/61T
VD98, VD99: 100V; SOD323; PARTNO 1N4148WS-V-GS18
VT2: BC817-16SMD; SOT23-BEC; PARTNO BC817
XP7: MOLEX-90130-16; PARTNO 90130-1216

Connections:
!SR_SAMPLE: DD4.1 (SH/!LD), DD5.1 (SH/!LD); also elsewhere on the board
+3V3: C85.1, C86.1, DD4.16 (VCC), DD5.16 (VCC), R170.1, R171.1, R172.1, R173.1, R174.1, R175.1, R176.1, R177.1, R178.1, R179.1, R180.1, R181.1, R182.1, R183.1, R184.1, R185.1; also elsewhere on the board
+24V_CLEAR: D5.TAB (VCC); also elsewhere on the board
DISCRETE_1: C69.1, D1.10 (TC), DD4.11 (A), R170.2
DISCRETE_2: C70.1, D1.12 (TC), DD4.12 (B), R171.2
DISCRETE_3: C71.1, D1.14 (TC), DD4.13 (C), R172.2
DISCRETE_4: C72.1, D1.16 (TC), DD4.14 (D), R173.2
DISCRETE_5: C73.1, D2.10 (TC), DD4.3 (E), R174.2
DISCRETE_6: C74.1, D2.12 (TC), DD4.4 (F), R175.2
DISCRETE_7: C75.1, D2.14 (TC), DD4.5 (G), R176.2
DISCRETE_8: C76.1, D2.16 (TC), DD4.6 (H), R177.2
DISCRETE_9: C77.1, D3.10 (TC), DD5.11 (A), R178.2
DISCRETE_10: C78.1, D3.12 (TC), DD5.12 (B), R179.2
DISCRETE_11: C79.1, D3.14 (TC), DD5.13 (C), R180.2
DISCRETE_12: C80.1, D3.16 (TC), DD5.14 (D), R181.2
DISCRETE_13: C81.1, D4.10 (TC), DD5.3 (E), R182.2
DISCRETE_14: C82.1, D4.12 (TC), DD5.4 (F), R183.2
DISCRETE_15: C83.1, D4.14 (TC), DD5.5 (G), R184.2
DISCRETE_16: C84.1, D4.16 (TC), DD5.6 (H), R185.2
GND: C69.2, C70.2, C71.2, C72.2, C73.2, C74.2, C75.2, C76.2, C77.2, C78.2, C79.2, C80.2, C81.2, C82.2, C83.2, C84.2, C85.2, C86.2, D1.2 (DC), D1.4 (DC), D1.6 (DC), D1.8 (DC), D1.9 (TE), D1.11 (TE), D1.13 (TE), D1.15 (TE), D2.2 (DC), D2.4 (DC), D2.6 (DC), D2.8 (DC), D2.9 (TE), D2.11 (TE), D2.13 (TE), D2.15 (TE), D3.2 (DC), D3.4 (DC), D3.6 (DC), D3.8 (DC), D3.9 (TE), D3.11 (TE), D3.13 (TE), D3.15 (TE), D4.2 (DC), D4.4 (DC), D4.6 (DC), D4.8 (DC), D4.9 (TE), D4.11 (TE), D4.13 (TE), D4.15 (TE), DD4.8 (GND), DD5.8 (GND), R187.1, R188.1, VD66.A, VD67.A, VD68.A, VD69.A, VD70.A, VD71.A, VD72.A, VD73.A, VD74.A, VD75.A, VD76.A, VD77.A, VD78.A, VD79.A, VD80.A, VD81.A, VD99.A, VT2.E; also elsewhere on the board
unnamed: D5.1 (IN), R186.2
unnamed: R186.1, VD99.C, VT2.C
unnamed: D5.2 (IFB), VD98.A
unnamed: R187.2, VD98.C
unnamed: R154.2, VD82.C
unnamed: R155.2, VD83.C
unnamed: R156.2, VD84.C
unnamed: R157.2, VD85.C
unnamed: R158.2, VD86.C
unnamed: R159.2, VD87.C
unnamed: R160.2, VD88.C
unnamed: R161.2, VD89.C
unnamed: R162.2, VD90.C
unnamed: R163.2, VD91.C
unnamed: R164.2, VD92.C
unnamed: R165.2, VD93.C
unnamed: R166.2, VD94.C
unnamed: R167.2, VD95.C
unnamed: R168.2, VD96.C
unnamed: R169.2, VD97.C
unnamed: D1.1 (DA), R138.2
unnamed: D1.3 (DA), R139.2
unnamed: D1.5 (DA), R140.2
unnamed: D1.7 (DA), R141.2
unnamed: D2.1 (DA), R142.2
unnamed: D2.3 (DA), R143.2
unnamed: D2.5 (DA), R144.2
unnamed: D2.7 (DA), R145.2
unnamed: D3.1 (DA), R146.2
unnamed: D3.3 (DA), R147.2
unnamed: D3.5 (DA), R148.2
unnamed: D3.7 (DA), R149.2
unnamed: D4.1 (DA), R150.2
unnamed: D4.3 (DA), R151.2
unnamed: D4.5 (DA), R152.2
unnamed: D4.7 (DA), R153.2
unnamed: DD4.10 (SER), R188.2
REL_RAW_1: R138.1, R154.1, VD66.C, XP7.1
REL_RAW_2: R139.1, R155.1, VD67.C, XP7.2
REL_RAW_3: R140.1, R156.1, VD68.C, XP7.3
REL_RAW_4: R141.1, R157.1, VD69.C, XP7.4
REL_RAW_5: R142.1, R158.1, VD70.C, XP7.5
REL_RAW_6: R143.1, R159.1, VD71.C, XP7.6
REL_RAW_7: R144.1, R160.1, VD72.C, XP7.7
REL_RAW_8: R145.1, R161.1, VD73.C, XP7.8
REL_RAW_9: R146.1, R162.1, VD74.C, XP7.9
REL_RAW_10: R147.1, R163.1, VD75.C, XP7.10
REL_RAW_11: R148.1, R164.1, VD76.C, XP7.11
REL_RAW_12: R149.1, R165.1, VD77.C, XP7.12
REL_RAW_13: R150.1, R166.1, VD78.C, XP7.13
REL_RAW_14: R151.1, R167.1, VD79.C, XP7.14
REL_RAW_15: R152.1, R168.1, VD80.C, XP7.15
REL_RAW_16: R153.1, R169.1, VD81.C, XP7.16
SR_IN_NSS: DD4.15 (INH), DD5.15 (INH); also elsewhere on the board
SR_OUT_1: DD4.9 (QH), DD5.10 (SER)
SR_OUT_2: DD5.9 (QH); also elsewhere on the board
SR_SCK: DD4.2 (CLK), DD5.2 (CLK); also elsewhere on the board
Z_CHECK: D5.4 (OUT1), D5.5 (OUT2), VD82.A, VD83.A, VD84.A, VD85.A, VD86.A, VD87.A, VD88.A, VD89.A, VD90.A, VD91.A, VD92.A, VD93.A, VD94.A, VD95.A, VD96.A, VD97.A; also elsewhere on the board
Z_CHECK_TOGGLE: VT2.B; also elsewhere on the board

Notes on the sheet:
B(6)
B(1)

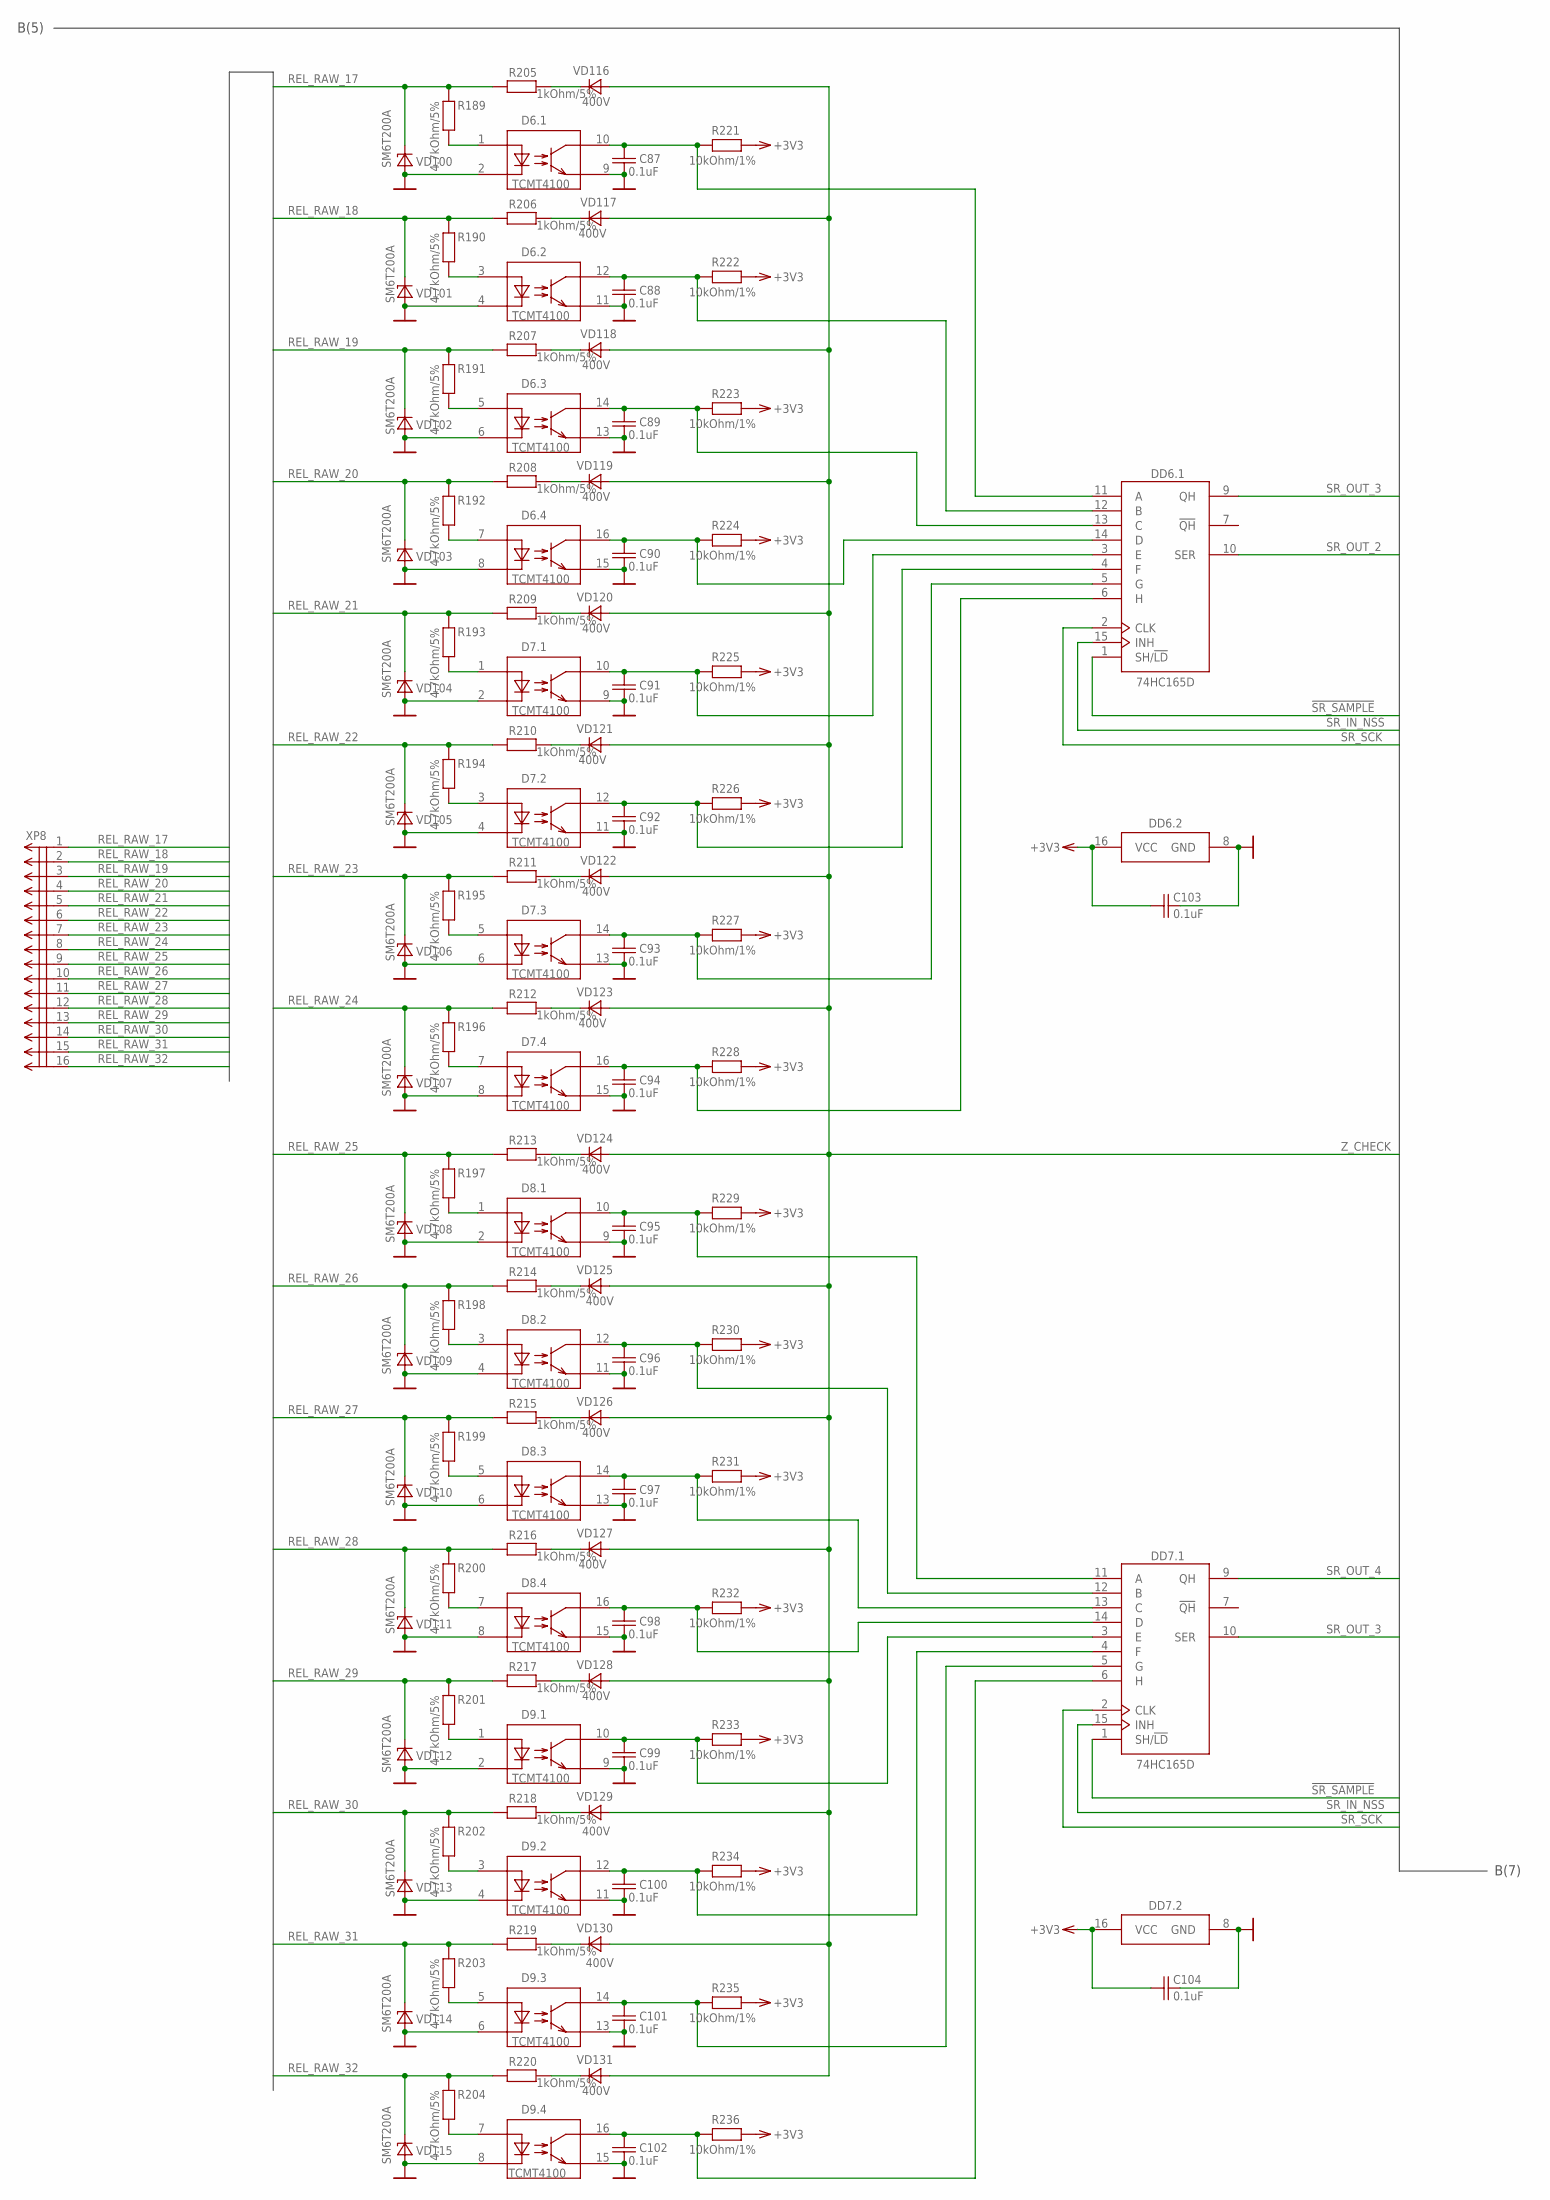
[picture p12: schematic mpiovd.sch, sheet 6, rel2]

Parts:
C87, C88, C89, C90, C91, C92, C93, C94, C95, C96, C97, C98, C99, C100, C101, C102, C103, C104: 0.1uF; C0603; PARTNO C0603C104K5RACTU
D6, D7, D8, D9: TCMT4100; SO16; PARTNO TCMT4100
DD6, DD7: 74HC165D; SO16; PARTNO IN74HC165AD
R189, R190, R191, R192, R193, R194, R195, R196, R197, R198, R199, R200, R201, R202, R203, R204: 4.7kOhm/5%; R1206; PARTNO RC1206JR-074K7L
R205, R206, R207, R208, R209, R210, R211, R212, R213, R214, R215, R216, R217, R218, R219, R220: 1kOhm/5%; R2512; PARTNO RC2512JK-071KL
R221, R222, R223, R224, R225, R226, R227, R228, R229, R230, R231, R232, R233, R234, R235, R236: 10kOhm/1%; R0603; PARTNO RC0603FR-1010KL
VD100, VD101, VD102, VD103, VD104, VD105, VD106, VD107, VD108, VD109, VD110, VD111, VD112, VD113, VD114, VD115: SM6T200A; SMB; PARTNO SM6T200A
VD116, VD117, VD118, VD119, VD120, VD121, VD122, VD123, VD124, VD125, VD126, VD127, VD128, VD129, VD130, VD131: 400V; SMA; PARTNO S1G-E3/61T
XP8: MOLEX-90130-16; PARTNO 90130-1216

Connections:
!SR_SAMPLE: DD6.1 (SH/!LD), DD7.1 (SH/!LD); also elsewhere on the board
+3V3: C103.1, C104.1, DD6.16 (VCC), DD7.16 (VCC), R221.1, R222.1, R223.1, R224.1, R225.1, R226.1, R227.1, R228.1, R229.1, R230.1, R231.1, R232.1, R233.1, R234.1, R235.1, R236.1; also elsewhere on the board
DISCRETE_17: C87.1, D6.10 (TC), DD6.11 (A), R221.2
DISCRETE_18: C88.1, D6.12 (TC), DD6.12 (B), R222.2
DISCRETE_19: C89.1, D6.14 (TC), DD6.13 (C), R223.2
DISCRETE_20: C90.1, D6.16 (TC), DD6.14 (D), R224.2
DISCRETE_21: C91.1, D7.10 (TC), DD6.3 (E), R225.2
DISCRETE_22: C92.1, D7.12 (TC), DD6.4 (F), R226.2
DISCRETE_23: C93.1, D7.14 (TC), DD6.5 (G), R227.2
DISCRETE_24: C94.1, D7.16 (TC), DD6.6 (H), R228.2
DISCRETE_25: C95.1, D8.10 (TC), DD7.11 (A), R229.2
DISCRETE_26: C96.1, D8.12 (TC), DD7.12 (B), R230.2
DISCRETE_27: C97.1, D8.14 (TC), DD7.13 (C), R231.2
DISCRETE_28: C98.1, D8.16 (TC), DD7.14 (D), R232.2
DISCRETE_29: C99.1, D9.10 (TC), DD7.3 (E), R233.2
DISCRETE_30: C100.1, D9.12 (TC), DD7.4 (F), R234.2
DISCRETE_31: C101.1, D9.14 (TC), DD7.5 (G), R235.2
DISCRETE_32: C102.1, D9.16 (TC), DD7.6 (H), R236.2
GND: C87.2, C88.2, C89.2, C90.2, C91.2, C92.2, C93.2, C94.2, C95.2, C96.2, C97.2, C98.2, C99.2, C100.2, C101.2, C102.2, C103.2, C104.2, D6.2 (DC), D6.4 (DC), D6.6 (DC), D6.8 (DC), D6.9 (TE), D6.11 (TE), D6.13 (TE), D6.15 (TE), D7.2 (DC), D7.4 (DC), D7.6 (DC), D7.8 (DC), D7.9 (TE), D7.11 (TE), D7.13 (TE), D7.15 (TE), D8.2 (DC), D8.4 (DC), D8.6 (DC), D8.8 (DC), D8.9 (TE), D8.11 (TE), D8.13 (TE), D8.15 (TE), D9.2 (DC), D9.4 (DC), D9.6 (DC), D9.8 (DC), D9.9 (TE), D9.11 (TE), D9.13 (TE), D9.15 (TE), DD6.8 (GND), DD7.8 (GND), VD100.A, VD101.A, VD102.A, VD103.A, VD104.A, VD105.A, VD106.A, VD107.A, VD108.A, VD109.A, VD110.A, VD111.A, VD112.A, VD113.A, VD114.A, VD115.A; also elsewhere on the board
unnamed: R205.2, VD116.C
unnamed: R206.2, VD117.C
unnamed: R207.2, VD118.C
unnamed: R208.2, VD119.C
unnamed: R209.2, VD120.C
unnamed: R210.2, VD121.C
unnamed: R211.2, VD122.C
unnamed: R212.2, VD123.C
unnamed: R213.2, VD124.C
unnamed: R214.2, VD125.C
unnamed: R215.2, VD126.C
unnamed: R216.2, VD127.C
unnamed: R217.2, VD128.C
unnamed: R218.2, VD129.C
unnamed: R219.2, VD130.C
unnamed: R220.2, VD131.C
unnamed: D6.1 (DA), R189.2
unnamed: D6.3 (DA), R190.2
unnamed: D6.5 (DA), R191.2
unnamed: D6.7 (DA), R192.2
unnamed: D7.1 (DA), R193.2
unnamed: D7.3 (DA), R194.2
unnamed: D7.5 (DA), R195.2
unnamed: D7.7 (DA), R196.2
unnamed: D8.1 (DA), R197.2
unnamed: D8.3 (DA), R198.2
unnamed: D8.5 (DA), R199.2
unnamed: D8.7 (DA), R200.2
unnamed: D9.1 (DA), R201.2
unnamed: D9.3 (DA), R202.2
unnamed: D9.5 (DA), R203.2
unnamed: D9.7 (DA), R204.2
REL_RAW_17: R189.1, R205.1, VD100.C, XP8.1
REL_RAW_18: R190.1, R206.1, VD101.C, XP8.2
REL_RAW_19: R191.1, R207.1, VD102.C, XP8.3
REL_RAW_20: R192.1, R208.1, VD103.C, XP8.4
REL_RAW_21: R193.1, R209.1, VD104.C, XP8.5
REL_RAW_22: R194.1, R210.1, VD105.C, XP8.6
REL_RAW_23: R195.1, R211.1, VD106.C, XP8.7
REL_RAW_24: R196.1, R212.1, VD107.C, XP8.8
REL_RAW_25: R197.1, R213.1, VD108.C, XP8.9
REL_RAW_26: R198.1, R214.1, VD109.C, XP8.10
REL_RAW_27: R199.1, R215.1, VD110.C, XP8.11
REL_RAW_28: R200.1, R216.1, VD111.C, XP8.12
REL_RAW_29: R201.1, R217.1, VD112.C, XP8.13
REL_RAW_30: R202.1, R218.1, VD113.C, XP8.14
REL_RAW_31: R203.1, R219.1, VD114.C, XP8.15
REL_RAW_32: R204.1, R220.1, VD115.C, XP8.16
SR_IN_NSS: DD6.15 (INH), DD7.15 (INH); also elsewhere on the board
SR_OUT_2: DD6.10 (SER); also elsewhere on the board
SR_OUT_3: DD6.9 (QH), DD7.10 (SER)
SR_OUT_4: DD7.9 (QH); also elsewhere on the board
SR_SCK: DD6.2 (CLK), DD7.2 (CLK); also elsewhere on the board
Z_CHECK: VD116.A, VD117.A, VD118.A, VD119.A, VD120.A, VD121.A, VD122.A, VD123.A, VD124.A, VD125.A, VD126.A, VD127.A, VD128.A, VD129.A, VD130.A, VD131.A; also elsewhere on the board

Notes on the sheet:
B(5)
B(7)

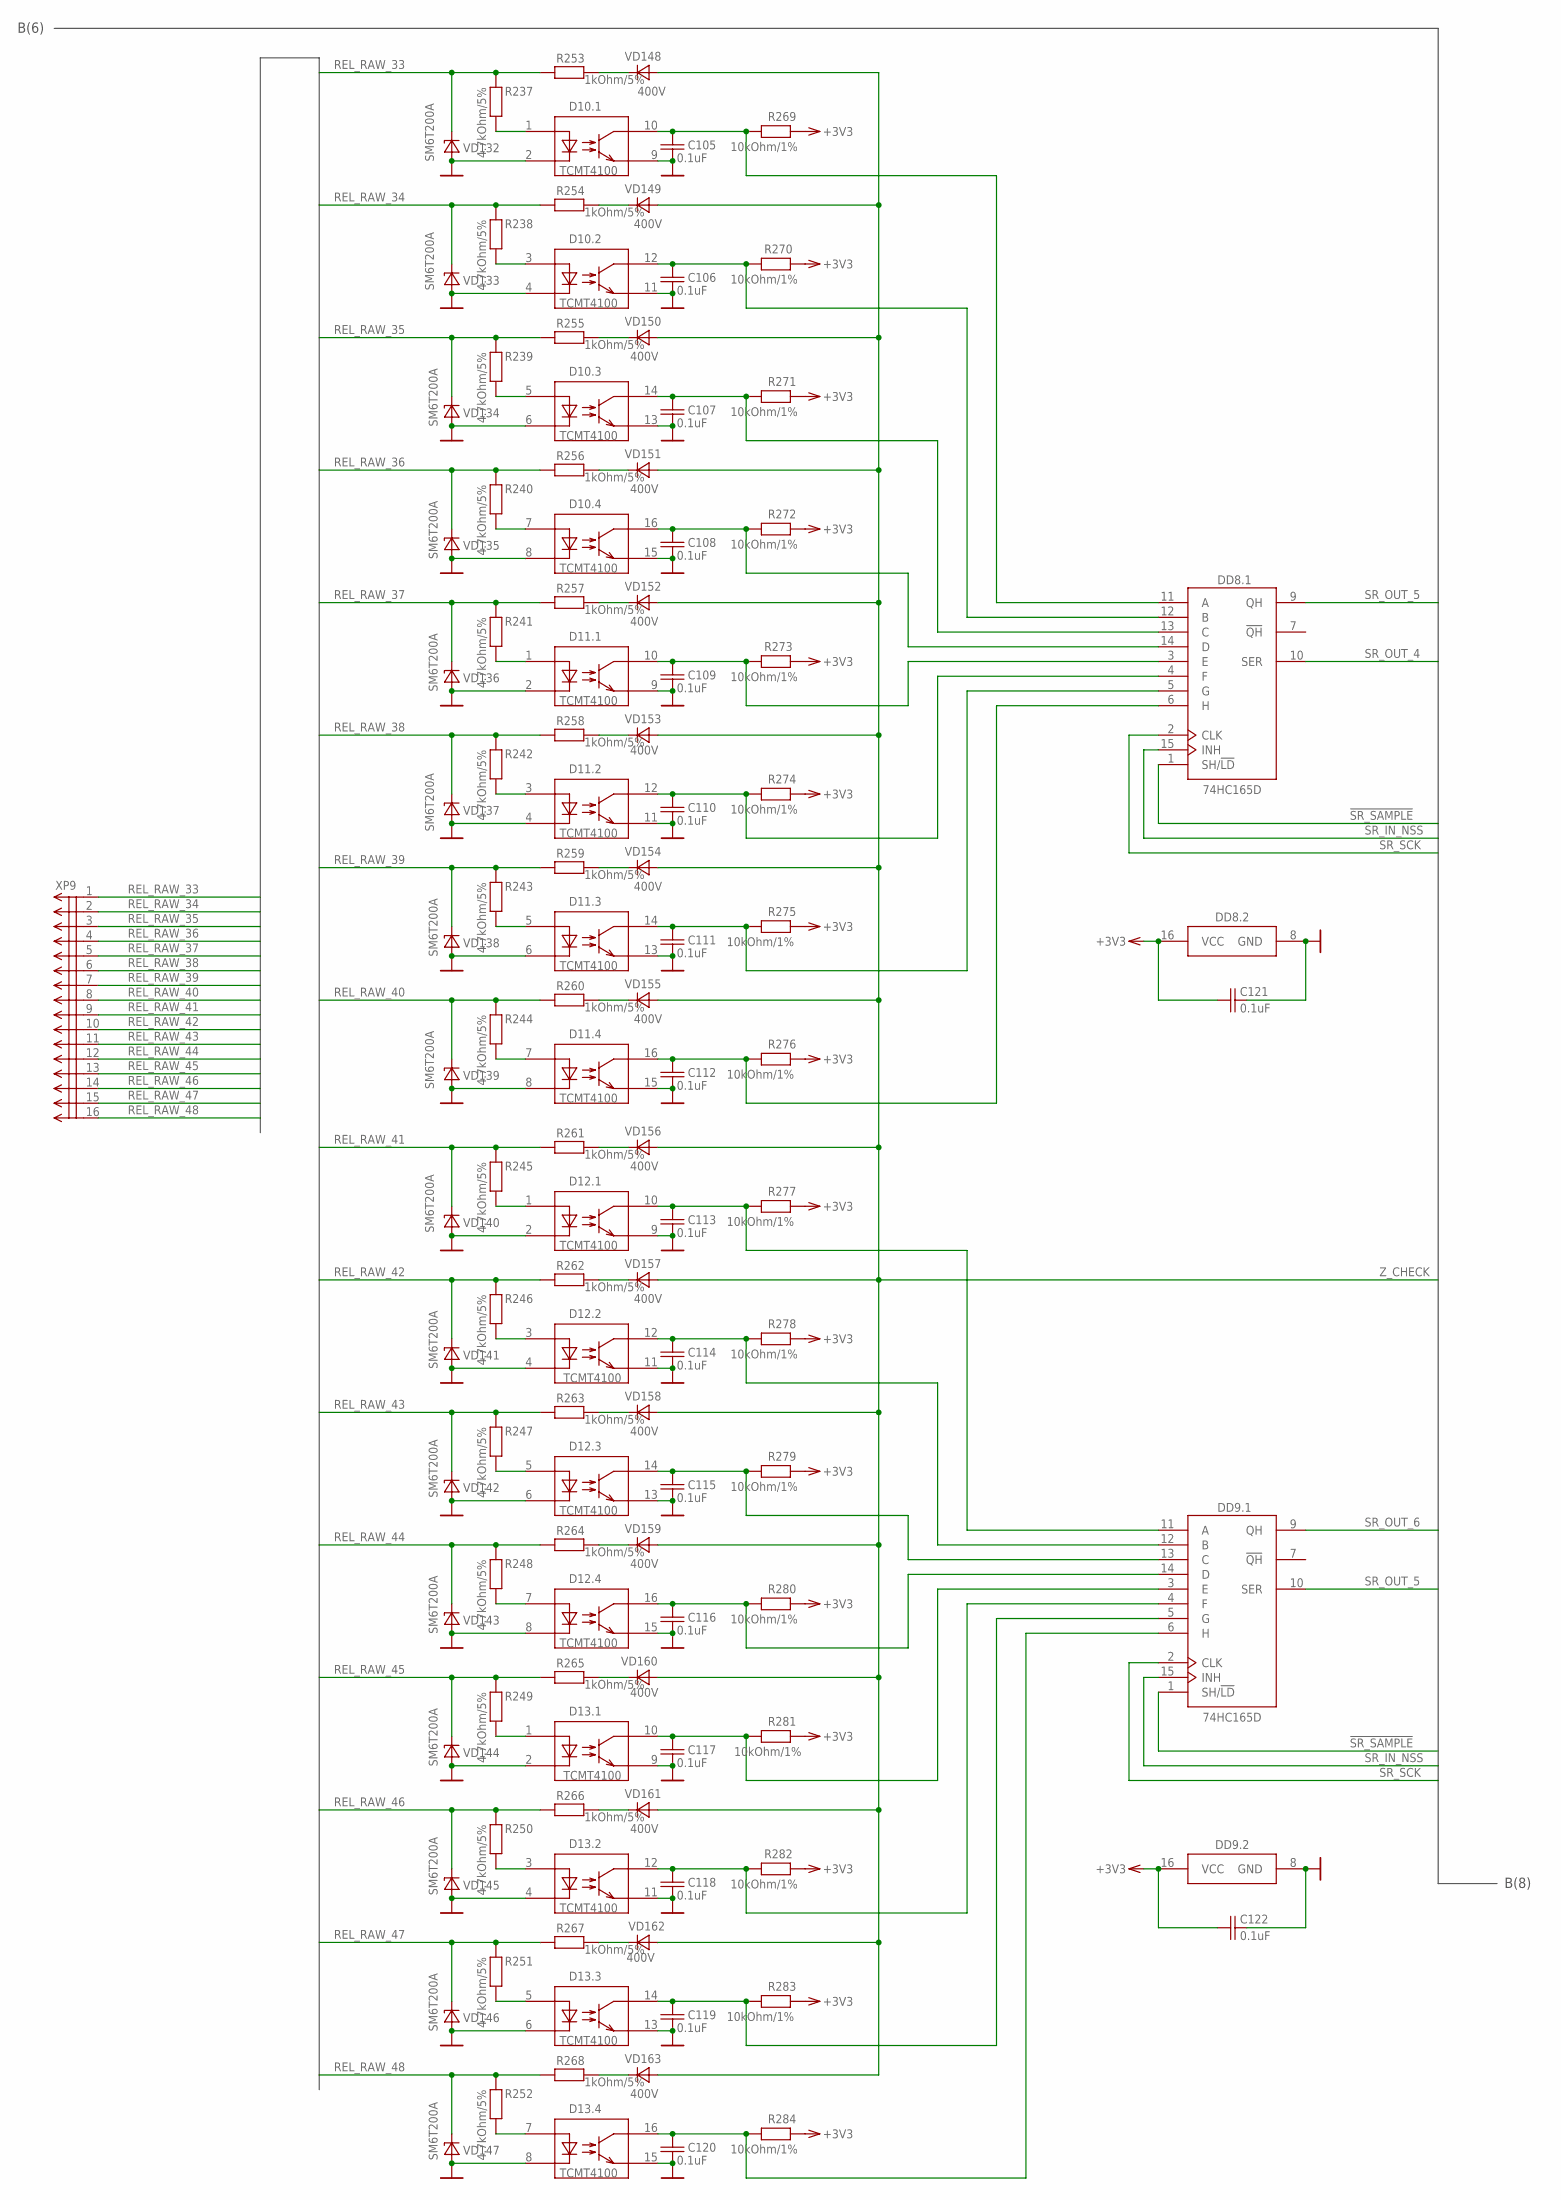
[picture p13: schematic mpiovd.sch, sheet 7, rel3]

Parts:
C105, C106, C107, C108, C109, C110, C111, C112, C113, C114, C115, C116, C117, C118, C119, C120, C121, C122: 0.1uF; C0603; PARTNO C0603C104K5RACTU
D10, D11, D12, D13: TCMT4100; SO16; PARTNO TCMT4100
DD8, DD9: 74HC165D; SO16; PARTNO IN74HC165AD
R237, R238, R239, R240, R241, R242, R243, R244, R245, R246, R247, R248, R249, R250, R251, R252: 4.7kOhm/5%; R1206; PARTNO RC1206JR-074K7L
R253, R254, R255, R256, R257, R258, R259, R260, R261, R262, R263, R264, R265, R266, R267, R268: 1kOhm/5%; R2512; PARTNO RC2512JK-071KL
R269, R270, R271, R272, R273, R274, R275, R276, R277, R278, R279, R280, R281, R282, R283, R284: 10kOhm/1%; R0603; PARTNO RC0603FR-1010KL
VD132, VD133, VD134, VD135, VD136, VD137, VD138, VD139, VD140, VD141, VD142, VD143, VD144, VD145, VD146, VD147: SM6T200A; SMB; PARTNO SM6T200A
VD148, VD149, VD150, VD151, VD152, VD153, VD154, VD155, VD156, VD157, VD158, VD159, VD160, VD161, VD162, VD163: 400V; SMA; PARTNO S1G-E3/61T
XP9: MOLEX-90130-16; PARTNO 90130-1216

Connections:
!SR_SAMPLE: DD8.1 (SH/!LD), DD9.1 (SH/!LD); also elsewhere on the board
+3V3: C121.1, C122.1, DD8.16 (VCC), DD9.16 (VCC), R269.1, R270.1, R271.1, R272.1, R273.1, R274.1, R275.1, R276.1, R277.1, R278.1, R279.1, R280.1, R281.1, R282.1, R283.1, R284.1; also elsewhere on the board
DISCRETE_33: C105.1, D10.10 (TC), DD8.11 (A), R269.2
DISCRETE_34: C106.1, D10.12 (TC), DD8.12 (B), R270.2
DISCRETE_35: C107.1, D10.14 (TC), DD8.13 (C), R271.2
DISCRETE_36: C108.1, D10.16 (TC), DD8.14 (D), R272.2
DISCRETE_37: C109.1, D11.10 (TC), DD8.3 (E), R273.2
DISCRETE_38: C110.1, D11.12 (TC), DD8.4 (F), R274.2
DISCRETE_39: C111.1, D11.14 (TC), DD8.5 (G), R275.2
DISCRETE_40: C112.1, D11.16 (TC), DD8.6 (H), R276.2
DISCRETE_41: C113.1, D12.10 (TC), DD9.11 (A), R277.2
DISCRETE_42: C114.1, D12.12 (TC), DD9.12 (B), R278.2
DISCRETE_43: C115.1, D12.14 (TC), DD9.13 (C), R279.2
DISCRETE_44: C116.1, D12.16 (TC), DD9.14 (D), R280.2
DISCRETE_45: C117.1, D13.10 (TC), DD9.3 (E), R281.2
DISCRETE_46: C118.1, D13.12 (TC), DD9.4 (F), R282.2
DISCRETE_47: C119.1, D13.14 (TC), DD9.5 (G), R283.2
DISCRETE_48: C120.1, D13.16 (TC), DD9.6 (H), R284.2
GND: C105.2, C106.2, C107.2, C108.2, C109.2, C110.2, C111.2, C112.2, C113.2, C114.2, C115.2, C116.2, C117.2, C118.2, C119.2, C120.2, C121.2, C122.2, D10.2 (DC), D10.4 (DC), D10.6 (DC), D10.8 (DC), D10.9 (TE), D10.11 (TE), D10.13 (TE), D10.15 (TE), D11.2 (DC), D11.4 (DC), D11.6 (DC), D11.8 (DC), D11.9 (TE), D11.11 (TE), D11.13 (TE), D11.15 (TE), D12.2 (DC), D12.4 (DC), D12.6 (DC), D12.8 (DC), D12.9 (TE), D12.11 (TE), D12.13 (TE), D12.15 (TE), D13.2 (DC), D13.4 (DC), D13.6 (DC), D13.8 (DC), D13.9 (TE), D13.11 (TE), D13.13 (TE), D13.15 (TE), DD8.8 (GND), DD9.8 (GND), VD132.A, VD133.A, VD134.A, VD135.A, VD136.A, VD137.A, VD138.A, VD139.A, VD140.A, VD141.A, VD142.A, VD143.A, VD144.A, VD145.A, VD146.A, VD147.A; also elsewhere on the board
unnamed: D10.1 (DA), R237.2
unnamed: D10.3 (DA), R238.2
unnamed: D10.5 (DA), R239.2
unnamed: D10.7 (DA), R240.2
unnamed: R253.2, VD148.C
unnamed: D11.1 (DA), R241.2
unnamed: D11.3 (DA), R242.2
unnamed: D11.5 (DA), R243.2
unnamed: D11.7 (DA), R244.2
unnamed: D12.1 (DA), R245.2
unnamed: D12.3 (DA), R246.2
unnamed: D12.5 (DA), R247.2
unnamed: D12.7 (DA), R248.2
unnamed: D13.1 (DA), R249.2
unnamed: D13.3 (DA), R250.2
unnamed: D13.5 (DA), R251.2
unnamed: D13.7 (DA), R252.2
unnamed: R254.2, VD149.C
unnamed: R255.2, VD150.C
unnamed: R256.2, VD151.C
unnamed: R257.2, VD152.C
unnamed: R258.2, VD153.C
unnamed: R259.2, VD154.C
unnamed: R260.2, VD155.C
unnamed: R261.2, VD156.C
unnamed: R262.2, VD157.C
unnamed: R263.2, VD158.C
unnamed: R264.2, VD159.C
unnamed: R265.2, VD160.C
unnamed: R266.2, VD161.C
unnamed: R267.2, VD162.C
unnamed: R268.2, VD163.C
REL_RAW_33: R237.1, R253.1, VD132.C, XP9.1
REL_RAW_34: R238.1, R254.1, VD133.C, XP9.2
REL_RAW_35: R239.1, R255.1, VD134.C, XP9.3
REL_RAW_36: R240.1, R256.1, VD135.C, XP9.4
REL_RAW_37: R241.1, R257.1, VD136.C, XP9.5
REL_RAW_38: R242.1, R258.1, VD137.C, XP9.6
REL_RAW_39: R243.1, R259.1, VD138.C, XP9.7
REL_RAW_40: R244.1, R260.1, VD139.C, XP9.8
REL_RAW_41: R245.1, R261.1, VD140.C, XP9.9
REL_RAW_42: R246.1, R262.1, VD141.C, XP9.10
REL_RAW_43: R247.1, R263.1, VD142.C, XP9.11
REL_RAW_44: R248.1, R264.1, VD143.C, XP9.12
REL_RAW_45: R249.1, R265.1, VD144.C, XP9.13
REL_RAW_46: R250.1, R266.1, VD145.C, XP9.14
REL_RAW_47: R251.1, R267.1, VD146.C, XP9.15
REL_RAW_48: R252.1, R268.1, VD147.C, XP9.16
SR_IN_NSS: DD8.15 (INH), DD9.15 (INH); also elsewhere on the board
SR_OUT_4: DD8.10 (SER); also elsewhere on the board
SR_OUT_5: DD8.9 (QH), DD9.10 (SER)
SR_OUT_6: DD9.9 (QH); also elsewhere on the board
SR_SCK: DD8.2 (CLK), DD9.2 (CLK); also elsewhere on the board
Z_CHECK: VD148.A, VD149.A, VD150.A, VD151.A, VD152.A, VD153.A, VD154.A, VD155.A, VD156.A, VD157.A, VD158.A, VD159.A, VD160.A, VD161.A, VD162.A, VD163.A; also elsewhere on the board

Notes on the sheet:
B(8)
B(6)
