barthess/volat3/hard/mpiovd/mpiovd.brd

## EAGLE design hard/mpiovd/mpiovd.brd (continued)

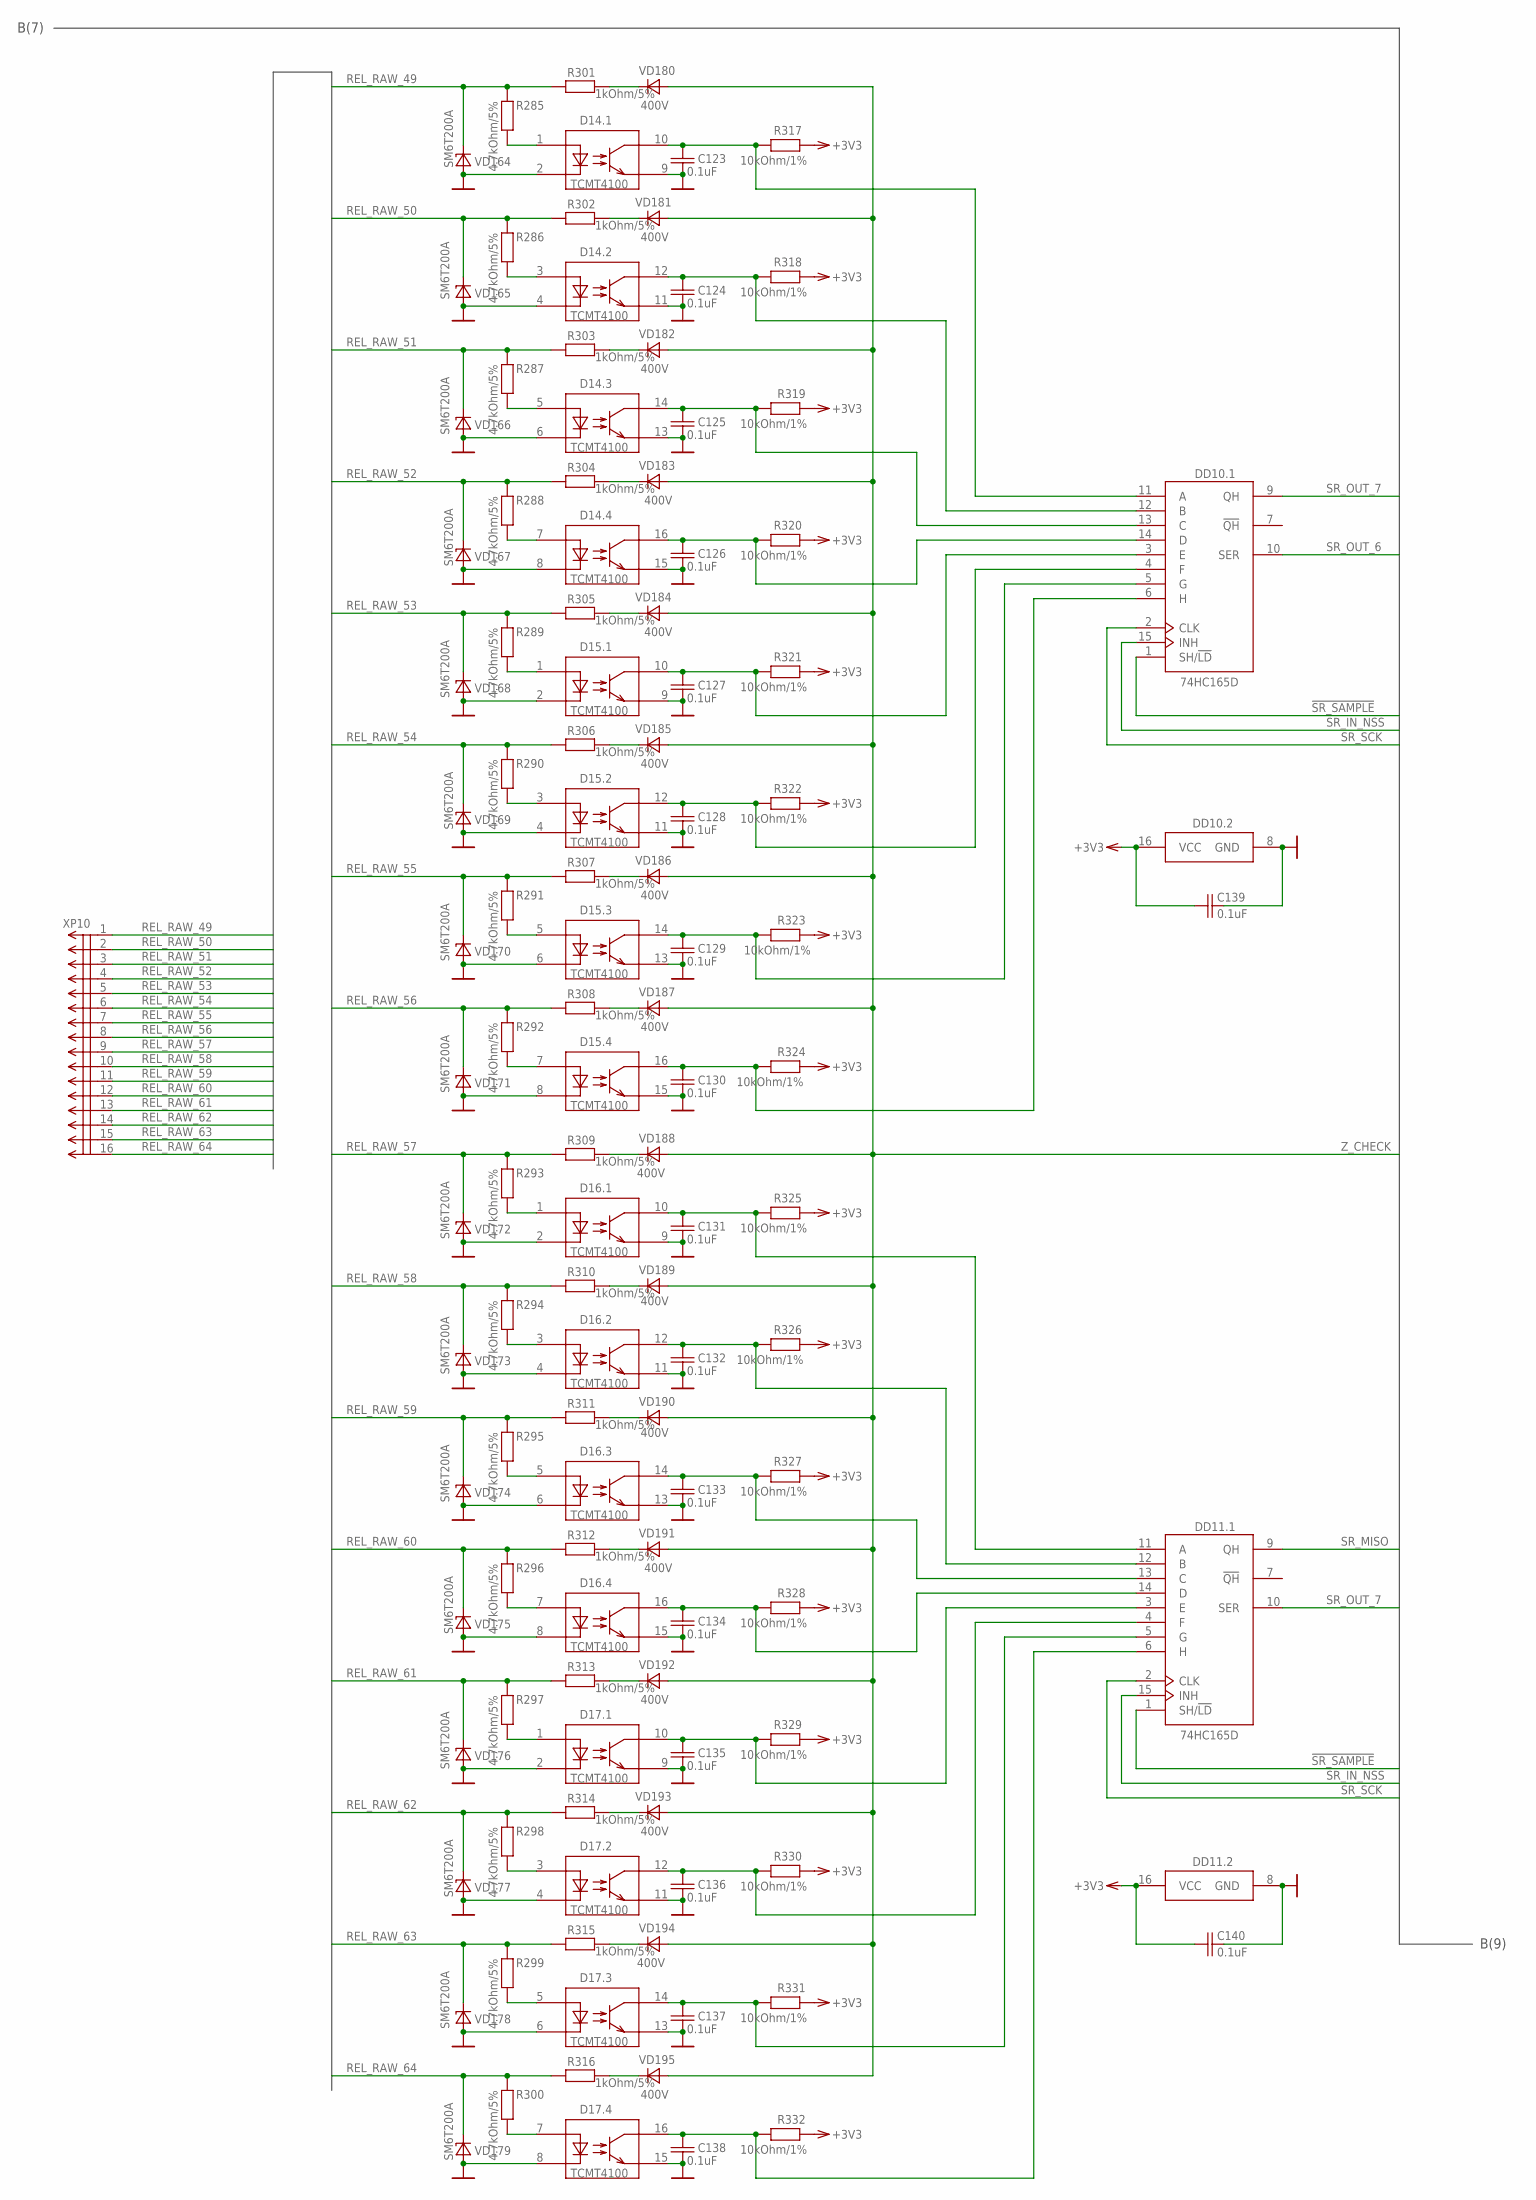
[picture p14: schematic mpiovd.sch, sheet 8, rel4]

Parts:
C123, C124, C125, C126, C127, C128, C129, C130, C131, C132, C133, C134, C135, C136, C137, C138, C139, C140: 0.1uF; C0603; PARTNO C0603C104K5RACTU
D14, D15, D16, D17: TCMT4100; SO16; PARTNO TCMT4100
DD10, DD11: 74HC165D; SO16; PARTNO IN74HC165AD
R285, R286, R287, R288, R289, R290, R291, R292, R293, R294, R295, R296, R297, R298, R299, R300: 4.7kOhm/5%; R1206; PARTNO RC1206JR-074K7L
R301, R302, R303, R304, R305, R306, R307, R308, R309, R310, R311, R312, R313, R314, R315, R316: 1kOhm/5%; R2512; PARTNO RC2512JK-071KL
R317, R318, R319, R320, R321, R322, R323, R324, R325, R326, R327, R328, R329, R330, R331, R332: 10kOhm/1%; R0603; PARTNO RC0603FR-1010KL
VD164, VD165, VD166, VD167, VD168, VD169, VD170, VD171, VD172, VD173, VD174, VD175, VD176, VD177, VD178, VD179: SM6T200A; SMB; PARTNO SM6T200A
VD180, VD181, VD182, VD183, VD184, VD185, VD186, VD187, VD188, VD189, VD190, VD191, VD192, VD193, VD194, VD195: 400V; SMA; PARTNO S1G-E3/61T
XP10: MOLEX-90130-16; PARTNO 90130-1216

Connections:
!SR_SAMPLE: DD10.1 (SH/!LD), DD11.1 (SH/!LD); also elsewhere on the board
+3V3: C139.1, C140.1, DD10.16 (VCC), DD11.16 (VCC), R317.1, R318.1, R319.1, R320.1, R321.1, R322.1, R323.1, R324.1, R325.1, R326.1, R327.1, R328.1, R329.1, R330.1, R331.1, R332.1; also elsewhere on the board
DISCRETE_49: C123.1, D14.10 (TC), DD10.11 (A), R317.2
DISCRETE_50: C124.1, D14.12 (TC), DD10.12 (B), R318.2
DISCRETE_51: C125.1, D14.14 (TC), DD10.13 (C), R319.2
DISCRETE_52: C126.1, D14.16 (TC), DD10.14 (D), R320.2
DISCRETE_53: C127.1, D15.10 (TC), DD10.3 (E), R321.2
DISCRETE_54: C128.1, D15.12 (TC), DD10.4 (F), R322.2
DISCRETE_55: C129.1, D15.14 (TC), DD10.5 (G), R323.2
DISCRETE_56: C130.1, D15.16 (TC), DD10.6 (H), R324.2
DISCRETE_57: C131.1, D16.10 (TC), DD11.11 (A), R325.2
DISCRETE_58: C132.1, D16.12 (TC), DD11.12 (B), R326.2
DISCRETE_59: C133.1, D16.14 (TC), DD11.13 (C), R327.2
DISCRETE_60: C134.1, D16.16 (TC), DD11.14 (D), R328.2
DISCRETE_61: C135.1, D17.10 (TC), DD11.3 (E), R329.2
DISCRETE_62: C136.1, D17.12 (TC), DD11.4 (F), R330.2
DISCRETE_63: C137.1, D17.14 (TC), DD11.5 (G), R331.2
DISCRETE_64: C138.1, D17.16 (TC), DD11.6 (H), R332.2
GND: C123.2, C124.2, C125.2, C126.2, C127.2, C128.2, C129.2, C130.2, C131.2, C132.2, C133.2, C134.2, C135.2, C136.2, C137.2, C138.2, C139.2, C140.2, D14.2 (DC), D14.4 (DC), D14.6 (DC), D14.8 (DC), D14.9 (TE), D14.11 (TE), D14.13 (TE), D14.15 (TE), D15.2 (DC), D15.4 (DC), D15.6 (DC), D15.8 (DC), D15.9 (TE), D15.11 (TE), D15.13 (TE), D15.15 (TE), D16.2 (DC), D16.4 (DC), D16.6 (DC), D16.8 (DC), D16.9 (TE), D16.11 (TE), D16.13 (TE), D16.15 (TE), D17.2 (DC), D17.4 (DC), D17.6 (DC), D17.8 (DC), D17.9 (TE), D17.11 (TE), D17.13 (TE), D17.15 (TE), DD10.8 (GND), DD11.8 (GND), VD164.A, VD165.A, VD166.A, VD167.A, VD168.A, VD169.A, VD170.A, VD171.A, VD172.A, VD173.A, VD174.A, VD175.A, VD176.A, VD177.A, VD178.A, VD179.A; also elsewhere on the board
unnamed: R301.2, VD180.C
unnamed: R302.2, VD181.C
unnamed: R303.2, VD182.C
unnamed: R304.2, VD183.C
unnamed: R305.2, VD184.C
unnamed: R306.2, VD185.C
unnamed: R307.2, VD186.C
unnamed: R308.2, VD187.C
unnamed: R309.2, VD188.C
unnamed: R310.2, VD189.C
unnamed: R311.2, VD190.C
unnamed: R312.2, VD191.C
unnamed: R313.2, VD192.C
unnamed: R314.2, VD193.C
unnamed: R315.2, VD194.C
unnamed: R316.2, VD195.C
unnamed: D14.1 (DA), R285.2
unnamed: D14.3 (DA), R286.2
unnamed: D14.5 (DA), R287.2
unnamed: D14.7 (DA), R288.2
unnamed: D15.1 (DA), R289.2
unnamed: D15.3 (DA), R290.2
unnamed: D15.5 (DA), R291.2
unnamed: D15.7 (DA), R292.2
unnamed: D16.1 (DA), R293.2
unnamed: D16.3 (DA), R294.2
unnamed: D16.5 (DA), R295.2
unnamed: D16.7 (DA), R296.2
unnamed: D17.1 (DA), R297.2
unnamed: D17.3 (DA), R298.2
unnamed: D17.5 (DA), R299.2
unnamed: D17.7 (DA), R300.2
REL_RAW_49: R285.1, R301.1, VD164.C, XP10.1
REL_RAW_50: R286.1, R302.1, VD165.C, XP10.2
REL_RAW_51: R287.1, R303.1, VD166.C, XP10.3
REL_RAW_52: R288.1, R304.1, VD167.C, XP10.4
REL_RAW_53: R289.1, R305.1, VD168.C, XP10.5
REL_RAW_54: R290.1, R306.1, VD169.C, XP10.6
REL_RAW_55: R291.1, R307.1, VD170.C, XP10.7
REL_RAW_56: R292.1, R308.1, VD171.C, XP10.8
REL_RAW_57: R293.1, R309.1, VD172.C, XP10.9
REL_RAW_58: R294.1, R310.1, VD173.C, XP10.10
REL_RAW_59: R295.1, R311.1, VD174.C, XP10.11
REL_RAW_60: R296.1, R312.1, VD175.C, XP10.12
REL_RAW_61: R297.1, R313.1, VD176.C, XP10.13
REL_RAW_62: R298.1, R314.1, VD177.C, XP10.14
REL_RAW_63: R299.1, R315.1, VD178.C, XP10.15
REL_RAW_64: R300.1, R316.1, VD179.C, XP10.16
SR_IN_NSS: DD10.15 (INH), DD11.15 (INH); also elsewhere on the board
SR_MISO: DD11.9 (QH); also elsewhere on the board
SR_OUT_6: DD10.10 (SER); also elsewhere on the board
SR_OUT_7: DD10.9 (QH), DD11.10 (SER)
SR_SCK: DD10.2 (CLK), DD11.2 (CLK); also elsewhere on the board
Z_CHECK: VD180.A, VD181.A, VD182.A, VD183.A, VD184.A, VD185.A, VD186.A, VD187.A, VD188.A, VD189.A, VD190.A, VD191.A, VD192.A, VD193.A, VD194.A, VD195.A; also elsewhere on the board

Notes on the sheet:
B(9)
B(7)

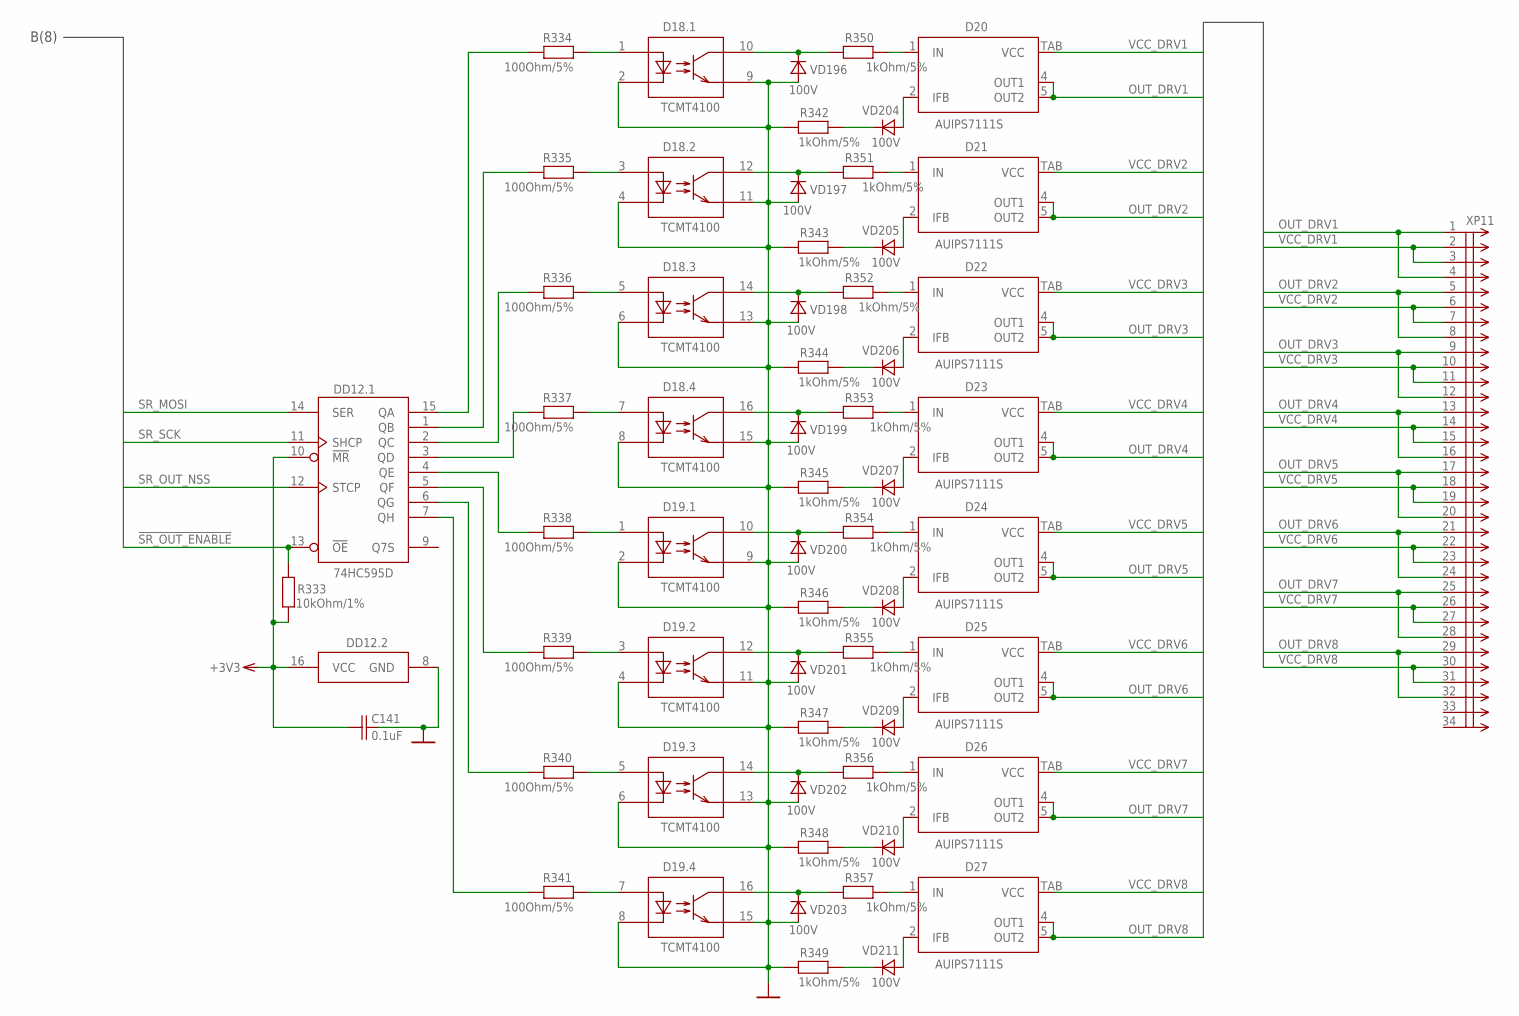
[picture p15: schematic mpiovd.sch, sheet 9, Drivers]

Parts:
C141: 0.1uF; C0603; PARTNO C0603C104K5RACTU
D18, D19: TCMT4100; SO16; PARTNO TCMT4100
D20, D21, D22, D23, D24, D25, D26, D27: AUIPS7111S; TO252-5-11; PARTNO AUIPS7111S
DD12: 74HC595D; SO16; PARTNO IN74HC595AD
R333: 10kOhm/1%; R0603; PARTNO RC0603FR-1010KL
R334, R335, R336, R337, R338, R339, R340, R341: 100Ohm/5%; R0603; PARTNO ERJ3GEYJ101V
R342, R343, R344, R345, R346, R347, R348, R349, R350, R351, R352, R353, R354, R355, R356, R357: 1kOhm/5%; R0805; PARTNO ERJ6GEYJ102V
VD196, VD197, VD198, VD199, VD200, VD201, VD202, VD203, VD204, VD205, VD206, VD207, VD208, VD209, VD210, VD211: 100V; SOD323; PARTNO 1N4148WS-V-GS18
XP11: MOLEX-90130-34; PARTNO 90130-1234

Connections:
!SR_OUT_ENABLE: DD12.13 (!OE), R333.1; also elsewhere on the board
+3V3: C141.1, DD12.10 (!MR), DD12.16 (VCC), R333.2; also elsewhere on the board
GND: C141.2, D18.2 (DC), D18.4 (DC), D18.6 (DC), D18.8 (DC), D18.9 (TE), D18.11 (TE), D18.13 (TE), D18.15 (TE), D19.2 (DC), D19.4 (DC), D19.6 (DC), D19.8 (DC), D19.9 (TE), D19.11 (TE), D19.13 (TE), D19.15 (TE), DD12.8 (GND), R342.1, R343.1, R344.1, R345.1, R346.1, R347.1, R348.1, R349.1, VD196.A, VD197.A, VD198.A, VD199.A, VD200.A, VD201.A, VD202.A, VD203.A; also elsewhere on the board
unnamed: D27.1 (IN), R357.2
unnamed: D26.1 (IN), R356.2
unnamed: D25.1 (IN), R355.2
unnamed: D24.1 (IN), R354.2
unnamed: D23.1 (IN), R353.2
unnamed: D22.1 (IN), R352.2
unnamed: D21.1 (IN), R351.2
unnamed: D20.1 (IN), R350.2
unnamed: D19.7 (DA), R341.1
unnamed: D18.10 (TC), R350.1, VD196.C
unnamed: D18.12 (TC), R351.1, VD197.C
unnamed: D18.14 (TC), R352.1, VD198.C
unnamed: D18.16 (TC), R353.1, VD199.C
unnamed: D19.10 (TC), R354.1, VD200.C
unnamed: D19.12 (TC), R355.1, VD201.C
unnamed: D19.14 (TC), R356.1, VD202.C
unnamed: D19.16 (TC), R357.1, VD203.C
unnamed: D19.5 (DA), R340.1
unnamed: D19.3 (DA), R339.1
unnamed: D19.1 (DA), R338.1
unnamed: D18.7 (DA), R337.1
unnamed: D18.5 (DA), R336.1
unnamed: D18.3 (DA), R335.1
unnamed: D18.1 (DA), R334.1
unnamed: DD12.15 (QA), R334.2
unnamed: D20.2 (IFB), VD204.A
unnamed: D21.2 (IFB), VD205.A
unnamed: D22.2 (IFB), VD206.A
unnamed: D23.2 (IFB), VD207.A
unnamed: D24.2 (IFB), VD208.A
unnamed: D25.2 (IFB), VD209.A
unnamed: D26.2 (IFB), VD210.A
unnamed: D27.2 (IFB), VD211.A
unnamed: DD12.1 (QB), R335.2
unnamed: DD12.2 (QC), R336.2
unnamed: DD12.7 (QH), R341.2
unnamed: DD12.6 (QG), R340.2
unnamed: DD12.5 (QF), R339.2
unnamed: R342.2, VD204.C
unnamed: R343.2, VD205.C
unnamed: R344.2, VD206.C
unnamed: R345.2, VD207.C
unnamed: R346.2, VD208.C
unnamed: DD12.3 (QD), R337.2
unnamed: DD12.4 (QE), R338.2
unnamed: R347.2, VD209.C
unnamed: R348.2, VD210.C
unnamed: R349.2, VD211.C
OUT_DRV1: D20.4 (OUT1), D20.5 (OUT2), XP11.1, XP11.4
OUT_DRV2: D21.4 (OUT1), D21.5 (OUT2), XP11.5, XP11.8
OUT_DRV3: D22.4 (OUT1), D22.5 (OUT2), XP11.9, XP11.12
OUT_DRV4: D23.4 (OUT1), D23.5 (OUT2), XP11.13, XP11.16
OUT_DRV5: D24.4 (OUT1), D24.5 (OUT2), XP11.17, XP11.20
OUT_DRV6: D25.4 (OUT1), D25.5 (OUT2), XP11.21, XP11.24
OUT_DRV7: D26.4 (OUT1), D26.5 (OUT2), XP11.25, XP11.28
OUT_DRV8: D27.4 (OUT1), D27.5 (OUT2), XP11.29, XP11.32
SR_MOSI: DD12.14 (SER); also elsewhere on the board
SR_OUT_NSS: DD12.12 (STCP); also elsewhere on the board
SR_SCK: DD12.11 (SHCP); also elsewhere on the board
VCC_DRV1: D20.TAB (VCC), XP11.2, XP11.3
VCC_DRV2: D21.TAB (VCC), XP11.6, XP11.7
VCC_DRV3: D22.TAB (VCC), XP11.10, XP11.11
VCC_DRV4: D23.TAB (VCC), XP11.14, XP11.15
VCC_DRV5: D24.TAB (VCC), XP11.18, XP11.19
VCC_DRV6: D25.TAB (VCC), XP11.22, XP11.23
VCC_DRV7: D26.TAB (VCC), XP11.26, XP11.27
VCC_DRV8: D27.TAB (VCC), XP11.30, XP11.31

Notes on the sheet:
B(8)

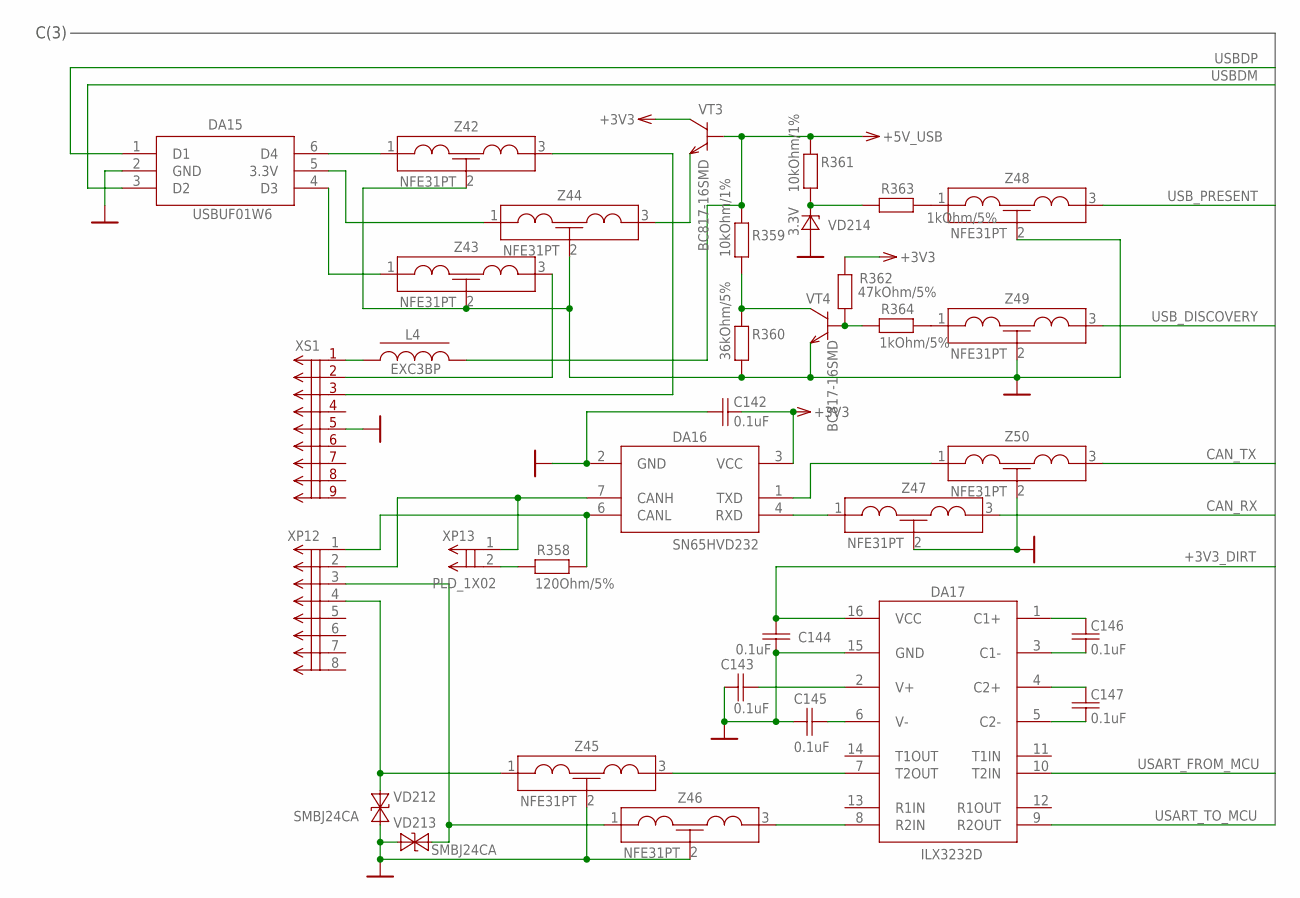
[picture p16: schematic mpiovd.sch, sheet 10, Interfaces]

Parts:
C142, C143, C144, C145, C146, C147: 0.1uF; C0603; PARTNO C0603C104K5RACTU
DA15: USBUF01W6; SOTT323-6L; PARTNO USBUF01W6
DA16: SN65HVD232; SO08; PARTNO SN65HVD232D
DA17: ILX3232D; SO16; PARTNO ILX3232D
L4: EXC3BP; L0603; PARTNO EXC3BP121H
R358: 120Ohm/5%; R1206; PARTNO RC1206JR-07120RL
R359, R361: 10kOhm/1%; R0603; PARTNO RC0603FR-1010KL
R360: 36kOhm/5%; R0603; PARTNO ERJ3GEYJ363V
R362: 47kOhm/5%; R0603; PARTNO ERJ3GEYJ473V
R363, R364: 1kOhm/5%; R0805; PARTNO ERJ6GEYJ102V
VD212, VD213: SMBJ24CA; SMB-BIDIR; PARTNO SMBJ24CA
VD214: 3.3V; SOD80; PARTNO BZV55-C3V3
VT3, VT4: BC817-16SMD; SOT23-BEC; PARTNO BC817
XP12: MOLEX-90130-08; PARTNO 90130-1208
XP13: PLD_1X02; PARTNO 825433-2
XS1: USB-MINIB_(SOVOK-UGO); USB-MINIB; PARTNO MUBS1-05SN2
Z42, Z43, Z44, Z45, Z46, Z47, Z48, Z49, Z50: NFE31PT; NFE31; PARTNO NFE31PT152Z1E9

Connections:
+3V3: C142.2, DA16.3 (VCC), R362.2, VT3.C; also elsewhere on the board
+3V3_DIRT: C144.1, DA17.16 (VCC); also elsewhere on the board
+5V_USB: L4.2, R359.2, R361.2, VT3.B; also elsewhere on the board
CANH: DA16.7 (CANH), XP12.2, XP13.1
CANL: DA16.6 (CANL), R358.2, XP12.1
CAN_RX: Z47.3; also elsewhere on the board
CAN_TX: Z50.3; also elsewhere on the board
D+: XS1.D+ (3), Z42.3
D-: XS1.D- (2), Z43.3
FROM_RS232: VD213.A2, XP12.3, Z46.1
GND: C142.1, C143.2, C144.2, C145.2, DA15.2 (GND), DA16.2 (GND), DA17.15 (GND), R360.1, VD212.A1, VD213.A1, VD214.A, VT4.E, XS1.GND (5), Z42.2, Z43.2, Z44.2, Z45.2, Z46.2, Z47.2, Z48.2, Z49.2, Z50.2; also elsewhere on the board
unnamed: R358.1, XP13.2
unnamed: R362.1, R364.1, VT4.B
unnamed: R359.1, R360.2, VT4.C
unnamed: VT3.E, Z44.3
unnamed: R361.1, R363.1, VD214.C
unnamed: L4.1, XS1.VBUS (1)
unnamed: C143.1, DA17.2 (V+)
unnamed: C145.1, DA17.6 (V-)
unnamed: DA17.8 (R2IN), Z46.3
unnamed: DA17.7 (T2OUT), Z45.3
unnamed: C146.2, DA17.3 (C1-)
unnamed: C146.1, DA17.1 (C1+)
unnamed: C147.1, DA17.4 (C2+)
unnamed: C147.2, DA17.5 (C2-)
unnamed: DA16.1 (TXD), Z50.1
unnamed: DA16.4 (RXD), Z47.1
unnamed: DA15.5 (3.3V), Z44.1
unnamed: R364.2, Z49.1
unnamed: R363.2, Z48.1
unnamed: DA15.4 (D3), Z43.1
unnamed: DA15.6 (D4), Z42.1
TO_RS232: VD212.A2, XP12.4, Z45.1
USART_FROM_MCU: DA17.10 (T2IN); also elsewhere on the board
USART_TO_MCU: DA17.9 (R2OUT); also elsewhere on the board
USBDM: DA15.3 (D2); also elsewhere on the board
USBDP: DA15.1 (D1); also elsewhere on the board
USB_DISCOVERY: Z49.3; also elsewhere on the board
USB_PRESENT: Z48.3; also elsewhere on the board

Notes on the sheet:
C(3)

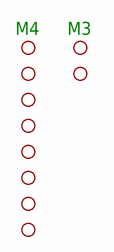
[picture p17: schematic mpiovd.sch, sheet 11, hidden devices]

Parts:
JP1, JP2, JP3, JP4, JP5, JP6, JP7, JP8: STAND-OFF-M4
JP9, JP10: STAND-OFF-M3

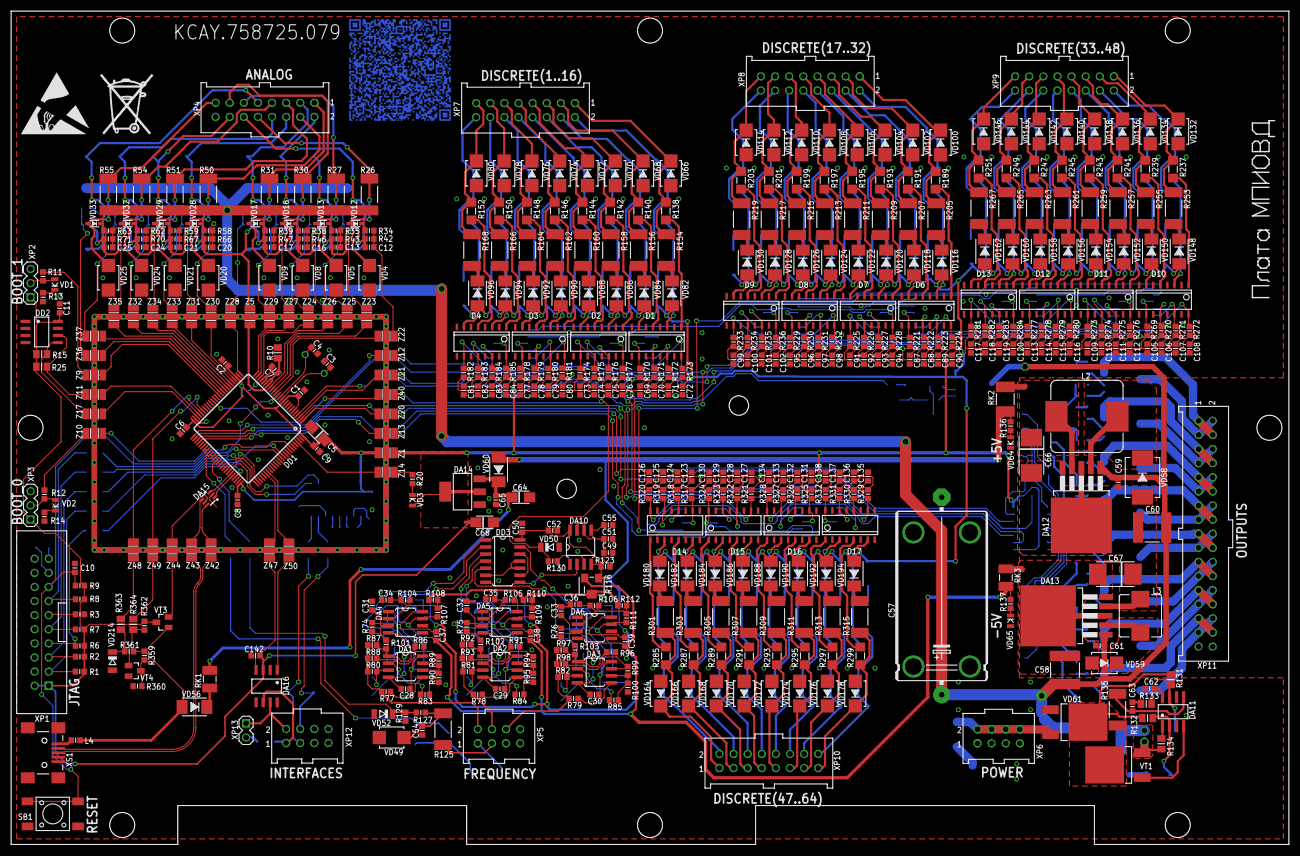
[picture p18: board mpiovd.brd from above]

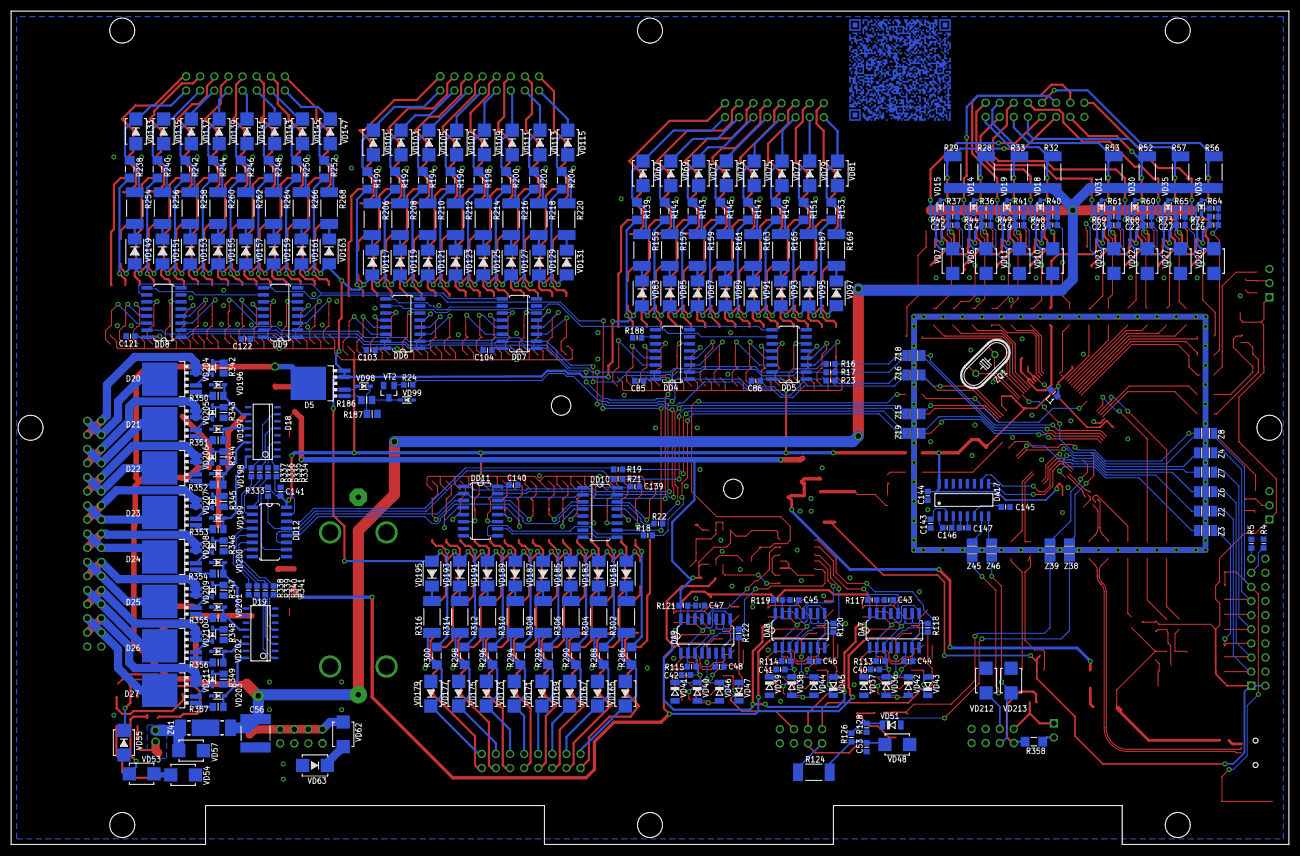
[picture p19: board mpiovd.brd from below]

Board: 2 copper layers, 230.0 x 150.0 mm, 871 parts (335 on the bottom side), 591 nets.

Other parts of the board:
U$1: STATIC_12
U$2: NOT_RECYCLE_12
U$3: QR
