barthess/volat3/hard/loadump_test/loaddump.brd

## EAGLE design hard/loadump_test/loaddump.brd (2012-03-21)

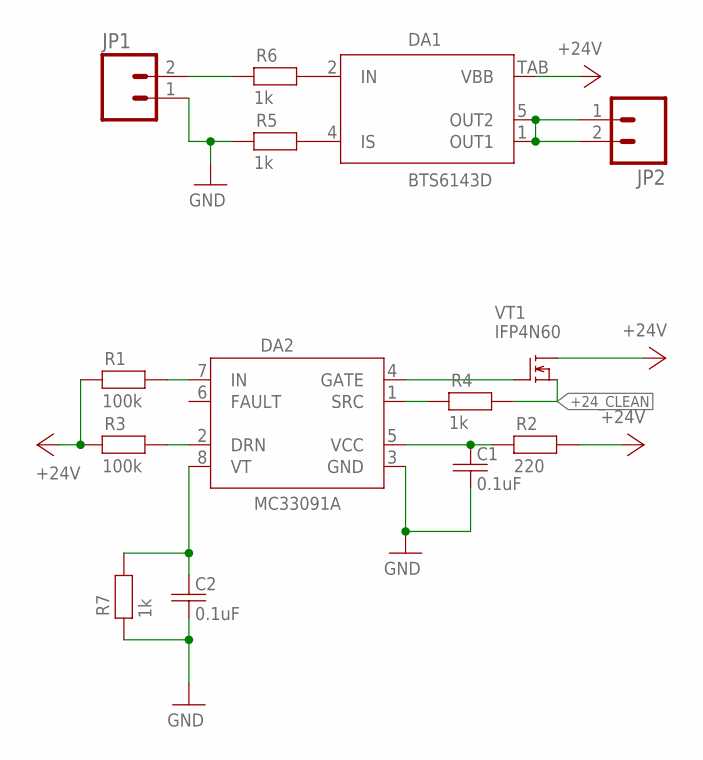
[picture p20: schematic loaddump.sch]

Parts:
C1, C2: 0.1uF; C0805
DA1: BTS6143D; TO252-5-11
DA2: MC33091A; SO08
JP1, JP2: M02PTH3; 1X02_LONGPADS
R1, R3: 100k; R0805
R2: 220; 0922/22
R4, R5, R6, R7: 1k; R0805
VT1: IFP4N60; TO220

Connections:
+24V: DA1.TAB (VBB), R1.1, R2.2, R3.1, VT1.2 (D)
+24_CLEAN: R4.2, VT1.3 (S)
GND: C1.2, C2.2, DA2.3 (GND), JP1.1, R5.1, R7.1
unnamed: DA2.7 (IN), R1.2
unnamed: DA2.4 (GATE), VT1.1 (G)
unnamed: C1.1, DA2.5 (VCC), R2.1
unnamed: DA2.2 (DRN), R3.2
unnamed: DA2.1 (SRC), R4.1
unnamed: DA1.1 (OUT1), DA1.5 (OUT2), JP2.1, JP2.2
unnamed: DA1.4 (IS), R5.2
unnamed: DA1.2 (IN), R6.2
unnamed: JP1.2, R6.1
unnamed: C2.1, DA2.8 (VT), R7.2

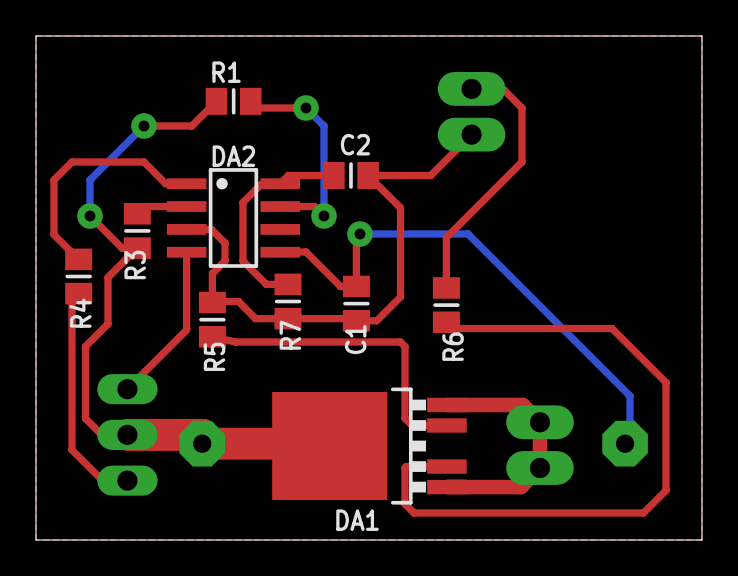
[picture p21: board loaddump.brd from above]

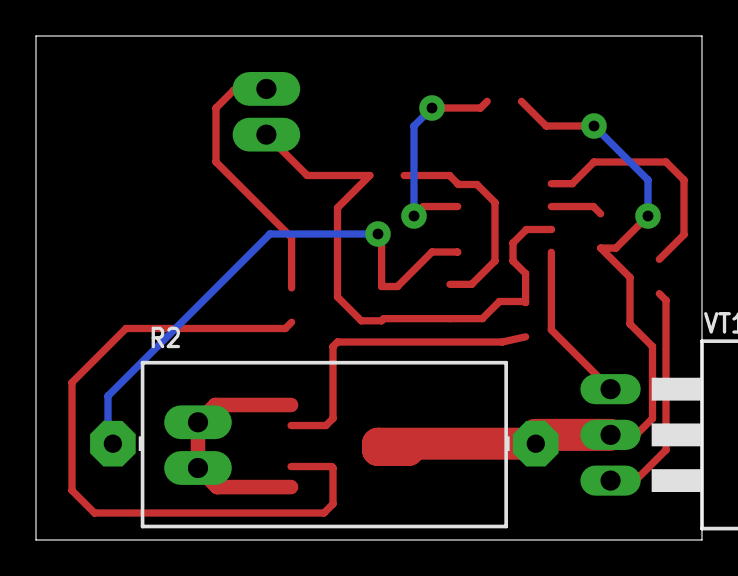
[picture p22: board loaddump.brd from below]

Board: 2 copper layers, 37.0 x 28.0 mm, 14 parts (2 on the bottom side), 13 nets.
