barthess/volat3/hard/pcb/main.brd

## EAGLE design hard/pcb/main.brd (continued)

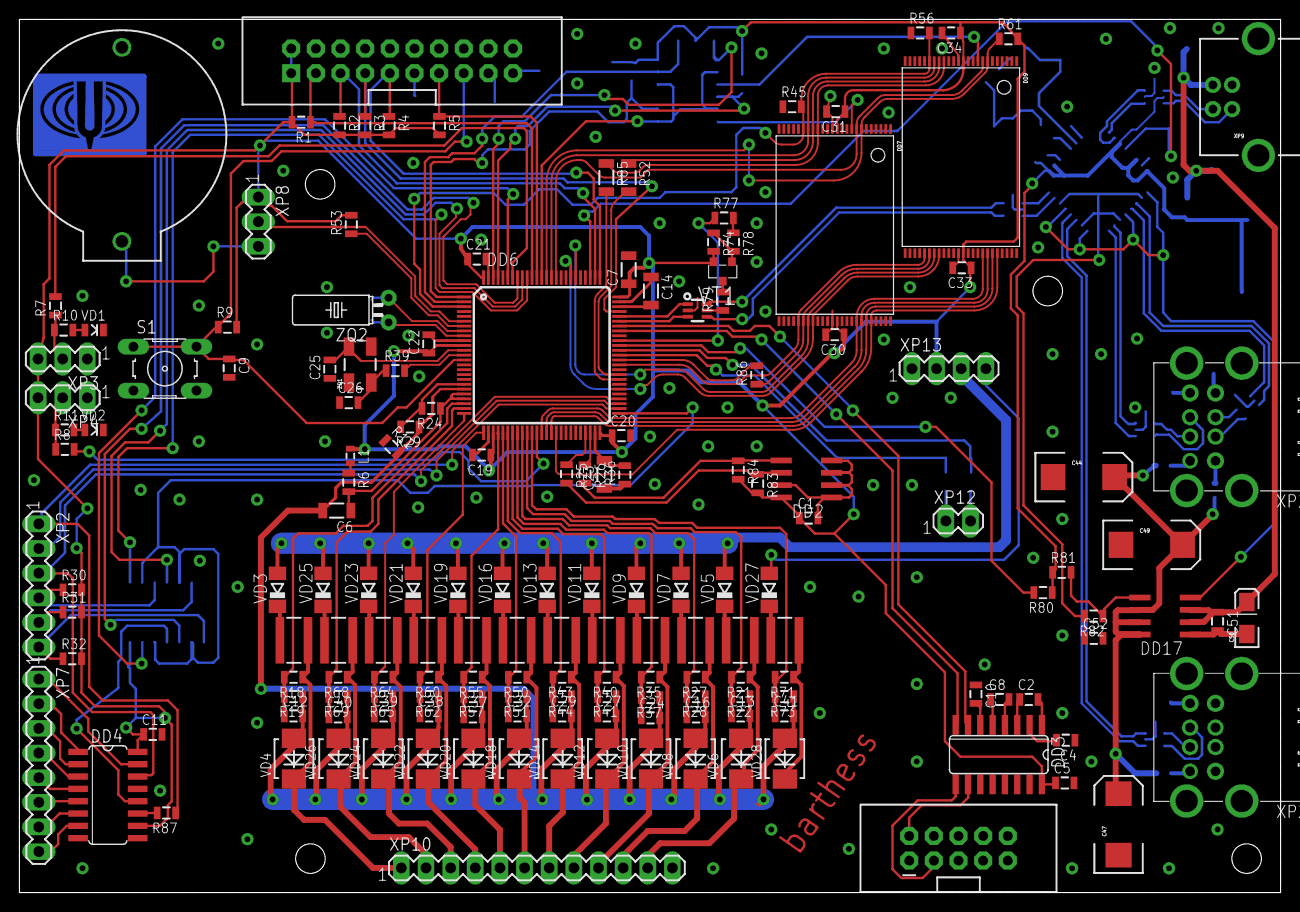
[picture p29: board main.brd from above]

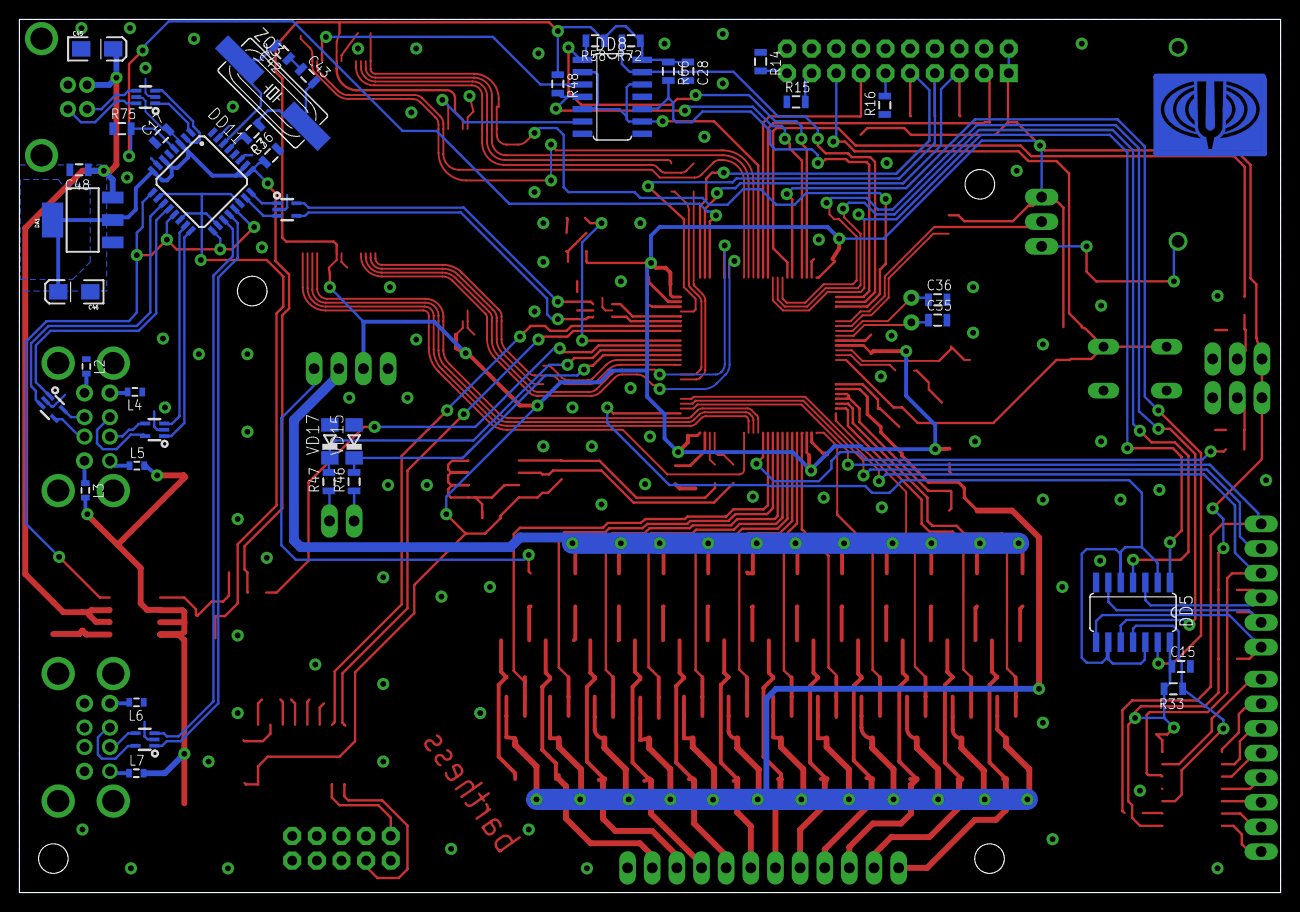
[picture p30: board main.brd from below]

Board: 2 copper layers, 130.0 x 90.0 mm, 212 parts (41 on the bottom side), 176 nets.
