barthess/volat3/soft/bnap/board.c

/*
    ChibiOS/RT - Copyright (C) 2006,2007,2008,2009,2010,
                 2011,2012 Giovanni Di Sirio.

    This file is part of ChibiOS/RT.

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
    You should have received a copy of the GNU General Public License
    along with this program.  If not, see <http://www.gnu.org/licenses/>.
*/

#include "ch.h"
#include "hal.h"
#include "board.h"

/**
 * @brief   PAL setup.
 * @details Digital I/O ports static configuration as defined in @p board.h.
 *          This variable is used by the HAL when initializing the PAL driver.
 */
#if HAL_USE_PAL || defined(__DOXYGEN__)
const PALConfig pal_default_config =
{
  {VAL_PIOA_ODSR, VAL_PIOA_OSR, VAL_PIOA_PUSR},
#if (SAM7_PLATFORM == SAM7X128) || (SAM7_PLATFORM == SAM7X256) || \
    (SAM7_PLATFORM == SAM7X512) || (SAM7_PLATFORM == SAM7A3)
  {VAL_PIOB_ODSR, VAL_PIOB_OSR, VAL_PIOB_PUSR}
#endif
};
#endif

/*
 * SYS IRQ handling here.
 */
static CH_IRQ_HANDLER(SYSIrqHandler) {

  CH_IRQ_PROLOGUE();

  if (AT91C_BASE_PITC->PITC_PISR & AT91C_PITC_PITS) {
    (void) AT91C_BASE_PITC->PITC_PIVR;
    chSysLockFromIsr();
    chSysTimerHandlerI();
    chSysUnlockFromIsr();
  }
  
#if USE_SAM7_DBGU_UART
  if (AT91C_BASE_DBGU->DBGU_CSR & 
    (AT91C_US_RXRDY | AT91C_US_TXRDY | AT91C_US_PARE | AT91C_US_FRAME | AT91C_US_OVRE | AT91C_US_RXBRK)) {
    sd_lld_serve_interrupt(&SDDBG);
  }
#endif  
  AT91C_BASE_AIC->AIC_EOICR = 0;
  CH_IRQ_EPILOGUE();
}

/*
 * Early initialization code.
 * This initialization must be performed just after stack setup and before
 * any other initialization.
 */
void __early_init(void) {
  
  /* Watchdog disabled.*/
  AT91C_BASE_WDTC->WDTC_WDMR = AT91C_WDTC_WDDIS;
  
  at91sam7_clock_init();
}

#if HAL_USE_MMC_SPI
/**
 * Board-related functions related to the MMC_SPI driver.
 */
bool_t mmc_lld_is_card_inserted(MMCDriver *mmcp) {

  (void)mmcp;
  return palReadPad(IOPORT1, PIOA_MMC_CP);
}

/**
 * Board-related functions related to the MMC_SPI driver.
 */
bool_t mmc_lld_is_write_protected(MMCDriver *mmcp) {

  (void)mmcp;
  //return palReadPad(IOPORT1, PIOA_MMC_WP);
  return FALSE; /* защита от записи нужна только лохам и слабакам */
}
#endif /* HAL_USE_MMC_SPI */

/*
 * Board-specific initialization code.
 */
void boardInit(void) {

  /*
   * PIT Initialization.
   */
  AIC_ConfigureIT(AT91C_ID_SYS,
                  AT91C_AIC_SRCTYPE_HIGH_LEVEL | (AT91C_AIC_PRIOR_HIGHEST - 1),
                  SYSIrqHandler);
  AIC_EnableIT(AT91C_ID_SYS);
  AT91C_BASE_PITC->PITC_PIMR = (MCK / 16 / CH_FREQUENCY) - 1;
  AT91C_BASE_PITC->PITC_PIMR |= AT91C_PITC_PITEN | AT91C_PITC_PITIEN;

  /* tune reset pins as open collector */
  AT91C_BASE_PIOA->PIO_MDER  = PIOA_GSM_RESET_MASK;
  AT91C_BASE_PIOA->PIO_PPUDR = PIOA_GSM_RESET_MASK;
  AT91C_BASE_PIOA->PIO_MDER  = PIOA_GPS_RESET_MASK;
  AT91C_BASE_PIOA->PIO_PPUDR = PIOA_GPS_RESET_MASK;

  /*
   * RTS/CTS pins enabled for GSM USART only.
   */
//  AT91C_BASE_PIOB->PIO_PDR   = AT91C_PB24_RTS1  | AT91C_PB25_CTS1;
//  AT91C_BASE_PIOB->PIO_BSR   = AT91C_PIO_PB24   | AT91C_PIO_PB25;
//  AT91C_BASE_PIOB->PIO_PPUDR = AT91C_PIO_PB24   | AT91C_PIO_PB25;
//
  AT91C_BASE_PIOB->PIO_PDR   = AT91C_PB25_CTS1;
  AT91C_BASE_PIOB->PIO_BSR   = AT91C_PIO_PB25;
  AT91C_BASE_PIOB->PIO_PPUDR = AT91C_PIO_PB24   | AT91C_PIO_PB25;
//  AT91C_BASE_PIOB->PIO_OER   = AT91C_PIO_PB24;
}
