barthess/volat3/soft/mpiovd/src/message.c

#include "ch.h"
#include "hal.h"

#include "message.h"
#include "param.h"

/*
 ******************************************************************************
 * DEFINES
 ******************************************************************************
 */

/*
 ******************************************************************************
 * EXTERNS
 ******************************************************************************
 */

/* всякие почтовые ящики */
Mailbox tolink_mb;                /* сообщения для отправки через модем */
Mailbox mavlink_param_set_mb;     /* сообщения с параметрами */
Mailbox mavlink_command_long_mb;  /* сообщения с командами */

/* переменные, касающиеся мавлинка */
mavlink_system_t              mavlink_system_struct;
mavlink_command_long_t        mavlink_command_long_struct;
mavlink_set_mode_t            mavlink_set_mode_struct;

mavlink_mpiovd_sensors_t      mpiovd_sensors_struct;
mavlink_debug_vect_t          mpiovd_debug_vect_struct;

/*
 ******************************************************************************
 * GLOBAL VARIABLES
 ******************************************************************************
 */
/* буфера для почтовых ящиков */
static msg_t tolink_mb_buf[10];
static msg_t param_mb_buf[2];
static msg_t mavlinkcmd_mb_buf[2];

/*
 ******************************************************************************
 * PROTOTYPES
 ******************************************************************************
 */

/*
 *******************************************************************************
 *******************************************************************************
 * LOCAL FUNCTIONS
 *******************************************************************************
 *******************************************************************************
 */

/*
 *******************************************************************************
 * EXPORTED FUNCTIONS
 *******************************************************************************
 */

void MsgInit(void){
  /* инициализация почтовых ящиков */
  chMBInit(&tolink_mb,                tolink_mb_buf,          (sizeof(tolink_mb_buf)/sizeof(msg_t)));
  chMBInit(&mavlink_param_set_mb,     param_mb_buf,           (sizeof(param_mb_buf)/sizeof(msg_t)));
  chMBInit(&mavlink_command_long_mb,  mavlinkcmd_mb_buf,      (sizeof(mavlinkcmd_mb_buf)/sizeof(msg_t)));
}

void MavInit(void){
  /* первоначальная настройка мавлинка */
  mavlink_system_struct.sysid  = *(uint8_t *)ValueSearch("SYS_ID");  ///< ID 20 for this airplane
  mavlink_system_struct.compid = MAV_COMP_ID_MPIOVD;     ///< The component sending the message, it could be also a Linux process
  mavlink_system_struct.state  = MAV_STATE_BOOT;
  mavlink_system_struct.mode   = MAV_MODE_PREFLIGHT;
}
