barthess/volat3/soft/mpiovd/src/sensors/adc_local.h

#ifndef ADC_LOCAL_H_
#define ADC_LOCAL_H_

#include "ch.h"
#include "hal.h"

#include "mavlink.h"

void ADCInitLocal(void);
void adc_process(adcsample_t *in, mavlink_mpiovd_sensors_t *raw);

#endif /* ADC_LOCAL_H_ */
