barthess/volat3/soft/face/log.py

#!/usr/bin/python
# -*- coding: utf-8 -*-

from multiprocessing import Queue
from datetime import datetime
import csv
import time
import struct
import os
from binascii import hexlify

from utils import *
import globalflags
flags = globalflags.flags


# logging facilities
def record(q_log, e_pause, e_kill):
    """ q_log -- очередь сообщений """

    # инициализация записывальшика лога
    st = str(datetime.now())
    clear_datetime = ''
    i = 0
    # заменим двоеточия на точки
    while i < 19:
        if st[i] == ':' :
            clear_datetime += '.'
        else: clear_datetime += st[i]
        i += 1
    # откроем на запись файл
    csvwriter = csv.writer(open("logs/" + clear_datetime + '.csv', 'wb'), delimiter=';')


    dbgprint("**** logwriter ready")
    e_pause.wait()
    dbgprint("**** logwriter run")

    while True:
        if e_kill.is_set():
            dbgprint("**** LogWriter. Kill signal received. Exiting")
            return

        try:
            msg = q_log.get(True, 1)
            rdl = list(msg)
            rdl.insert(0, str(time.time()))
            csvwriter.writerow(rdl)
        except:
            pass




def play(filename, q_tlm, e_pause, e_kill, ):
    """ проигрывалка телеметрии
    Парсит файл лога и передает его в функцию рисования телеметрии.
    Так же отслеживает нажатие клавиш выхода из программы.

    logReader -- объект, представляющий читаемый csv-файл
    """

    logReader = csv.reader(open(filename, 'rb'), delimiter=';')
    rowint = [] # row for integers
    row = logReader.next()
    time_n = float(row[0])
    time_p = float(row[0])
    # ждем, пока нас снимут с паузы
    dbgprint("**** play ready")
    e_pause.wait()
    dbgprint("**** play run")

    for row in logReader:
        if e_kill.is_set():
            dbgprint("**** Play. Kill signal received. Exiting")
            return

        time_p = time_n
        time_n = float(row[0])
        time.sleep(time_n - time_p)

        row = row[1:] # откусываем поле локального времени

        # конвертаем строки в числа
        i = 0
        for st in row:
            rowint.insert(i, int(st))
            i += 1

        q_tlm.put(rowint)
        rowint = [] # очищаем буфер, чтобы он не рос бесконечно
