barthess/volat3/(commit log)

2012-01-08 added hardware dir with files
    [main.brd, main.sch]
2012-01-08 added software
    [template.cfg]
2012-03-04 eagle files converted to new format
    [main.brd, main.sch]
2012-03-04 switch python sources to utf-8
2012-03-07 new board and lib
    [main.brd, main.sch]
2012-03-13 power converter added
    [main.sch]
2012-03-20 switched to new library naming scheme
    [main.sch]
2012-03-21 added pcb for load dump testing
    [loaddump.brd, loaddump.sch, main.sch]
2012-03-25 added simultation of external switcher off
2012-03-29 added board and DRU file for board
    [main.brd]
2012-03-30 bom database renamed
    [volat3-PARTSDB.tsv]
2012-04-01 alalog inputs routed
    [main.brd, main.sch]
2012-04-02 almost ready schematic of power supply
    [main.brd, main.sch, volat3-PARTSDB.tsv]
2012-04-02 loaddump protection placed
    [main.brd, main.sch]
2012-04-03 load dump protection routed
    [main.brd, main.sch]
2012-04-04 analog inputs fixed and rerouted
    [main.brd, main.sch, volat3-PARTSDB.tsv]
2012-04-05 output schematic improvemetns
    [main.brd, main.sch, volat3-PARTSDB.tsv]
2012-04-05 added shift register to output block
    [main.brd, main.sch]
2012-04-06 power supply routed
    [main.brd, main.sch, volat3-PARTSDB.tsv]
2012-04-06 outputs routed
    [main.brd, main.sch]
2012-04-08 placed outputs and power supplys
    [main.brd, main.sch]
2012-04-09 discrete inputs 1..16 routed
    [main.brd, main.sch, volat3-PARTSDB.tsv]
2012-04-09 discrete inputs improvements
    [main.brd, main.sch]
2012-04-09 added one more ceramic input capacitor
    [main.brd, main.sch]
2012-04-10 commit before copying discrete inputs
    [main.brd, main.sch]
2012-04-10 cloned discrete input block
    [main.brd, main.sch]
2012-04-10 minor reorganisation
    [main.brd, main.sch]
2012-04-10 clonned one more discrete input block
    [main.brd, main.sch]
2012-04-10 changed tyco connectors
    [main.brd, main.sch]
2012-04-10 last discrete block cloned
    [main.brd, main.sch]
2012-04-10 interfaces begin
    [main.brd, main.sch, volat3-PARTSDB.tsv]
2012-04-10 added USB connectors
    [main.brd, main.sch]
2012-04-12 finished migration on new 74xx lib
    [main.brd, main.sch]
2012-04-12 added Tussonix filter in input line
    [main.brd, main.sch, volat3-PARTSDB.tsv]
2012-04-13 almost all elements added to DB and almost all schematic ready
    [main.brd, main.sch, volat3-PARTSDB.tsv]
2012-04-17 before final route
    [main.brd, main.sch]
2012-04-18 commit before adding of 2..3 spedometer inputs
    [main.brd]
2012-04-18 lots of routing done
    [main.brd, main.sch]
2012-04-19 added RS232 to UART converter
    [com-uart.brd, com-uart.sch]
2012-04-20 fixed DRC for pcb.by
2012-04-20 pcb totally routed
    [main.brd, main.sch]
2012-04-24 almost finished pcb for com-uart
    [com-uart.brd, com-uart.sch]
2012-04-25 fixed drill sizes
    [main.brd, main.sch]
2012-04-25 found all components for BOM
    [main.brd, main.sch, volat3-PARTSDB.tsv]
2012-04-26 preparing for GOST check
    [main.brd, main.sch, main_BOM.tsv, main_BOM.xls, volat3-PARTSDB.tsv]
2012-04-26 deleted trash files
    [main_BOM.tsv, main_BOM.xls]
2012-04-27 moved sheet
    [main.sch]
2012-04-27 renumber parts
    [main.brd, main.sch]
2012-04-28 smashed all devices on pcb
    [main.brd]
2012-04-28 fixed top silkscreen
    [main.brd, main.sch]
2012-04-28 smashed all bottom
    [main.brd]
2012-04-28 silkscreean finished
    [main.brd, main.sch]
2012-04-28 fixes in DRC
    [main.brd]
2012-04-30 added shcematic E4
    [e4.sch, main.brd]
2012-05-02 moved e4 to separate dir
    [e4.sch]
2012-05-02 fixed grammar in bus names
    [main.brd, main.sch]
2012-05-02 e4 improvements
    [e4.sch]
2012-05-03 added script for automatic update of BOM db
2012-05-03 pcb improvements
    [main.brd, main.sch]
2012-05-03 added automatically updated BOM
    [volat3-PARTSDB.tsv, volat3-PARTSDB_test.tsv]
2012-05-04 updated parts db
    [volat3-PARTSDB.tsv]
2012-05-04 fixed name
    [main.brd, main.sch, volat3-PARTSDB.tsv]
2012-05-04 added forgotten attribure PARTNO
    [main.brd, main.sch, volat3-PARTSDB.tsv]
2012-05-04 fixed missing names on optocoupler pins
    [main.sch]
2012-05-04 eskd fixes
    [main.brd, main.sch]
2012-05-07 fixed busses for ESKD
    [main.sch]
2012-05-07 fixed busses for ESKD step 2
    [main.sch]
2012-05-07 fixed frames for ESKD
    [main.sch]
2012-05-07 added cam job for shcematic print to EPS
2012-05-08 before resizing board
    [main.brd, main.sch]
2012-05-08 moved to different board
    [main.brd, main.sch]
2012-05-08 begin of EMI filtering adding
    [main.brd, main.sch]
2012-05-10 filters addition completed
    [main.brd, main.sch]
2012-05-12 fixed reference poit for optocoupler
    [main.brd, main.sch]
2012-05-14 added 2 additional mount holes
    [main.brd, main.sch]
2012-05-14 before net renaming
    [e4.sch, main.sch]
2012-05-14 nets renamed
    [e4.sch, main.brd, main.sch]
2012-05-14 nets on e4 renamed
    [e4.sch]
2012-05-14 fixed additional mounting holes
    [main.brd]
2012-05-15 fixed mount holes diameter
    [main.brd, main.sch]
2012-05-16 fixed frame in E3
2012-05-18 switched on paper format field
2012-05-18 n contr
    [main.sch]
2012-05-18 fixed molex connector
    [main.brd, main.sch]
2012-05-21 n contr fixes
    [e4.sch]
2012-05-21 added print job for soldering map
    [main.brd, main.sch]
2012-05-22 dimension lines added
    [main.brd]
2012-05-22 path reorganization
    [main.brd, main.sch, volat3-PARTSDB.tsv, volat3-PARTSDB_test.tsv]
2012-05-22 path reorganization 2
    [mpiovd.brd, mpiovd.sch]
2012-05-22 path reorganization 4
    [com-uart.brd, com-uart.sch]
2012-05-22 added some symbols
    [mpiovd.brd, mpiovd.sch]
2012-05-22 added job for generation gerbers in metric system
2012-05-29 usb via ACM work on demo board with 8MHz crystall
2012-05-30 fixed silkscreen after ncontr
    [mpiovd.brd]
2012-05-30 it compiles and works, but very buggy
    [exti_local.c, globalflags.py, halconf.h]
2012-06-04 switch to submoduled microrl
2012-06-04 updated config template
    [template.cfg]
2012-06-05 fixed issue with normal exiting
    [hud.py]
2012-06-13 checkbox girid widget works
    [template.cfg]
2012-06-20 fixed XP12 connector description
    [mpiovd.brd, mpiovd.sch]
2012-07-10 added filtering code
2012-07-10 renamed adc file
2012-07-10 adc code compile now
2012-07-10 configured ADC
2012-07-13 removed FIR filtering code, added alpha-beta filter
2012-07-16 UART, ADC, I2C, heartbeat works
2012-07-16 added SPI code. Not tested
2012-07-19 eeprom moved from i2c2 to i2c1 to solve DMA conflict
2012-07-19 SPI reading works
2012-07-20 discrete sensor normilize skeleton ready
2012-07-27 spi inputs improvements
2012-07-27 adc code begin
2012-07-27 reduced maximum analog filter lengt to 30
2012-07-31 ADC. Voltage measurements with compensation done
2012-08-03 fixes in eeprom parameters
    [main.h]
2012-09-28 add some addtitional measurements
    [resistor.ods]
2012-09-28 rewrited code for ADC compensation
2012-09-28 file move
    [resistor.ods]
2012-10-01 added code to prevent overflow of resistance value
    [adc_local.c]
2012-10-01 now ADC samples ignored during sampling hiZ discrete inputs
2012-10-01 now ADC samples ignored during sampling hiZ discrete inputs. FIXED
    [discrete.h, spi_local.c]
2012-10-04 usb shell starts from thread manager
2012-10-17 added command to show data from sensors in console
2012-10-19 block of pressure meters optimized
2012-10-19 battery indicator optimized
2012-10-19 legs drawing optimized
2012-10-22 added point at 120 celsius for temperature sensor
2012-10-22 template of config file removed
    [default.cfg]
2012-10-22 remapping via config started
    [default.cfg]
2012-10-25 updated todo for PCB
2012-10-29 some fixes in telemetry HUD
    [telemetry.py]
2012-10-30 added config ability for analog sensors map
    [default.cfg]
2012-10-31 tiers block ready
    [default.cfg]
2012-10-31 tiers and legs blocks ready and tested
2012-10-31 added loader for flashing over uart
2012-11-09 sychronization between gps, heartbeat and DM thread works
2012-11-12 i2c and DS1338 works
2012-11-12 i2c files added
2012-11-21 added wrapper for writing to UDP socket
2012-11-22 UI works (leds and buttons)
2012-11-22 deleted unneded fields from sensors structures
2012-11-23 reset pin for modem works
2012-11-25 reduced stack for modem thread
2012-11-26 Face. Changed port number for QGC from 14550 to 14554 to avoid conflicts with networkly connected QGC
    [default.cfg]
2012-11-26 Fixed include of mavlink headers.
    Now extended messages handled correctly.
    [adc_local.h, autopilot.c, halconf.h]
2012-11-27 added fixe for eclipse indexer
    [main.h]
2012-11-29 reduced I2C frequency to allow normal EEPROM functionality
2012-11-29 cosmetical fix in flash loader program
    [stm32loader.py]
2012-11-30 logger code reworked but not tested
    [main.c, main.h, message.c, message.h, microsd.c]
2012-12-03 fixed some potential problems
    [sanity.c, storage.c, timekeeper.c]
2012-12-03 time correction written but needs to be checked
    [main.c, main.h, microsd.c, storage.c, storage.h, timekeeper.c]
2012-12-04 increased I2C speed after changing pull up resistors
2012-12-05 analog00 field in mpiovd sensors packet renamed to voltage_battery
2012-12-05 added switch to disable all DBG checks
2012-12-06 added PIN passing to modem
2012-12-13 gps fix type corrected to conform with mavlink protocol
    [chconf.h, gps.c, main.cpp]
2012-12-15 added thread sending heartbeats in chat application
2012-12-15 added normal error handling and threading for chat.py application
    [chat.py]
2012-12-19 added sample of shitty color
2013-01-05 switched off ccache in Makefiles
