barthess/volat3/(notices)

Notices in the files:
soft/mpiovd/stm32loader.py:
stm32loader is free software; you can redistribute it and/or modify it under
the terms of the GNU General Public License as published by the Free
parts and their libraries:
inductor-cooper: Copyright (C) 2010, Bob Starr
SparkFun: Licensing: CC v3.0 Share-Alike You are welcome to use this library for commercial purposes.
